Salmon-Built-Designs/QUTMS_BMS/hardware/BMS_2020/BMS-P00-V01.PcbDoc.htm

Reporting Options

# File in Previous Format

Date | : | 10/11/2021
Time | : | 4:04:51 PM
Filename | : | C:\JohnStaffRepos\QUTMS_BMS\hardware\BMS_2020\BMS-P00-V01.PcbDoc

Version | Warning

This file was generated by an earlier version of the software
