Salmon-Built-Designs/QUTMS_BMS/hardware/QUTMS-BMS-TEMPSTRIP-RIGHT-V00/BMS-TEMPSTRIP-RIGHT-P00.PcbDoc.htm

Reporting Options

# File in Newer Format

Date | : | 28/07/2020
Time | : | 12:10:48 PM
Filename | : | C:\Users\n8888833\Documents\GitHub\QUTMS_BMS_2020\hardware\QUTMS-BMS-TEMPSTRIP-RIGHT-V00\BMS-TEMPSTRIP-RIGHT-P00.PcbDoc

Version | Warning
Release 20.0 | CAUTION - Support of propagation delay for primitives

This file was generated by a later version of the software
