Salmon-Built-Designs/QUTMS_BMS/hardware/BMS_2020/LMR14010A_Calculations.xlsx

LMR14010A
Settings |  |  |  | Inductor Calculations |  | Output Capacitor Calulations
Switching Frequency | 0.7 | Mhz |  | L_o min | 70.71 | Cout min | 2.308802309e-05
 | 700 | KHz |  | I_ripple | 6e-08 | Cout min | 8.48
 | 700000 | Hz | f_sw | I_L_RMS | 0.2 | Cout min | 2.142857143e-13
Input Voltage Max | 33 | V | Vin_max | I_L_Peak | 0.3 | R_ESR | 833333.33
Current Out | 0.2 | A | I_o
Ripple Current | 30.00% | % | K_IND | Choosen Lo | 150
Output Voltage | 3.3 | V | V_out
Transient | 0.03 | %
Output Current High | 0.2 | A | I_oH
Output Current Low | 0.05 | A | I_oL
Initial Capacitor Voltage | 3.3 | V | Vi
Voltage Peak Output | 3.399 | V | Vf
delta I_out | 0.8 | I
delta V_out | 0.099 | V
Max voltage ripple | 0.05 | V | V_o_ripple
