Salmon-Built-Designs/QUTMS_BMS/hardware/BMS_2020/BMS-P00-V00.PcbDoc.htm

Reporting Options

# File in Newer Format

Date | : | 1/10/2020
Time | : | 4:02:43 PM
Filename | : | C:\Users\n8888833\Documents\GitHub\QUTMS_BMS\hardware\BMS_2020\BMS-P00-V00.PcbDoc

Version | Warning
Release 20.0 | CAUTION - Support of propagation delay for primitives

This file was generated by a later version of the software
