Salmon-Built-Designs/QUTMS_BMS/hardware/BMS_2020/wideVOptoResistorSelection.PNG

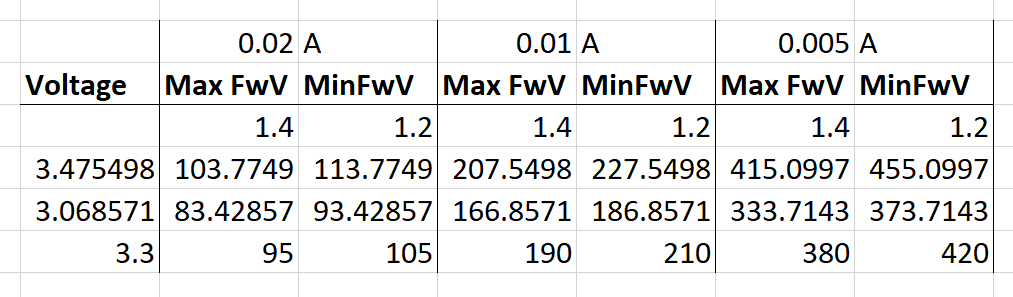
hardware/BMS_2020/wideVOptoResistorSelection.PNG
