Salmon-Built-Designs/QUTMS_BMS/QUTMS-BMS-V00.xlsx

Comment | Description | Designator | Footprint | LibRef | Quantity
100nF | Capacitor, Ceramic, SMD, 100nF, 50V, 5%, X7R, 0603 | C1, C3, C5, C7, C8, C9, C10, C11 | CAP_CERAMIC_0603 | 100nF 50V 5% X7R 0603 | 8
4u7 | Capacitor, Ceramic, SMD, 4u7, 50V, 5%, X7R, 0603 | C2, C4, C6 | CAP_CERAMIC_0603 | 4u7 50V 5% X7R 0603 | 3
100nF 100V | Capacitor, Ceramic, SMD, 100nF, 100V, 5%, X7R, 0603 | C12 | CAP_CERAMIC_0603 | 100nF 100V 5% X7R 0603 | 1
47uF 80V 10% AluPoly 10x10mm | Capacitor, AluPoly, SMD, 47uF, 80V, 10%, AluPoly, 10x10mm | C13 | CAP_ALU_10X10MM | 47uF 80V 10% AluPoly 10x10mm | 1
47uF 16V 1210 | Capacitor, Ceramic, SMD, 47uF, 16V, 5%, X7R, 1210 | C14, C15 | CAP_CERAMIC_0603 | 47uF 16V 10% X7R 1210 | 2
220nF | Capacitor, Ceramic, SMD, 220nF, 50V, 5%, X7R, 0603 | C16A, C16B, C16C, C16D, C16E, C16F, C16G, C16H, C16I, C16J, C17, C20, C25, C26 | CAP_CERAMIC_0603 | 220nF 50V 5% X7R 0603 | 14
1uF 25V | Capacitor, Ceramic, SMD, 1uF, 25V, 5%, X7R, 0603 | C18, C21, C24 | CAP_CERAMIC_0603 | 1uF 25V 5% X7R 0603 | 3
10uF 25V 0805 | Capacitor, Ceramic, SMD, 10uF, 25V, 5%, X7R, 0805 | C19 | CAP_CERAMIC_0805 | 10uF 25V 5% X7R 0805_1 | 1
470nF | Capacitor, Ceramic, SMD, 470nF, 50V, 5%, X7R, 0603 | C22 | CAP_CERAMIC_0603 | 470nF 50V 5% X7R 0603 | 1
10uF 25V 1206 | Capacitor, Ceramic, SMD, 10uF, 25V, 10%, X7R, 1206 | C23 | CAP_CERAMIC_1206 | 10uF 25V 10% X7R 1206 | 1
NUP2105L | NUP2105L | D1 | NUP2105L | NUP2105L | 1
B260A-13-F | Diode, Schottky Barrier Rectifier, 60 V, 2 A, B260A-13-F | D2 | SMA | B260A-13-F | 1
BZT52C5V6-7-F | Diode, SMD, Zender, 5.6V, 7%, 500mW, SOD-123 | D3A, D3B, D3C, D3D, D3E, D3F, D3G, D3H, D3I, D3J | SOD123 | BZT52C5V6-7-F | 10
1N4448WQ-7-F | Diode, SMD, 75V, 5%, 250mA, SOD123 | D4, D5, D6 | SMA | 1N4448WQ-7-F | 3
LED Orange | 603 | DS1, DS2 | LED ORANGE 0603 | LED ORANGE 0603 | 2
LED Blue 0603 | 603 | DS3, DS4 | LED BLUE 0603 | LED BLUE 0603 | 2
3412.0124.22 | FUSE BOARD MOUNT 5A 63VDC 0603 | F1, F2, F3, F4, F5, F6, F7, F8, F9, F10, F11, F12, F13 | 3412.0124.22 | 3412.0124.22 | 13
Fiducial 1MM | Fiducial 1MM | FID1, FID2, FID3, FID4 | FIDUCIAL 1MM | Fiducial 1MM | 4
IDC 10P 2x5 1.27mm | IDC 10P 2x5 1.27mm | J1 | IDC 1.27MM 10P | IDC 10P 2x5 1.27mm | 1
IDC 8P 2x4 | IDC 8P 2x5 | J2, J3 | IDC 2.54MM 8P | IDC 8P 2x4 | 2
Jumper 2Way Pins | Jumper 2Way Side Pins | J4, J5, J6 | Jumper_2Way_Pin | Jumper 2Way Side Pins | 3
0526100672 | 0526100672 | J7A, J7B, J7C, J7D | 526100672 | 6PinMOLEX | 4
Bleed Header | Header, 2-Pin | J8A, J8B, J8C, J8D, J8E, J8F, J8G, J8H, J8I, J8J | HDR1X2 | Header 2 | 10
436500519 |  | J9 | Microfit_1X5_V_TH | Microfit_1x5 | 1
436500819 |  | J10 | Microfit_1X8_V_TH | Microfit_1x8 | 1
74404064221 | FIXED IND 220UH 660MA 850 MOHM | L1 | Inductor_6x6mm | 74404064221 | 1
LBL High Voltage M | LBL High Voltage M | LOGO1, LOGO2 | LBL HV MEDIUM | LBL High Voltage M | 2
30mm Wide QUTMS Logo | 30mm Wide QUTMS Logo | LOGO3 | QUTMS LOGO 30MM | QUTMS Logo 30mm | 1
2 Layer Identification PCB Marker | 2 Layer Identification PCB Marker | LYID1 | LAYER IDENT 2 | Layer Identification 2 | 1
Hole M3 Tight Unplated | M3.2 Hole, No Plating | M3, M4 | M3.2 UNPLATED | Hole M3 Tight Unplated | 2
7695-2 | SNAP-INPC MOUNT | M5, M6, M7, M8 | Keystone 7790 | 7695-2 | 4
UART | Header, 3-Pin | P1 | HDR1X3 | Header 3 | 1
Header 4 | Header, 4-Pin | P2 | HDR1X4 | Header 4 | 1
PMV15UNEAR | MOSFET N-CH, 20V, SOT23 | Q1A, Q1B, Q1C, Q1D, Q1E, Q1F, Q1G, Q1H, Q1I, Q1J | SOT23 | PMV15UNEAR | 10
BST82,215 | MOSFET N-CH, 20V, SOT23 | Q2, Q3 | BST82,215 | BST82,215 | 2
2k2 | Resistor, SMD, 2k2, 0.1W, 5%, 0603 | R1, R2 | Res_ThinFilm_0603 | 2k2 5% 0603 | 2
4k7 | Resistor, SMD, 4k7, 0.1W, 5%, 0603 | R3 | Res_ThinFilm_0603 | 4k7 5% 0603 | 1
330R | Resistor, SMD, 330R, 0.1W, 5%, 0603 | R4, R5, R8, R9 | Res_ThinFilm_0603 | 330R 5% 0603 | 4
100R | Resistor, SMD, 100R, 0.1W, 5%, 0603 | R6, R25, R26 | Res_ThinFilm_0603 | 100R 5%, 0603 | 3
150R | Resistor, SMD, 150R, 0.1W, 5%, 0603 | R7 | Res_ThinFilm_0603 | 150R 5% 0603 | 1
120R 1% 1210 | Resistor, SMD, 120R, 0.25W, 1%, 1210 | R10 | Res_ThinFilm_1210 | 120R 1% 1210 | 1
0R | Resistor, SMD, 0R, 0.1W, 5%, 0603 | R11A, R11B, R11C, R11D, R23 | Res_ThinFilm_0603 | 0R 5% 0603 | 5
10k 1% | Resistor, SMD, 10k, 0.1W, 1%, 0603 | R12 | Res_ThinFilm_0603 | 10k 1% 0603 | 1
64k9 1% | Resistor, SMD, 64k9, 0.1W, 5%, 0603 | R13 | Res_ThinFilm_0603 | 64k9 1% 0603 | 1
620R 1% | Resistor, SMD, 680R, 0.1W, 5%, 0603 | R14 | Res_ThinFilm_0603 | 620R 1% 0603 | 1
19k6 1% | Resistor, SMD, 19k6, 0.1W, 5%, 0603 | R15 | Res_ThinFilm_0603 | 19k6 1% 0603 | 1
1k | Resistor, SMD, 1k, 0.1W, 5%, 0603 | R16A, R16B, R16C, R16D, R16E, R16F, R16G, R16H, R16I, R16J, R17A, R17B, R17C, R17D, R17E, R17F, R17G, R17H, R17I, R17J, R28, R29, R32 | Res_ThinFilm_0603 | 1k 5% 0603 | 23
10k | Resistor, SMD, 10k, 0.1W, 5%, 0603 | R18, R19, R21, R22, R24, R27, R30, R31, R33 | Res_ThinFilm_0603 | 10k 5% 0603 | 9
10M | Resistor, SMD, 10M, 0.1W, 5%, 0603 | R20 | Res_ThinFilm_0603 | 10M 5% 0603 | 1
DNF 0603 | Resistor, SMD, DNF, 0.1W, 0603 | R34 | Res_ThinFilm_0603 | DNF 0603 | 1
B3U-1000P | Omron B3U-1000P Ultra Miniture Switch | SW1, SW2 | BTN B3U-1000P | BTN B3U-1000P | 2
TestPoint_SMD |  | TP7, TP8, TP9 | TestPointSMD | TestPoint_SMD | 3
STM32F042C6 | ARM® Cortex®-M0 STM32F0 Microcontroller IC 32-Bit 48MHz 32KB (32K x 8) FLASH 48-LQFP (7x7) | U1 | STM32F042C6 | STM32042C6 | 1
DSC1001DI1-008.0000T | on 8MHz XO (Standard) CMOS Oscillator 1.8 ~ 3.3V Standby (Power Down) 4-SMD, No Lead | U2 | DSC1001DI1-008.0000TCT-ND | DSC1001DI1-008.0000T | 1
FOD817ASD | Optoisolator 5kV Transistor 4SMD | U3, U4 | FOD817ASD | FOD817ASD | 2
Si8621BC-B-IS | Si8621BC-B-IS | U5 | Si8621BC-B-IS | Si8621BC-B-IS | 1
SN65HVD233 | SN65HVD233 | U6 | SN65HVD233DR | SN65HVD233 | 1
LMR14010 |  | U7 | LMR14010 | LMR14010 | 1
BQ76930 | Battery Monitoring/Fuel Gauge Li-Ion/Li-Polymer/LiFePO4 0V to 16V 30-Pin TSSOP T/R | U8 | BQ76930 | BQ76930 | 1
BQ76200 | High-voltage battery pack front-end charge/discharge high-side NFET driver | U9 | BQ76200 | BQ76200PWR | 1
LogicAnalyzerBreakOut |  | Z1, Z2 | LogicAnalyzer | LogicAnalyer | 2
