Salmon-Built-Designs/QUTMS_BMS/hardware/BMS_2020/keystone-PN7790.STEP

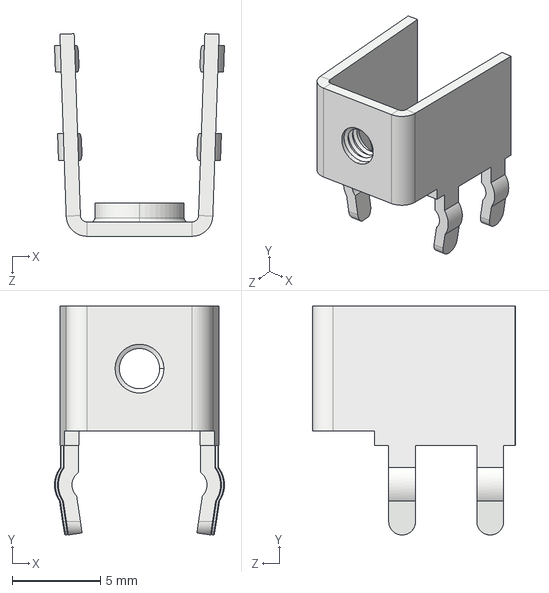
[picture p2: CAD file, 2020-07-09]
hardware/BMS_2020/keystone-PN7790.STEP
9.66 x 13.0 x 11.5 mm
