Salmon-Built-Designs/QUTMS_BMS/hardware/BMS_2020/SOT-23-6.stp

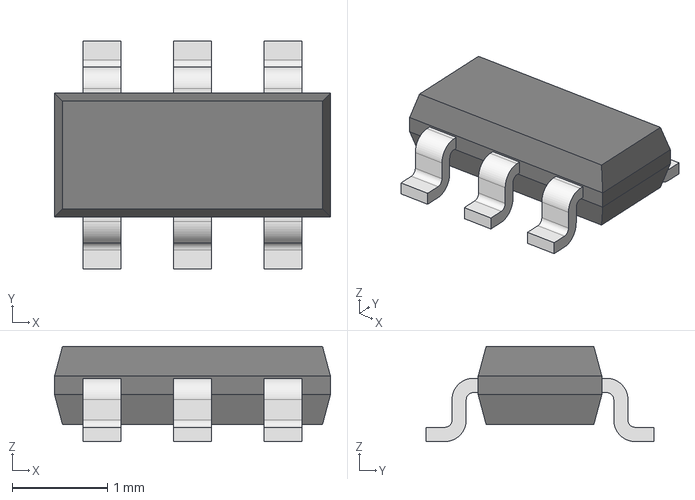
[picture p3: CAD file, 2020-05-05]
hardware/BMS_2020/SOT-23-6.stp
2.90 x 2.40 x 1 mm
