Salmon-Built-Designs/QUTMS_BMS/hardware/BMS_2020/D0008A.stp

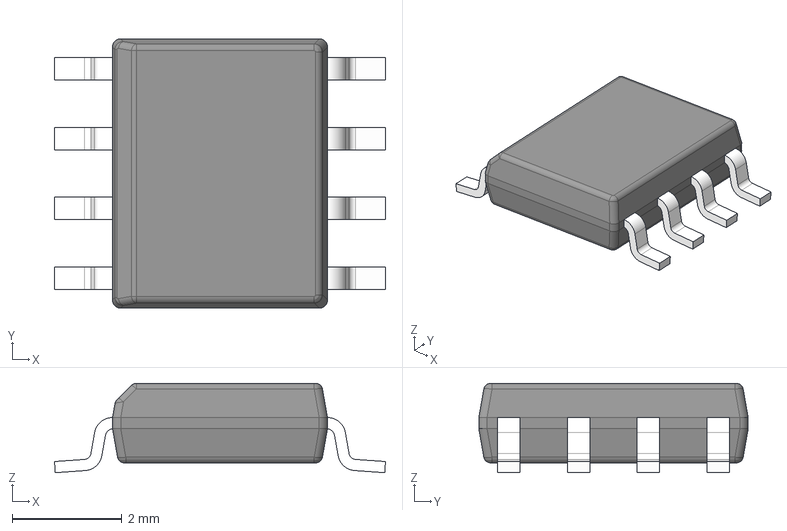
[picture p5: CAD file, 2020-05-05]
hardware/BMS_2020/D0008A.stp
6.02 x 4.90 x 1.63 mm
BODY-SO
LEAD-D0008A x 8
