Salmon-Built-Designs/QUTMS_BMS/hardware/BMS_2020/LQFP48.STEP

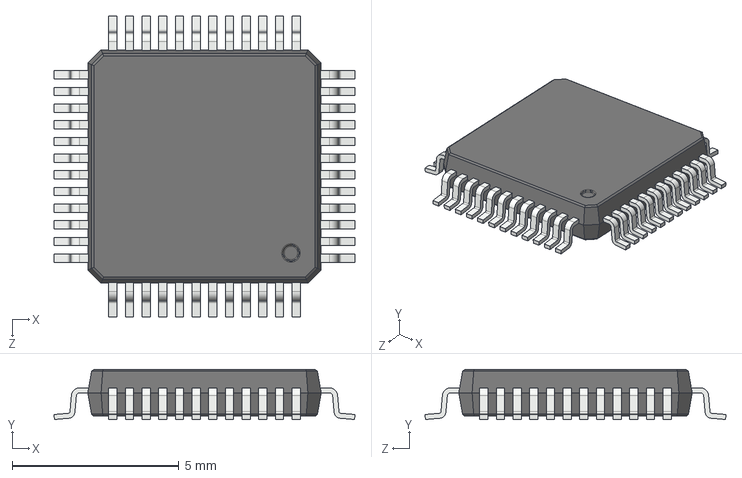
[picture p7: CAD file, 2020-05-05]
hardware/BMS_2020/LQFP48.STEP
9.03 x 1.50 x 9.03 mm
