Salmon-Built-Designs/QUTMS_BMS/hardware/BMS_2020/77311-y18-02_asm.stp

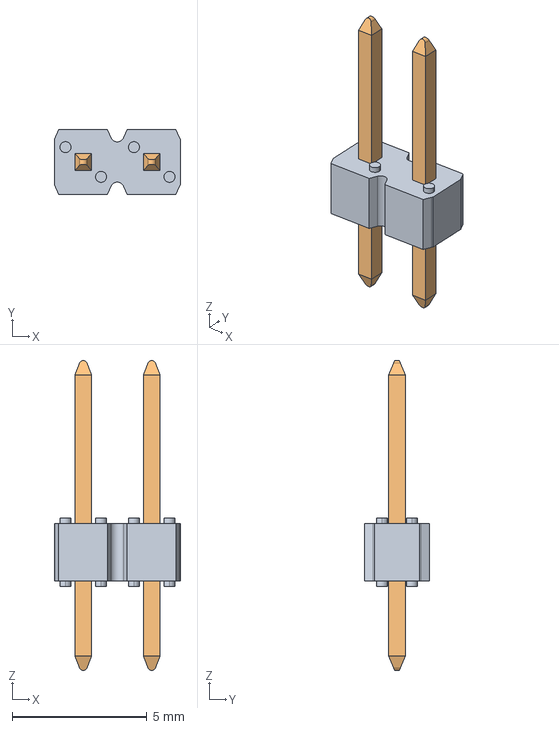
[picture p8: CAD file, 2020-05-05]
hardware/BMS_2020/77311-y18-02_asm.stp
4.68 x 2.41 x 11.5 mm
77310_Y16 x 2
