Salmon-Built-Designs/QUTMS_BMS/hardware/BMS_2020/77311-y18-03_asm.stp

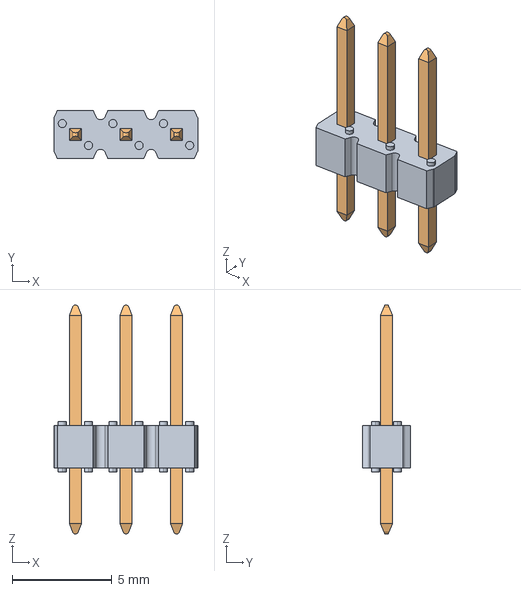
[picture p9: CAD file, 2020-05-05]
hardware/BMS_2020/77311-y18-03_asm.stp
7.22 x 2.41 x 11.5 mm
77310_Y16 x 3
