Salmon-Built-Designs/QUTMS_BMS/hardware/BMS_2020/436500519.stp

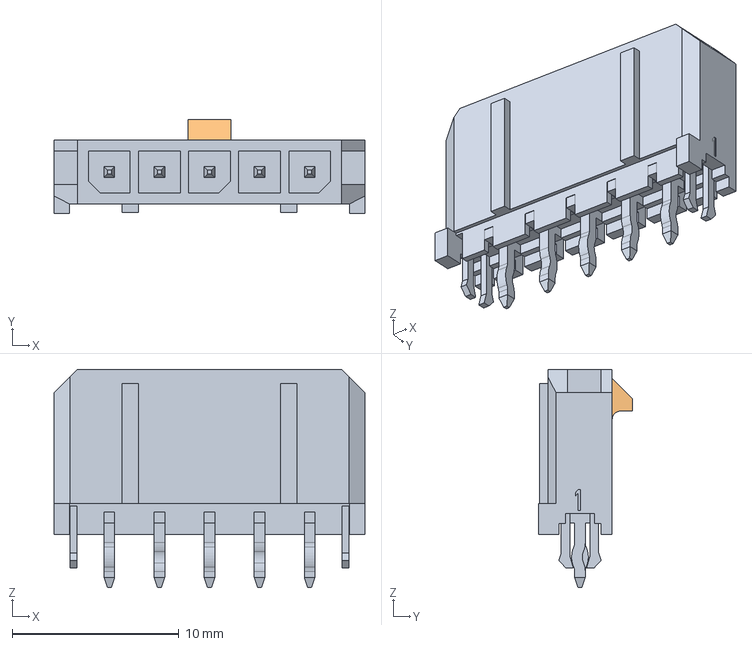
[picture p10: CAD file, 2020-06-28]
hardware/BMS_2020/436500519.stp
18.6 x 5.61 x 13.1 mm
