Salmon-Built-Designs/QUTMS_BMS/hardware/BMS_2020/436500525.stp

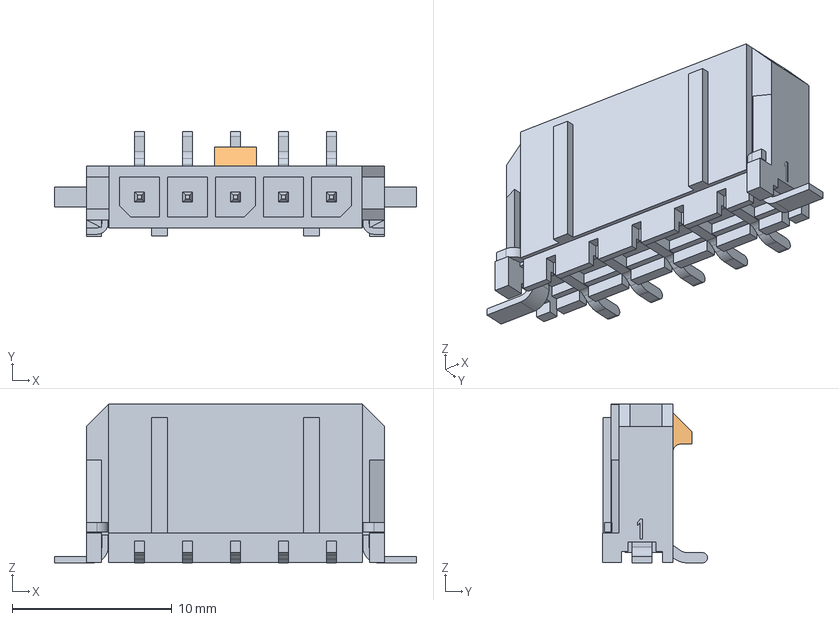
[picture p12: CAD file, 2020-06-28]
hardware/BMS_2020/436500525.stp
22.6 x 6.57 x 9.93 mm
