Salmon-Built-Designs/QUTMS_BMS/hardware/BMS_2020/436500825.stp

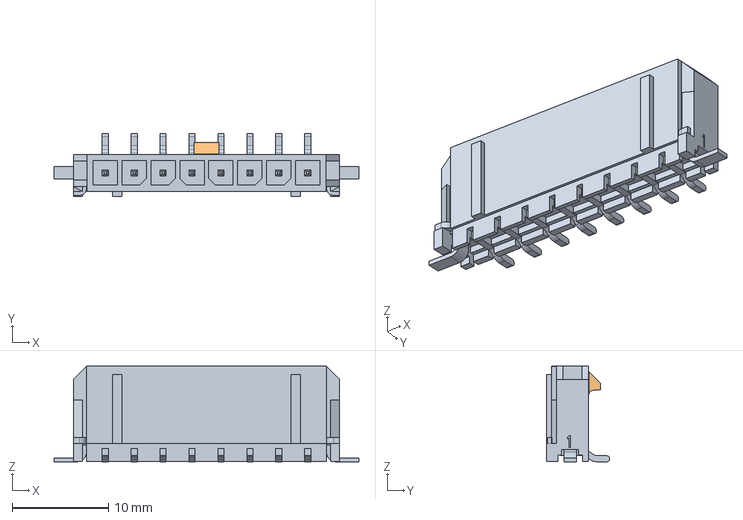
[picture p13: CAD file, 2020-06-28]
hardware/BMS_2020/436500825.stp
31.6 x 6.57 x 9.93 mm
