Salmon-Built-Designs/QUTMS_BMS/hardware/BMS_2020/522710479.stp

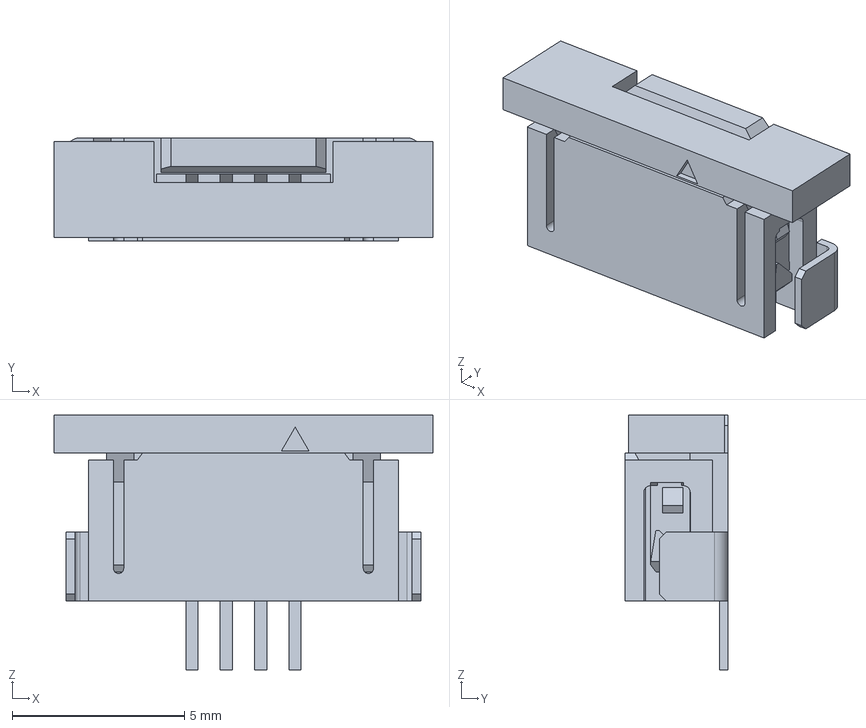
[picture p14: CAD file, 2020-05-12]
hardware/BMS_2020/522710479.stp
11.0 x 3.00 x 7.40 mm
