Salmon-Built-Designs/QUTMS_BMS/hardware/BMS_2020/74404064221_WE-LQS.stp

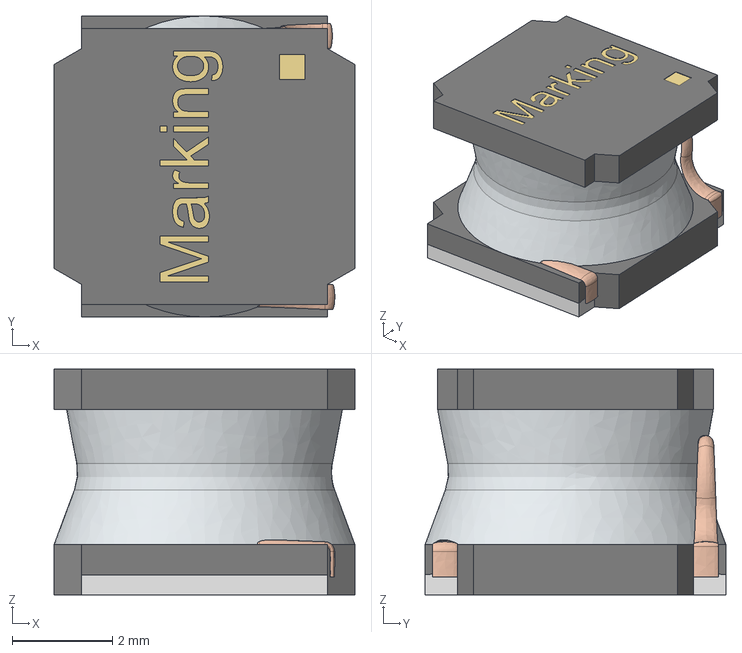
[picture p15: CAD file, 2020-05-05]
hardware/BMS_2020/74404064221_WE-LQS.stp
6.00 x 6.00 x 4.50 mm
