Salmon-Built-Designs/QUTMS_BMS/hardware/BMS_2020/526100672.stp

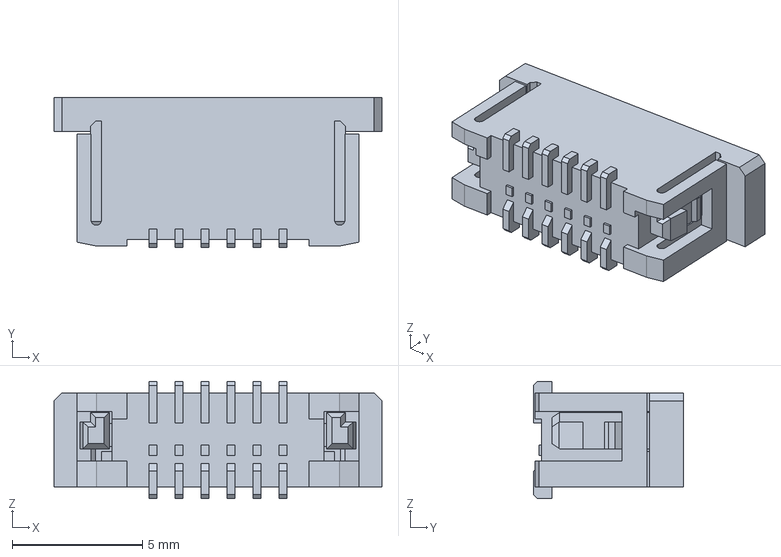
[picture p16: CAD file, 2020-04-25]
hardware/BMS_2020/526100672.stp
12.6 x 5.75 x 4.50 mm
