Salmon-Built-Designs/QUTMS_BMS/hardware/BMS_2020/522710679.stp

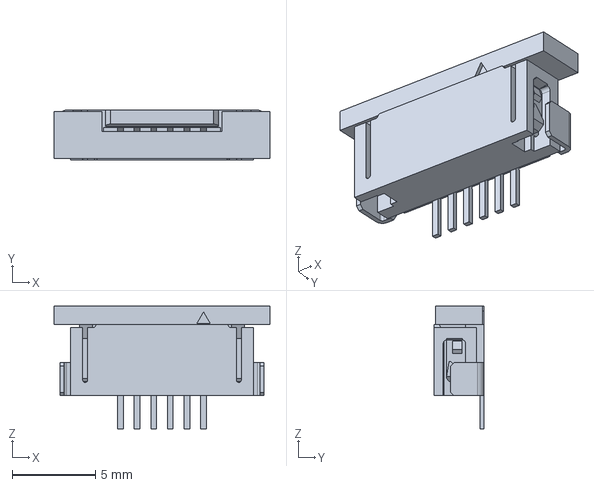
[picture p17: CAD file, 2020-04-25]
hardware/BMS_2020/522710679.stp
13.0 x 3.00 x 7.40 mm
