Salmon-Built-Designs/QUTMS_BMS/hardware/BMS_2020/526100872.stp

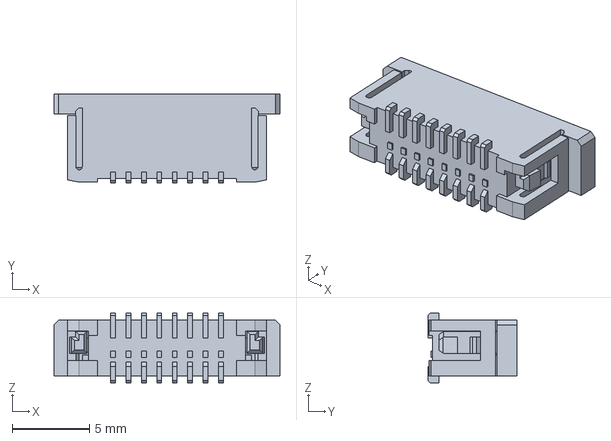
[picture p18: CAD file, 2020-04-25]
hardware/BMS_2020/526100872.stp
14.6 x 5.75 x 4.50 mm
