Salmon-Built-Designs/QUTMS_BMS/hardware/BMS_2020/526101272.stp

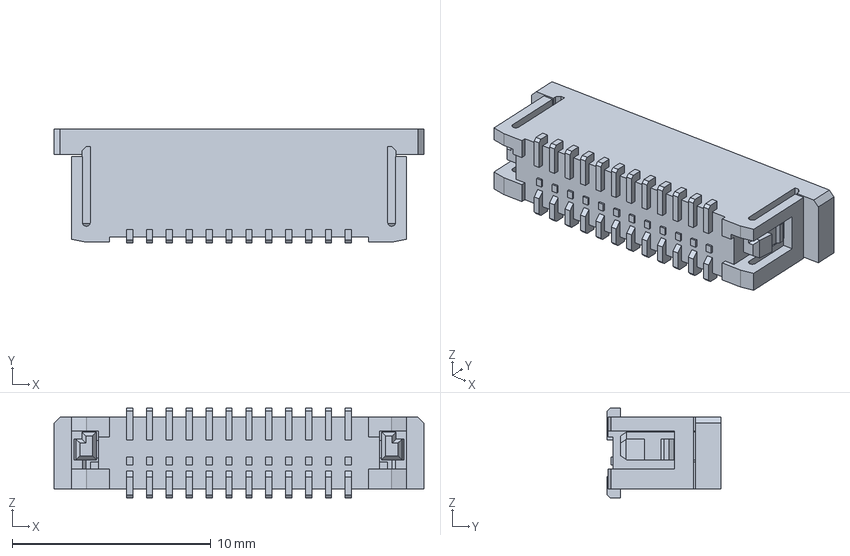
[picture p19: CAD file, 2020-04-25]
hardware/BMS_2020/526101272.stp
18.6 x 5.75 x 4.50 mm
