Salmon-Built-Designs/QUTMS_BMS/(list of files, cad)

Other CAD files:
hardware/BMS_2020/522710879.stp
