Salmon-Built-Designs/QUTMS_BMS/hardware/BMS_2020/QUTMS-BMS-V00.pdf

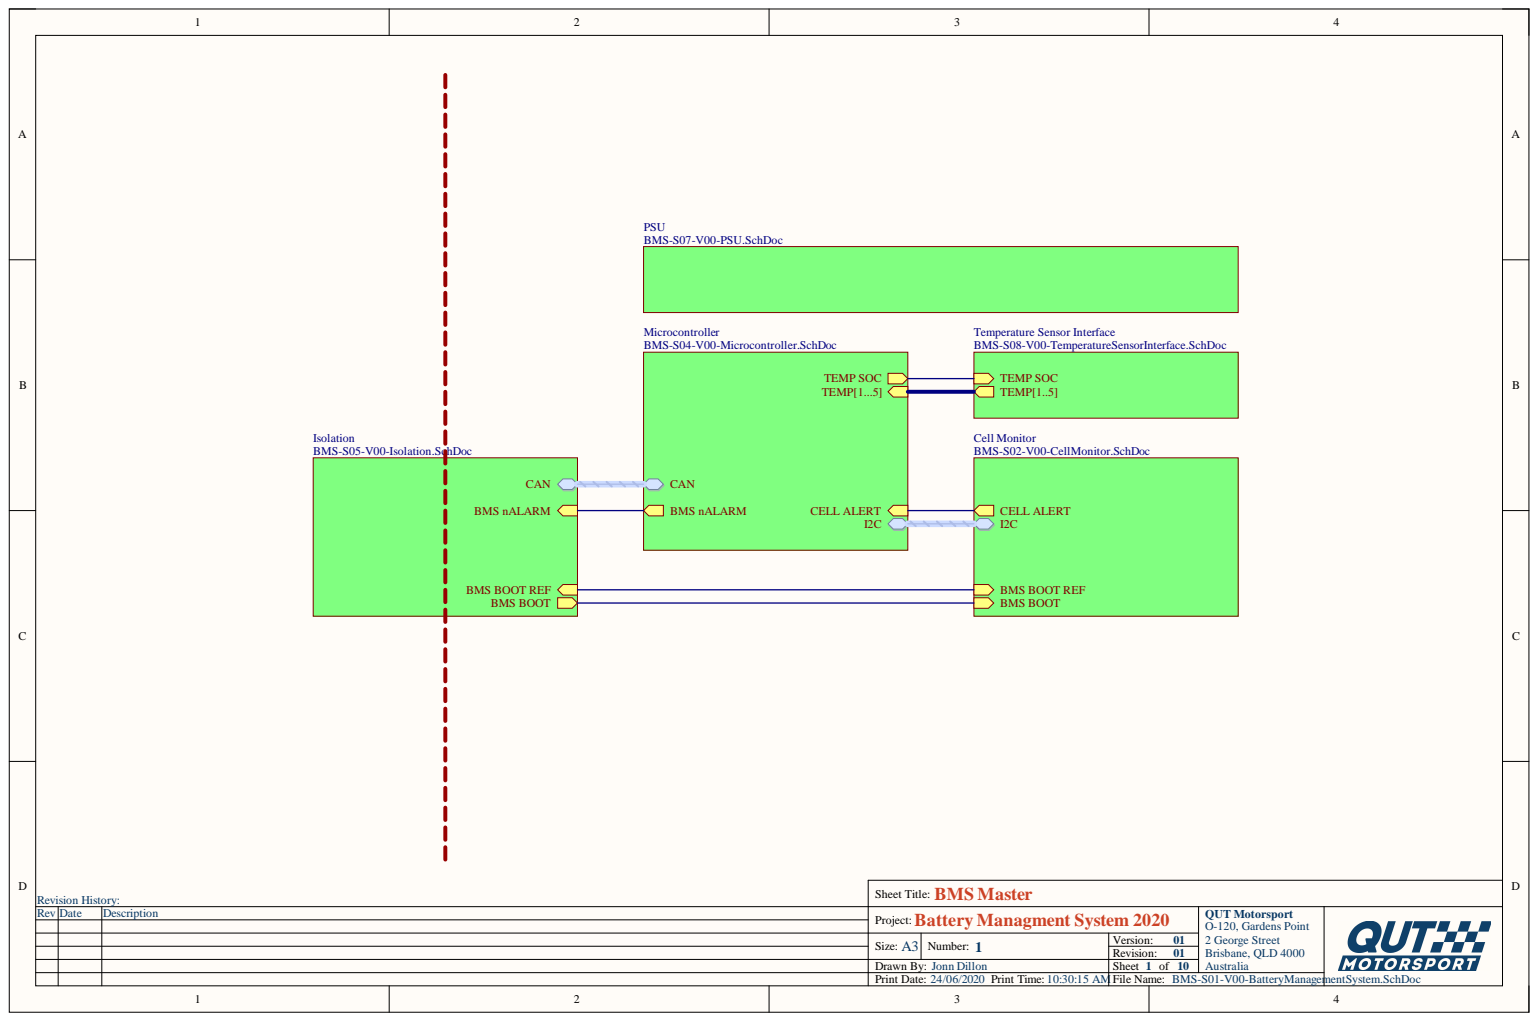
[picture p20: page 1]

Sheet Title: BMS Master Rev
Revision History:

Drawn By: Jonn Dillon

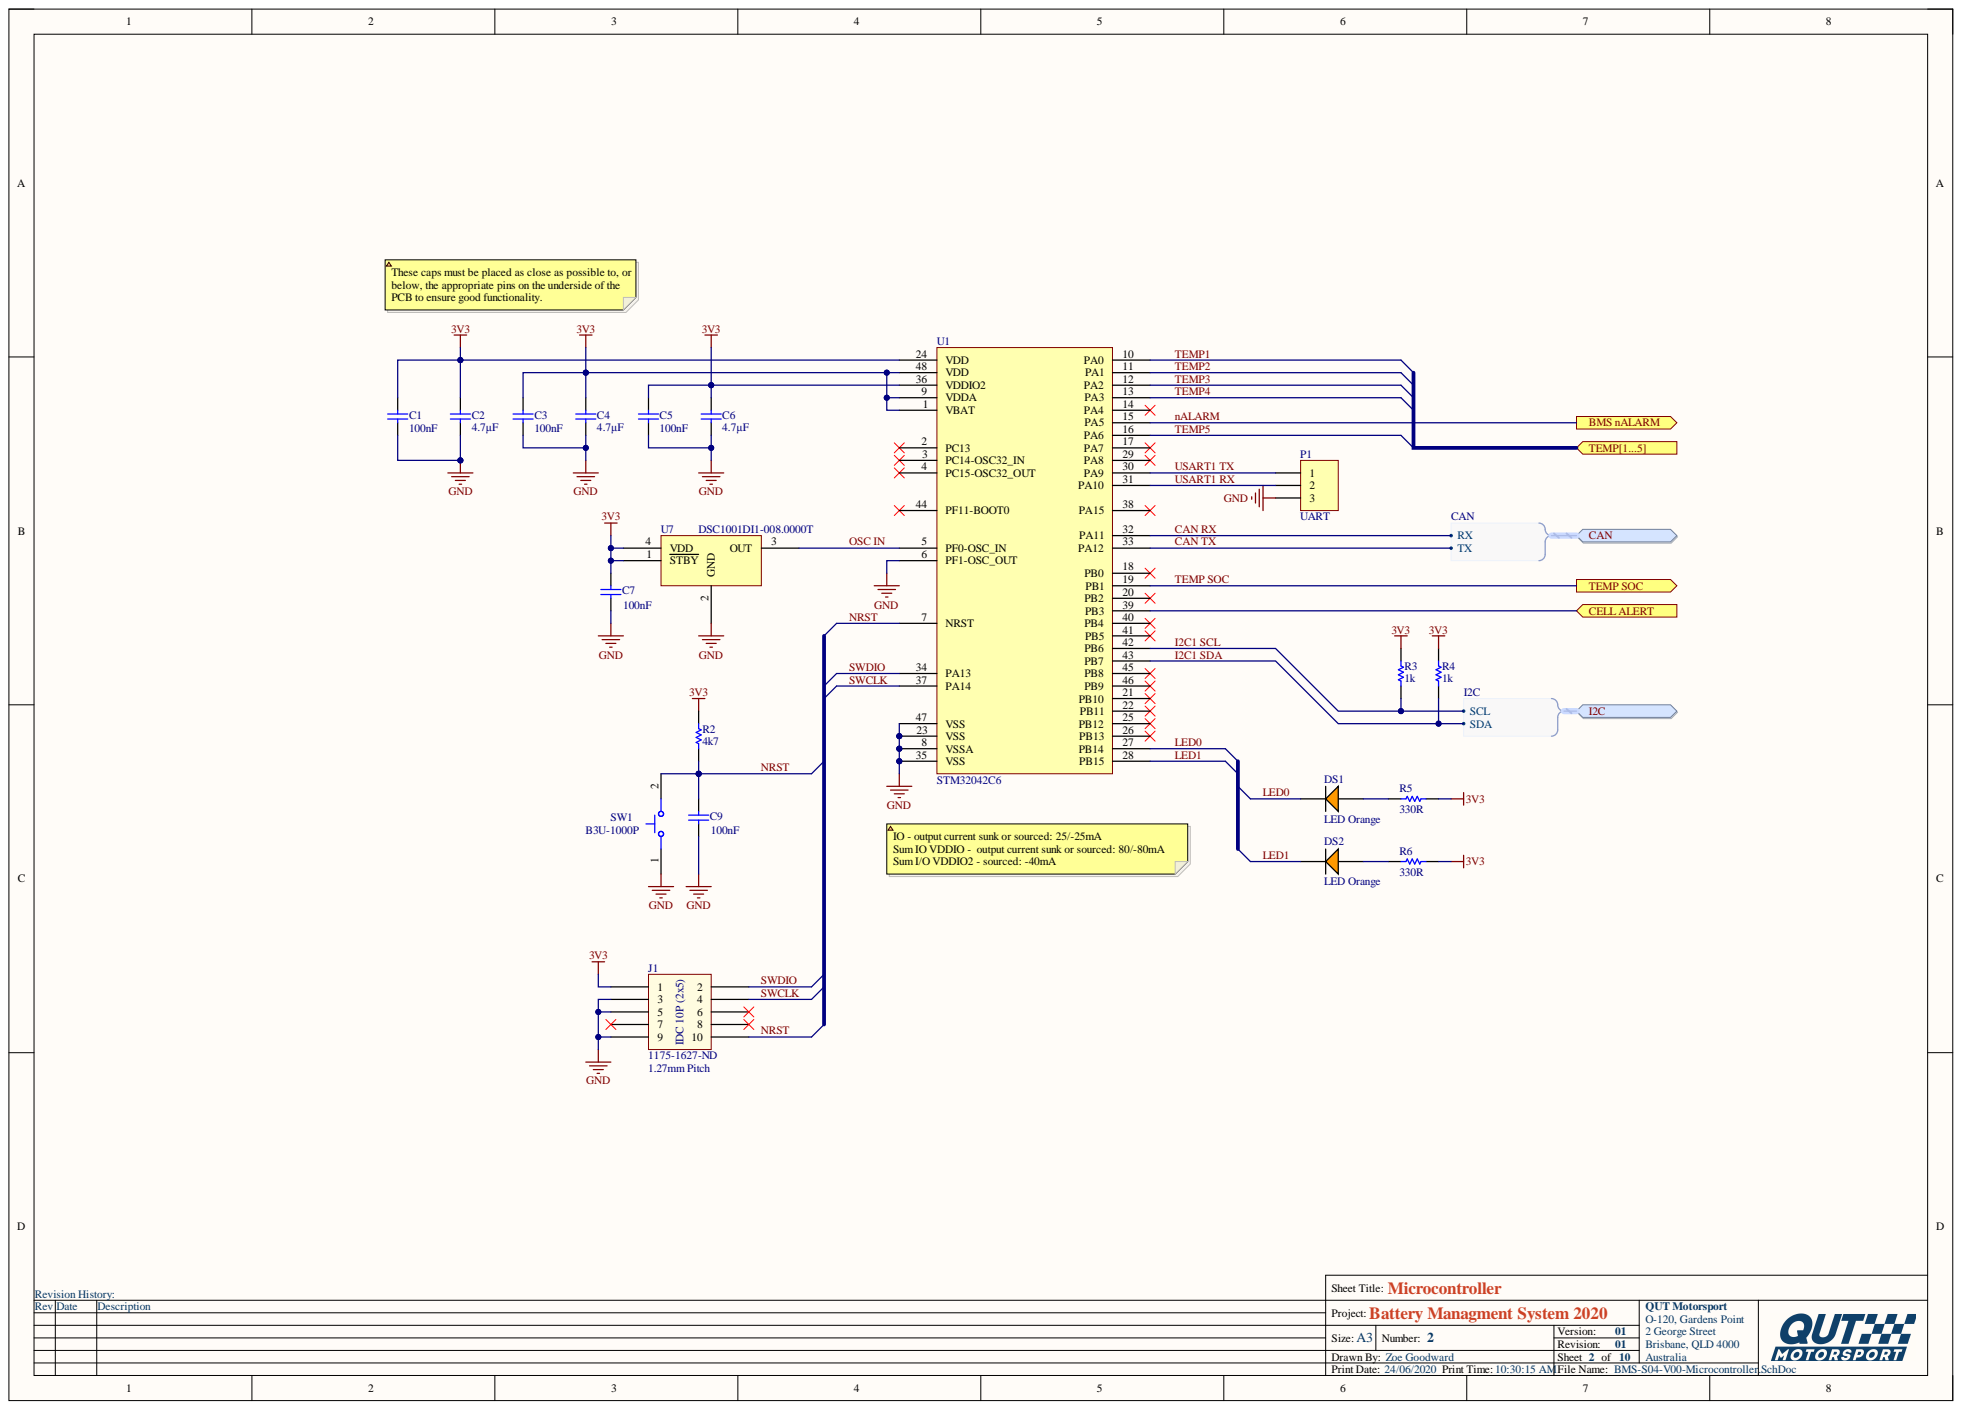
[picture p21: page 2]

t be placed as close as pos

9 | T E MP4
1 | nA LA R M

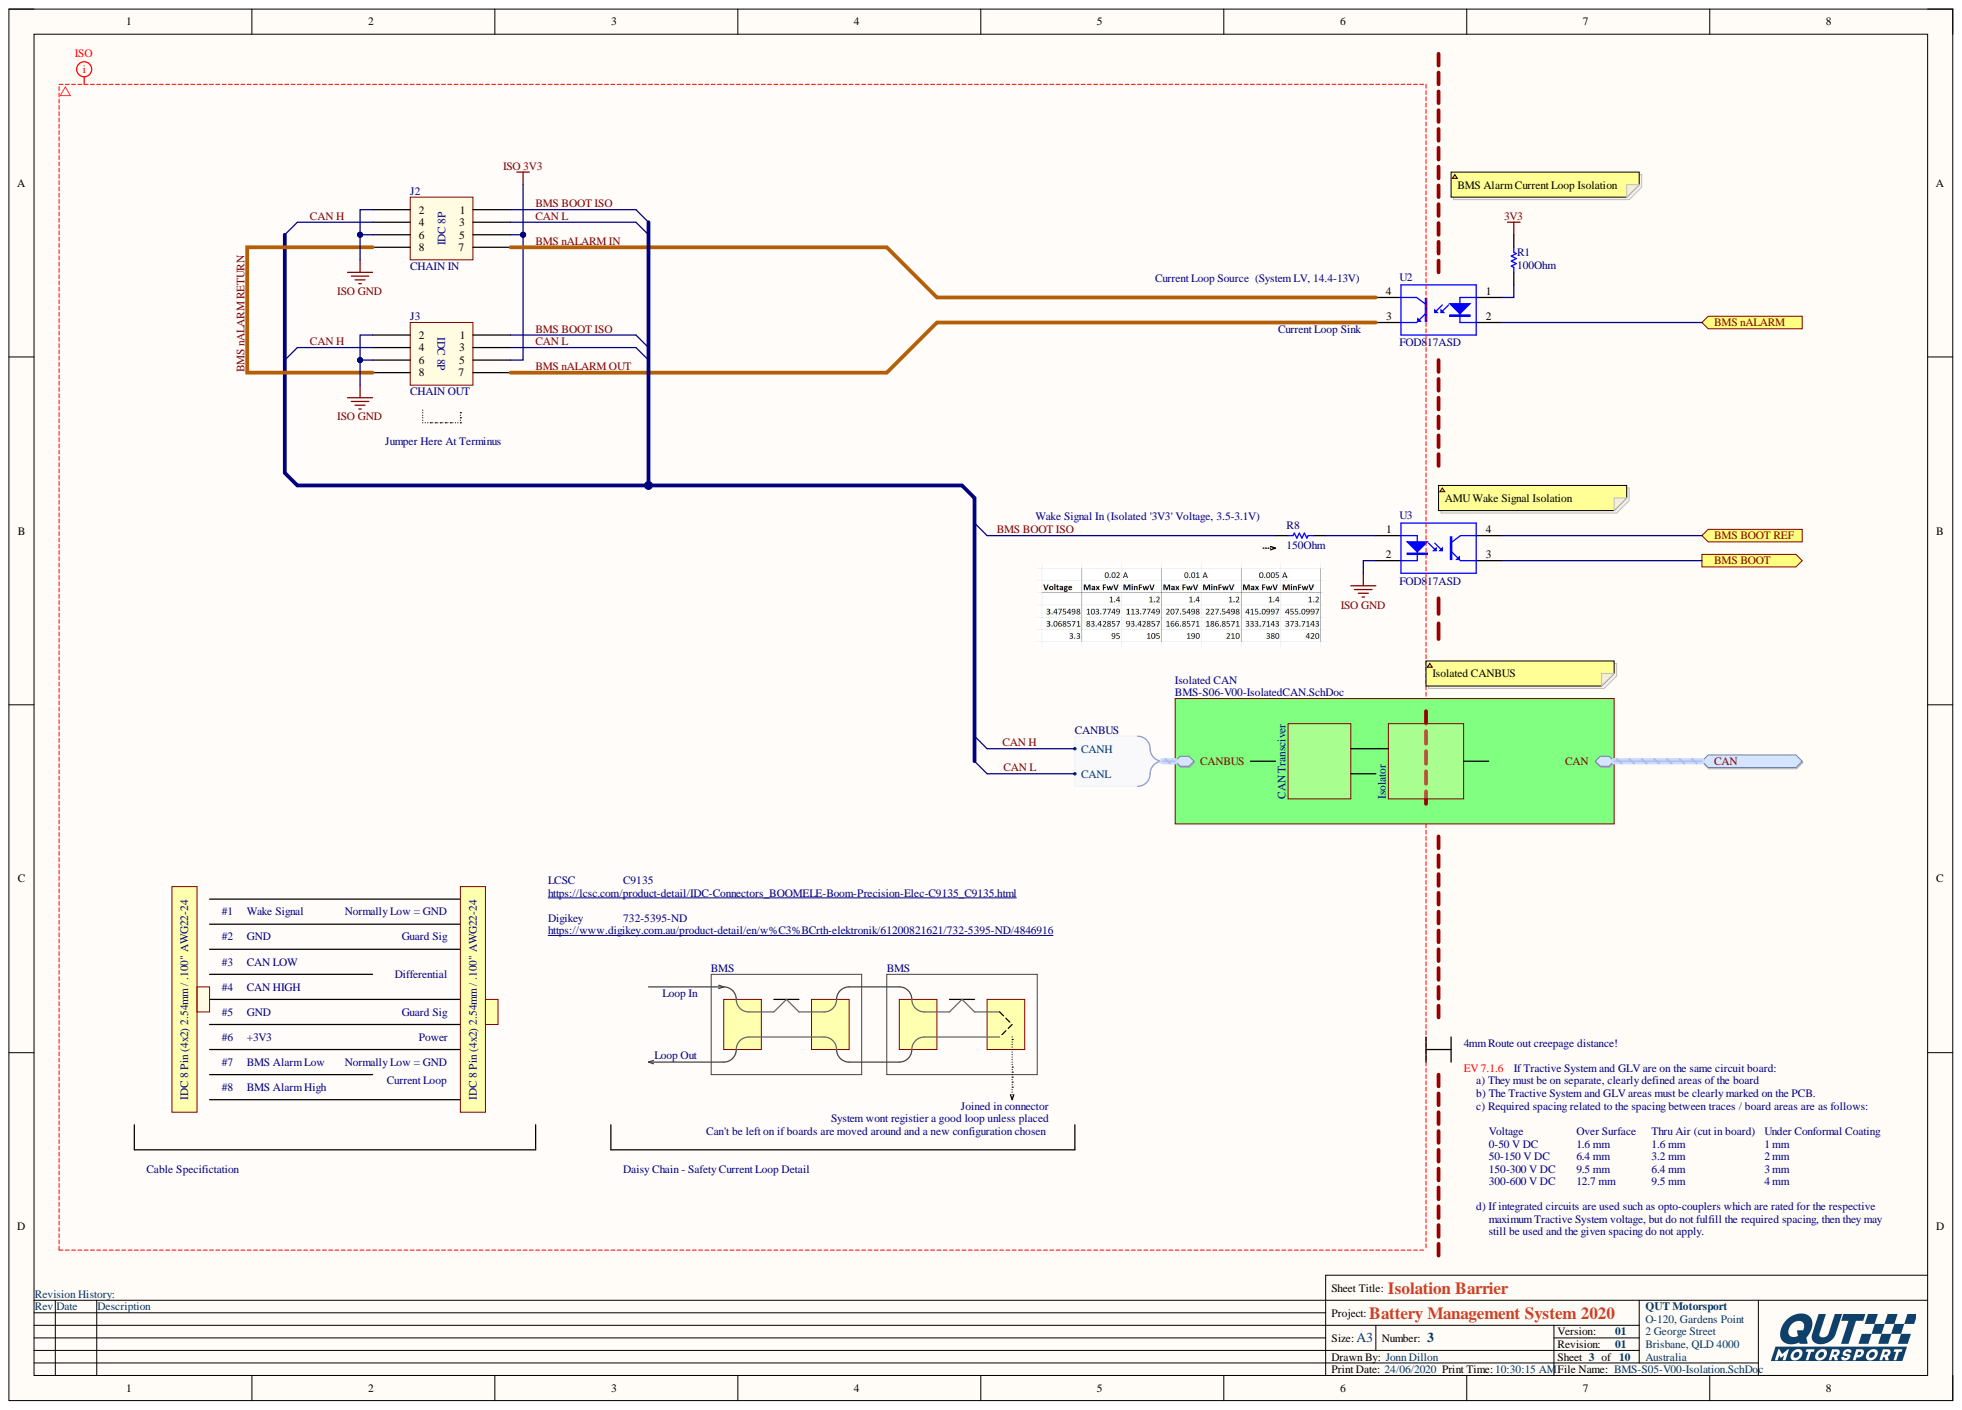
[picture p22: page 3]

BMS Alarm Current Loop Isolation

Current Loop Source (System LV, 14.4-13V)

Jumper Here At Terminus

AMU Wake Signal Isolation

Wake Signal In (Isolated '3V3' Voltage, 3.5-3.1V)

LCSC
https://lcsc.com/product-detail/IDC-Connectors_BOOMELE-Boom-Precision-Elec-C9135_C9135.html

Digikey
https://www.digikey.com.au/product-detail/en/w%C3%BCrth-elektronik/61200821621/732-5395-ND/4846916

4mm Route out creepage distance!

EV 7.1.6 If Tractive System and GLV are on the same circuit board:
a) They must be on separate, clearly defined areas of the board
b) The Tractive System and GLV areas must be clearly marked on the PCB.
c) Required spacing related to the spacing between traces / board areas are as follows:

Can't be left on if boards are moved around and a new configuration chosen

System wont registier a good loop unless placed

d) If integrated circuits are used such as opto-couplers which are rated for the respective
maximum Tractive System voltage, but do not fulfill the required spacing, then they may
still be used and the given spacing do not apply.

Sheet Title: Isolation Barrier
Battery Management System 2020

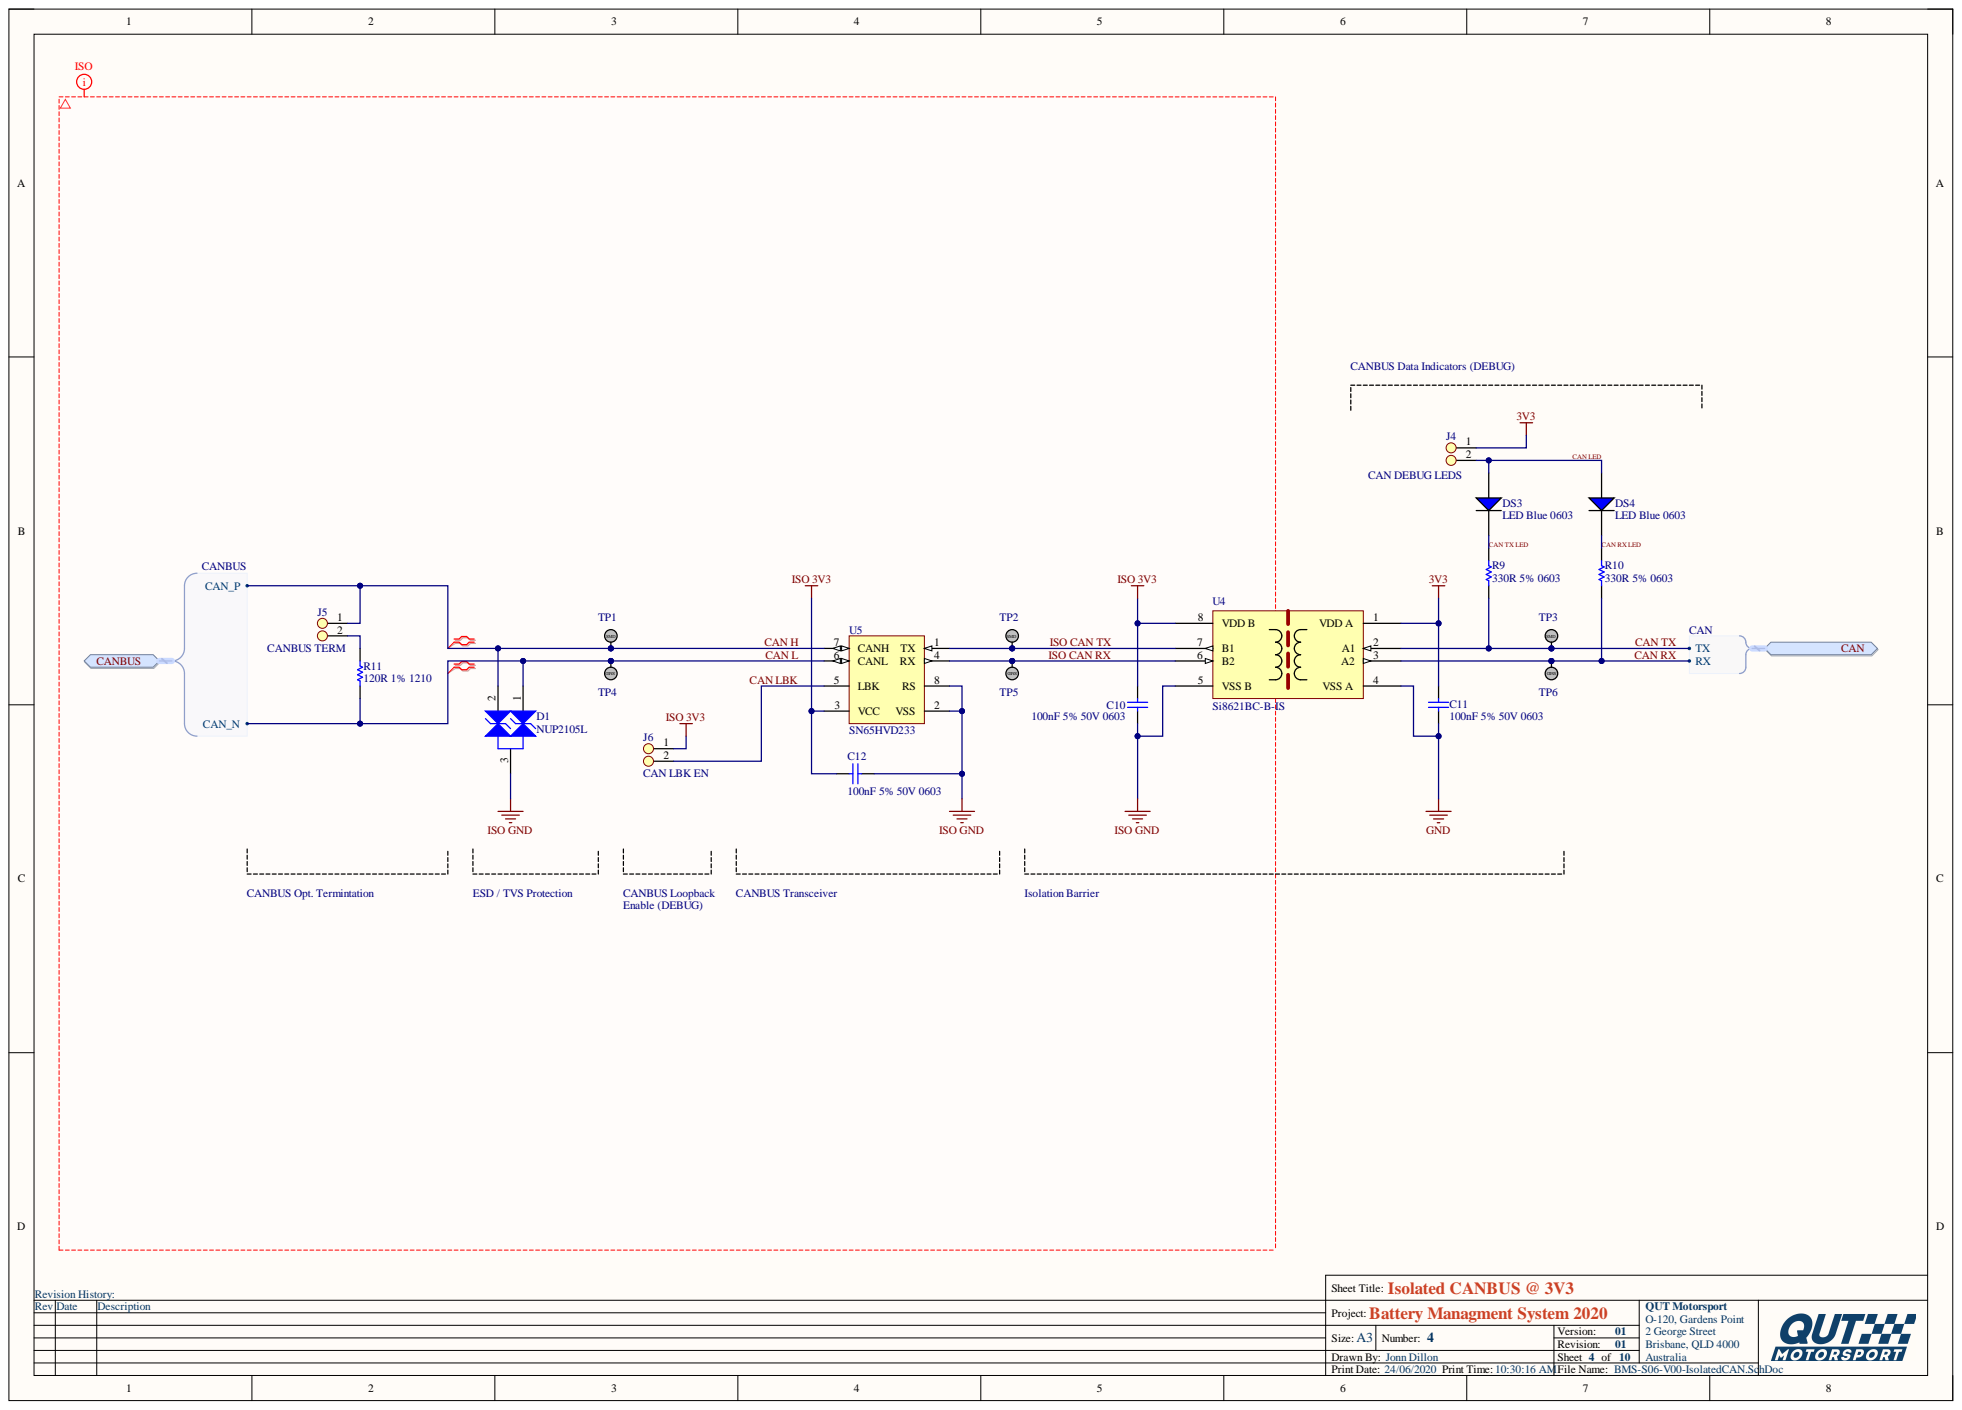
[picture p23: page 4]

C A N L | | 6 | 4 ISO C A N R X | 6

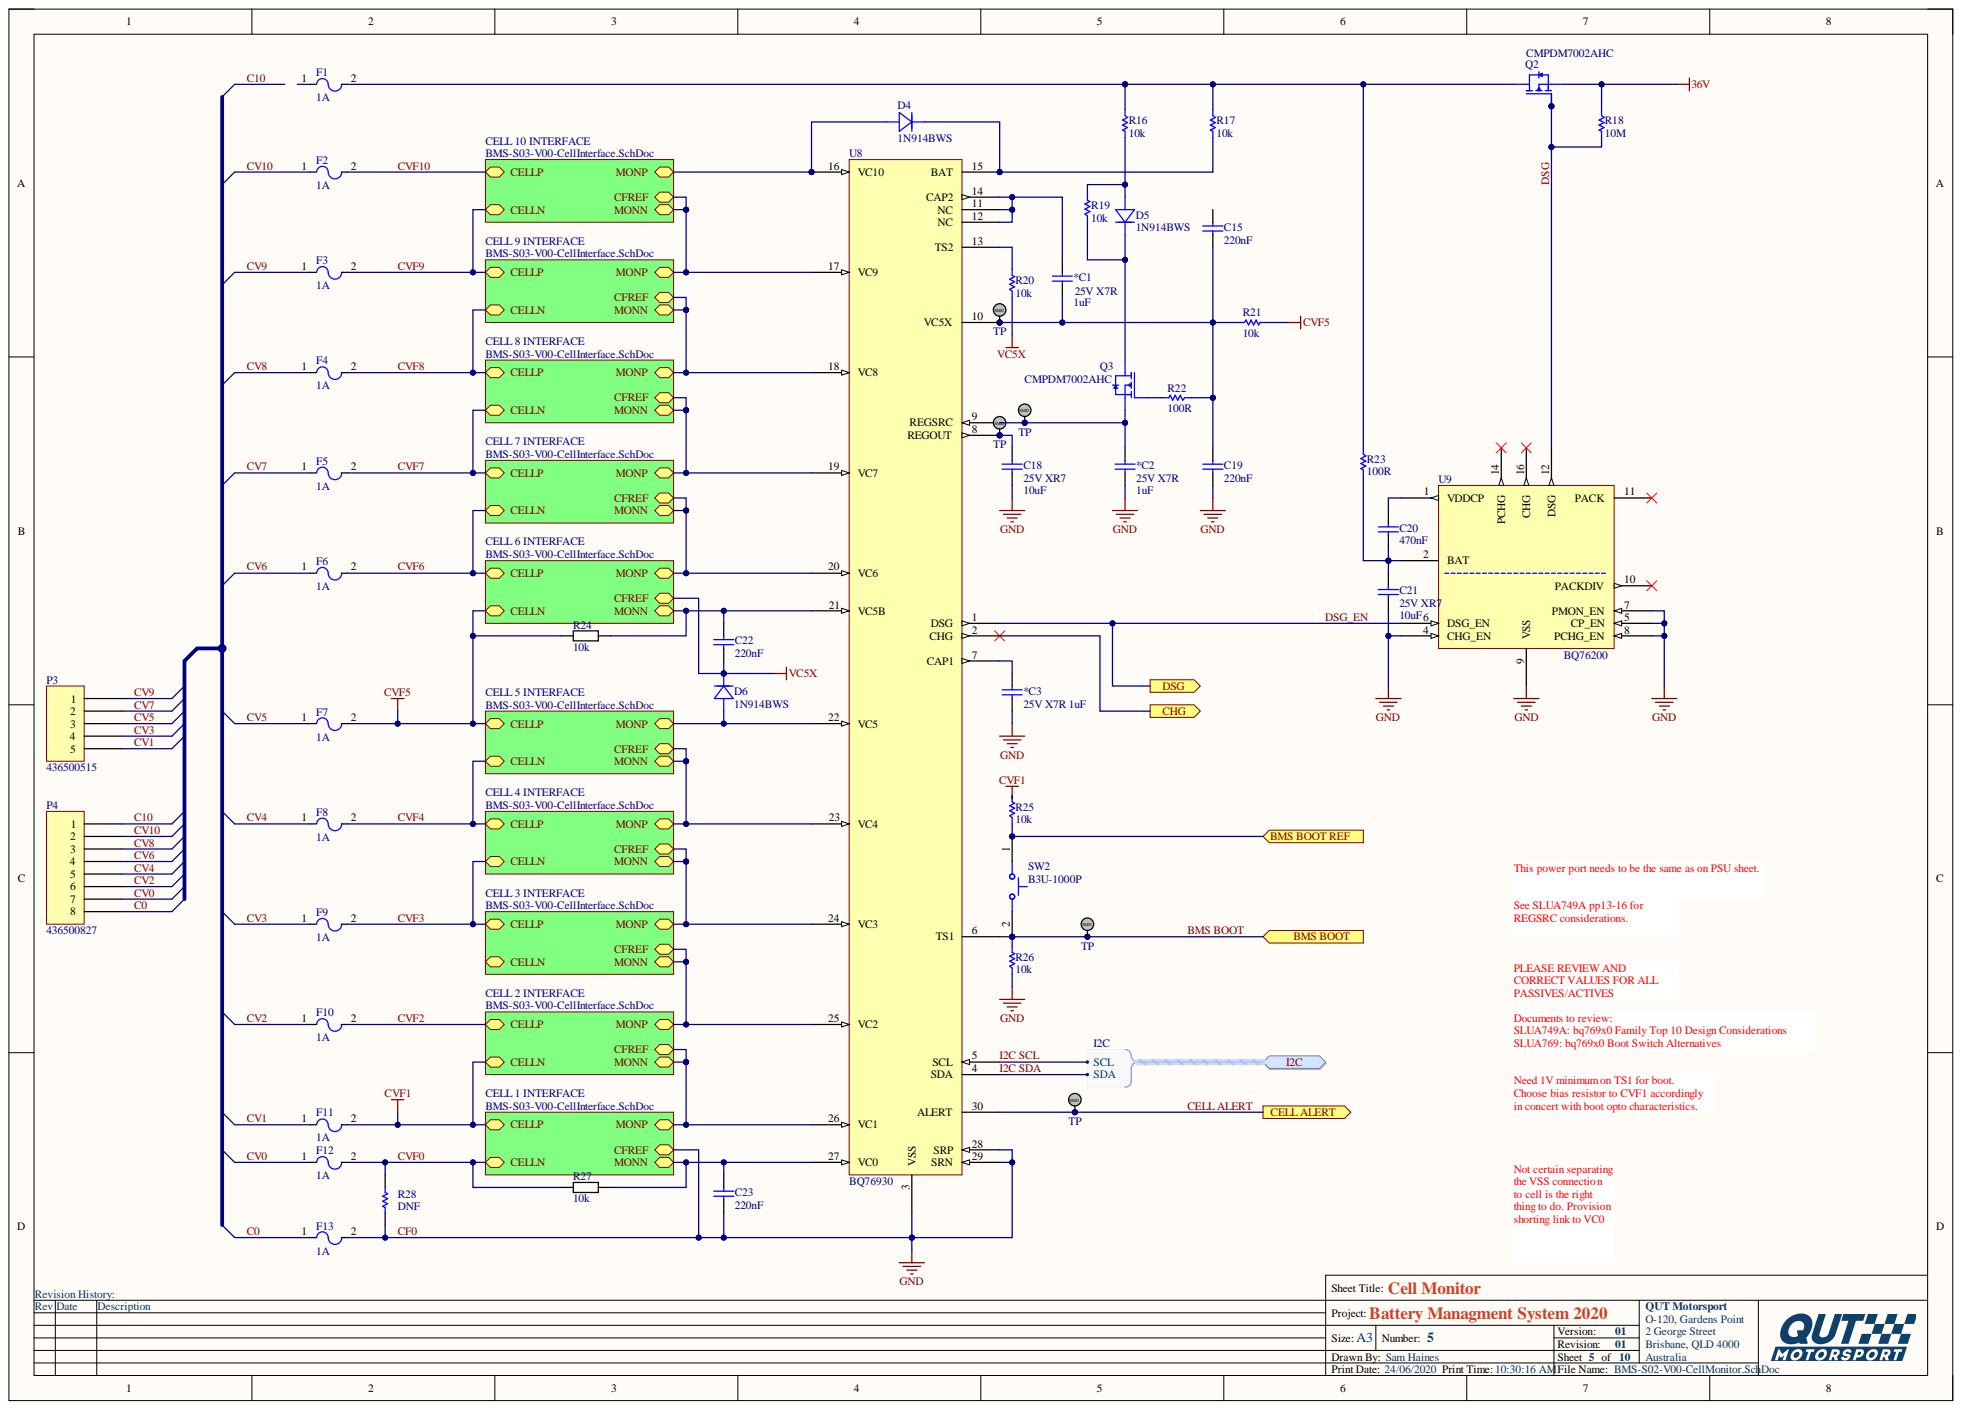
[picture p24: page 5]

he same as on PSU s

tor to C
th boot opto character

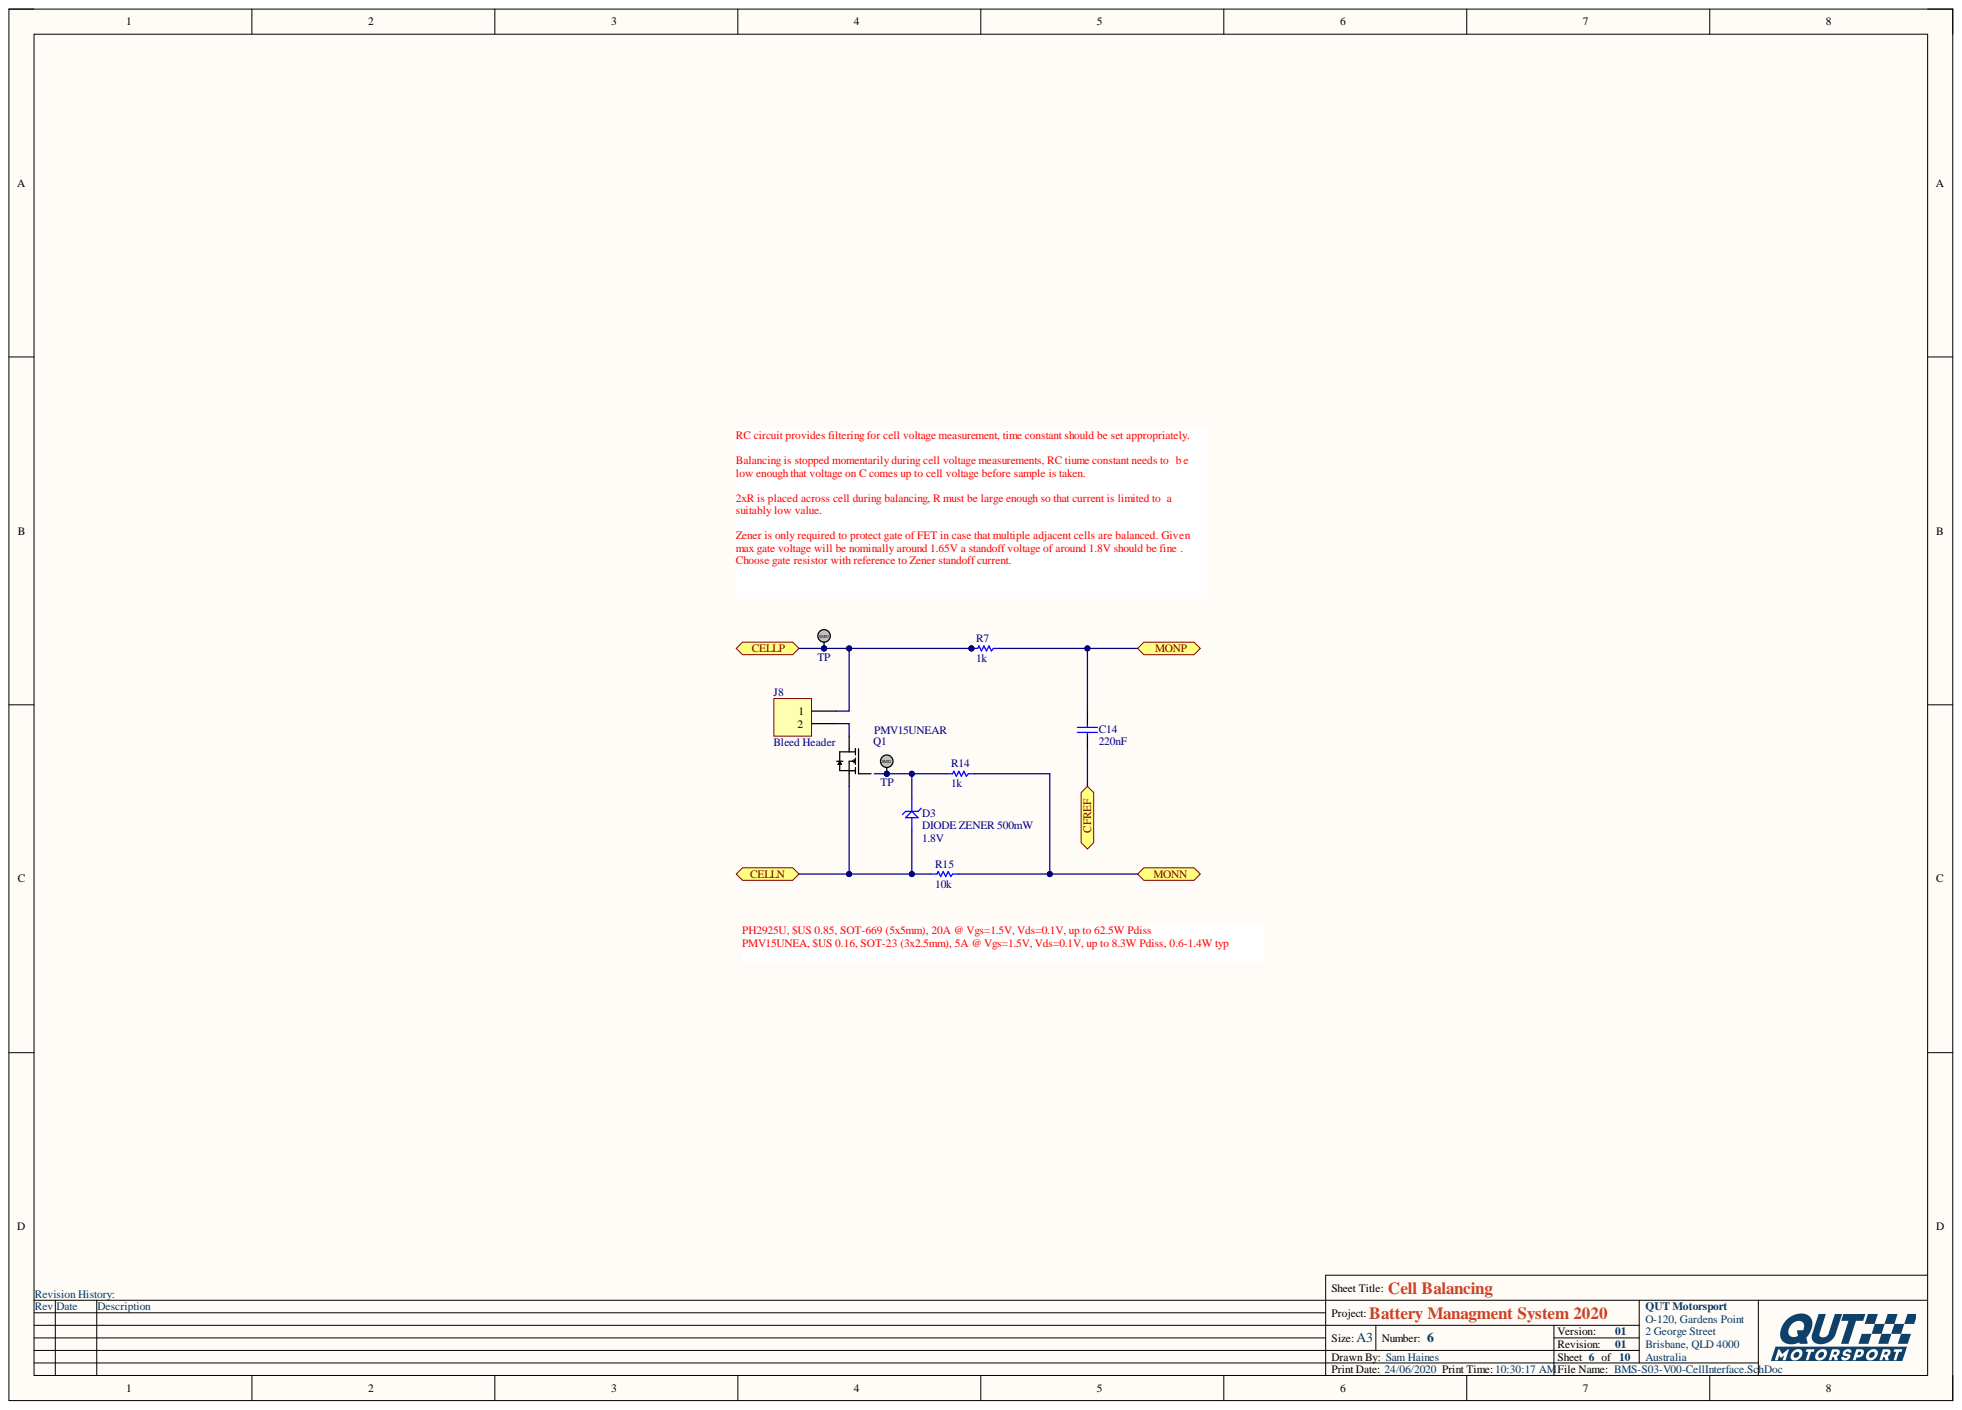
[picture p25: page 6]

RC circuit provides filtering for cell voltage measurement, time constant should be set appropriately.

Balancing is stopped momentarily during cell voltage measurements, RC tiume constant needs to be
low enough that voltage on C comes up to cell voltage before sample is taken.

2xR is placed across cell during balancing, R must be large enough so that current is limited to a
suitably low value.

Zener is only required to protect gate of FET in case that multiple adjacent cells are balanced. Given
max gate voltage will be nominally around 1.65V a standoff voltage of around 1.8V should be fine.
Choose gate resistor with reference to Zener standoff current.

PH2925U, $US 0.85, SOT-669 (5x5mm), 20A @ Vgs=1.5V, Vds=0.1V, up to 62.5W Pdiss
PMV15UNEA, $US 0.16, SOT-23 (3x2.5mm), 5A @ Vgs=1.5V, Vds=0.1V, up to 8.3W Pdiss, 0.6-1.4W typ

Sheet Title: Cell Balancing
Battery Managment System 2020

Drawn By: Sam Haines

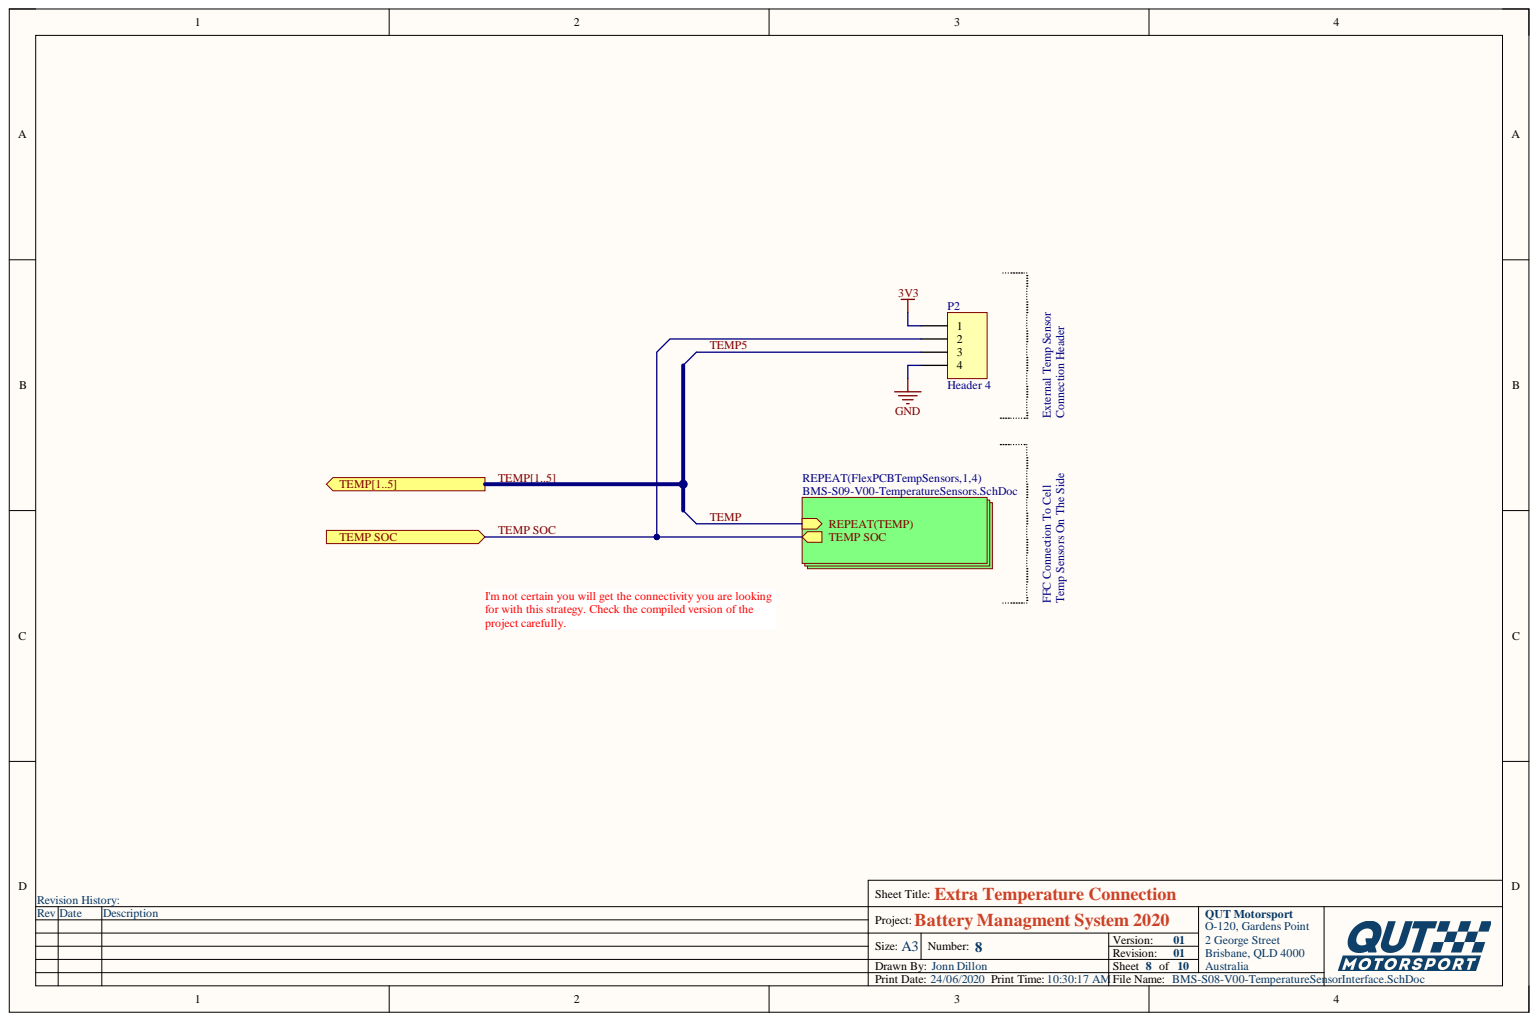
[picture p26: page 7]

External Temp Sensor FFC Connection To Cell

Connection Header Temp Sensors On The Side

I'm not certain you will get the connectivity you are looking
for with this strategy. Check the compiled version of the
project carefully.

Sheet Title: Extra Temperature Connection Rev
Revision History:

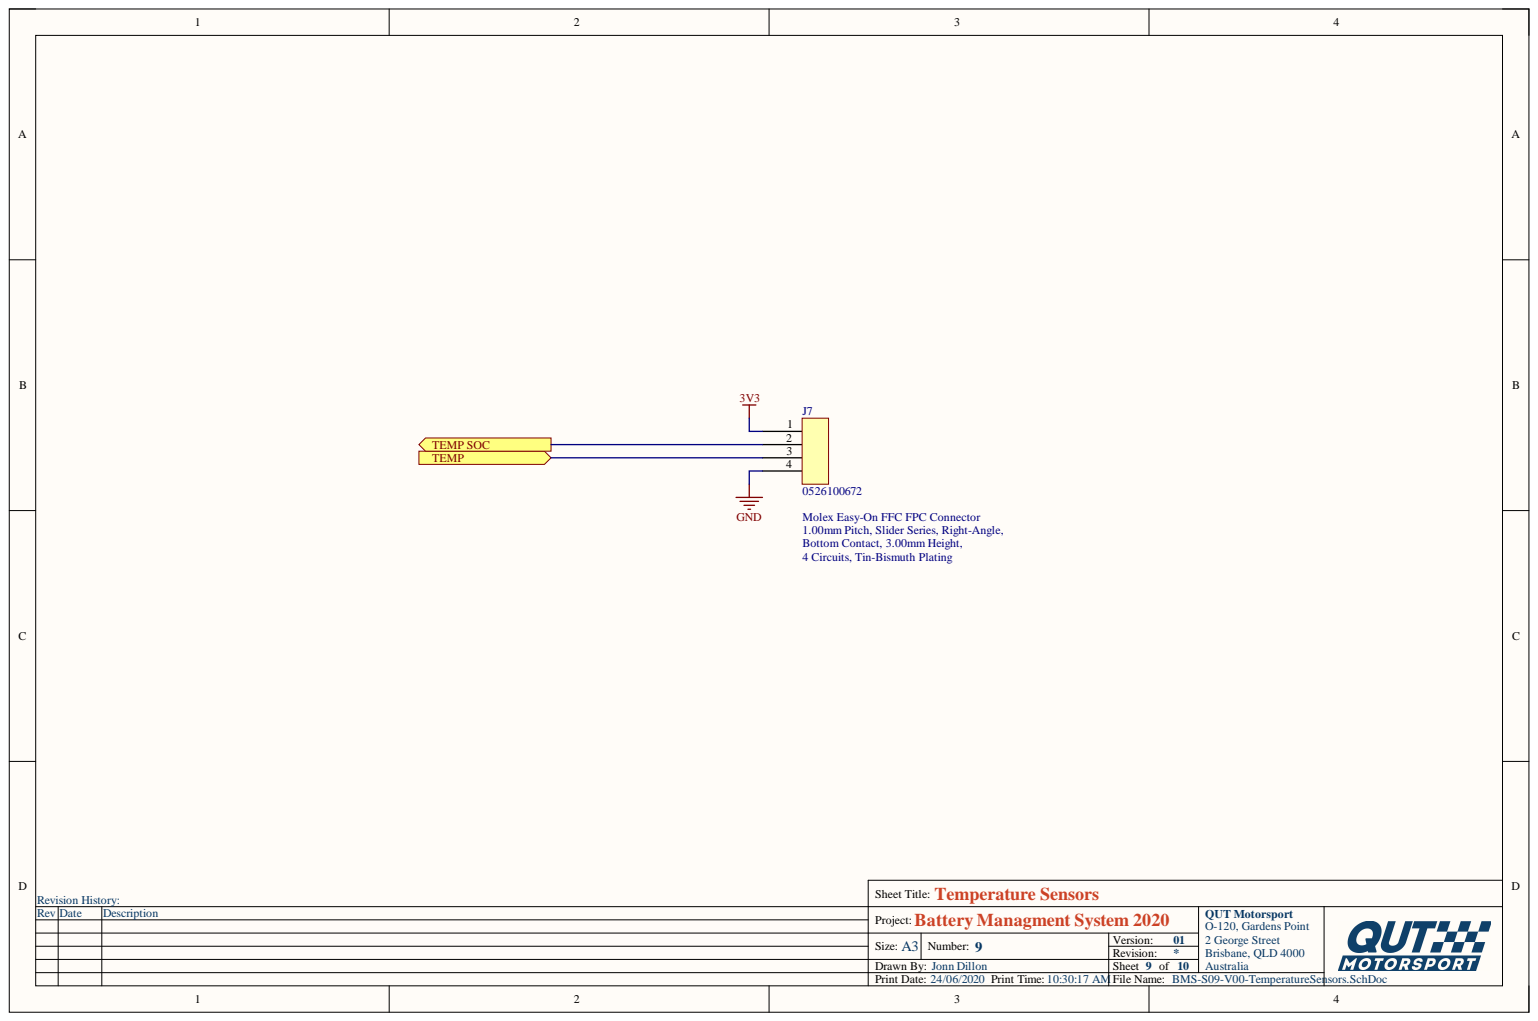
[picture p27: page 8]

Molex Easy-On FFC FPC Connector
1.00mm Pitch, Slider Series, Right-Angle,
Bottom Contact, 3.00mm Height,
4 Circuits, Tin-Bismuth Plating

Sheet Title: Temperature Sensors Rev
Revision History:

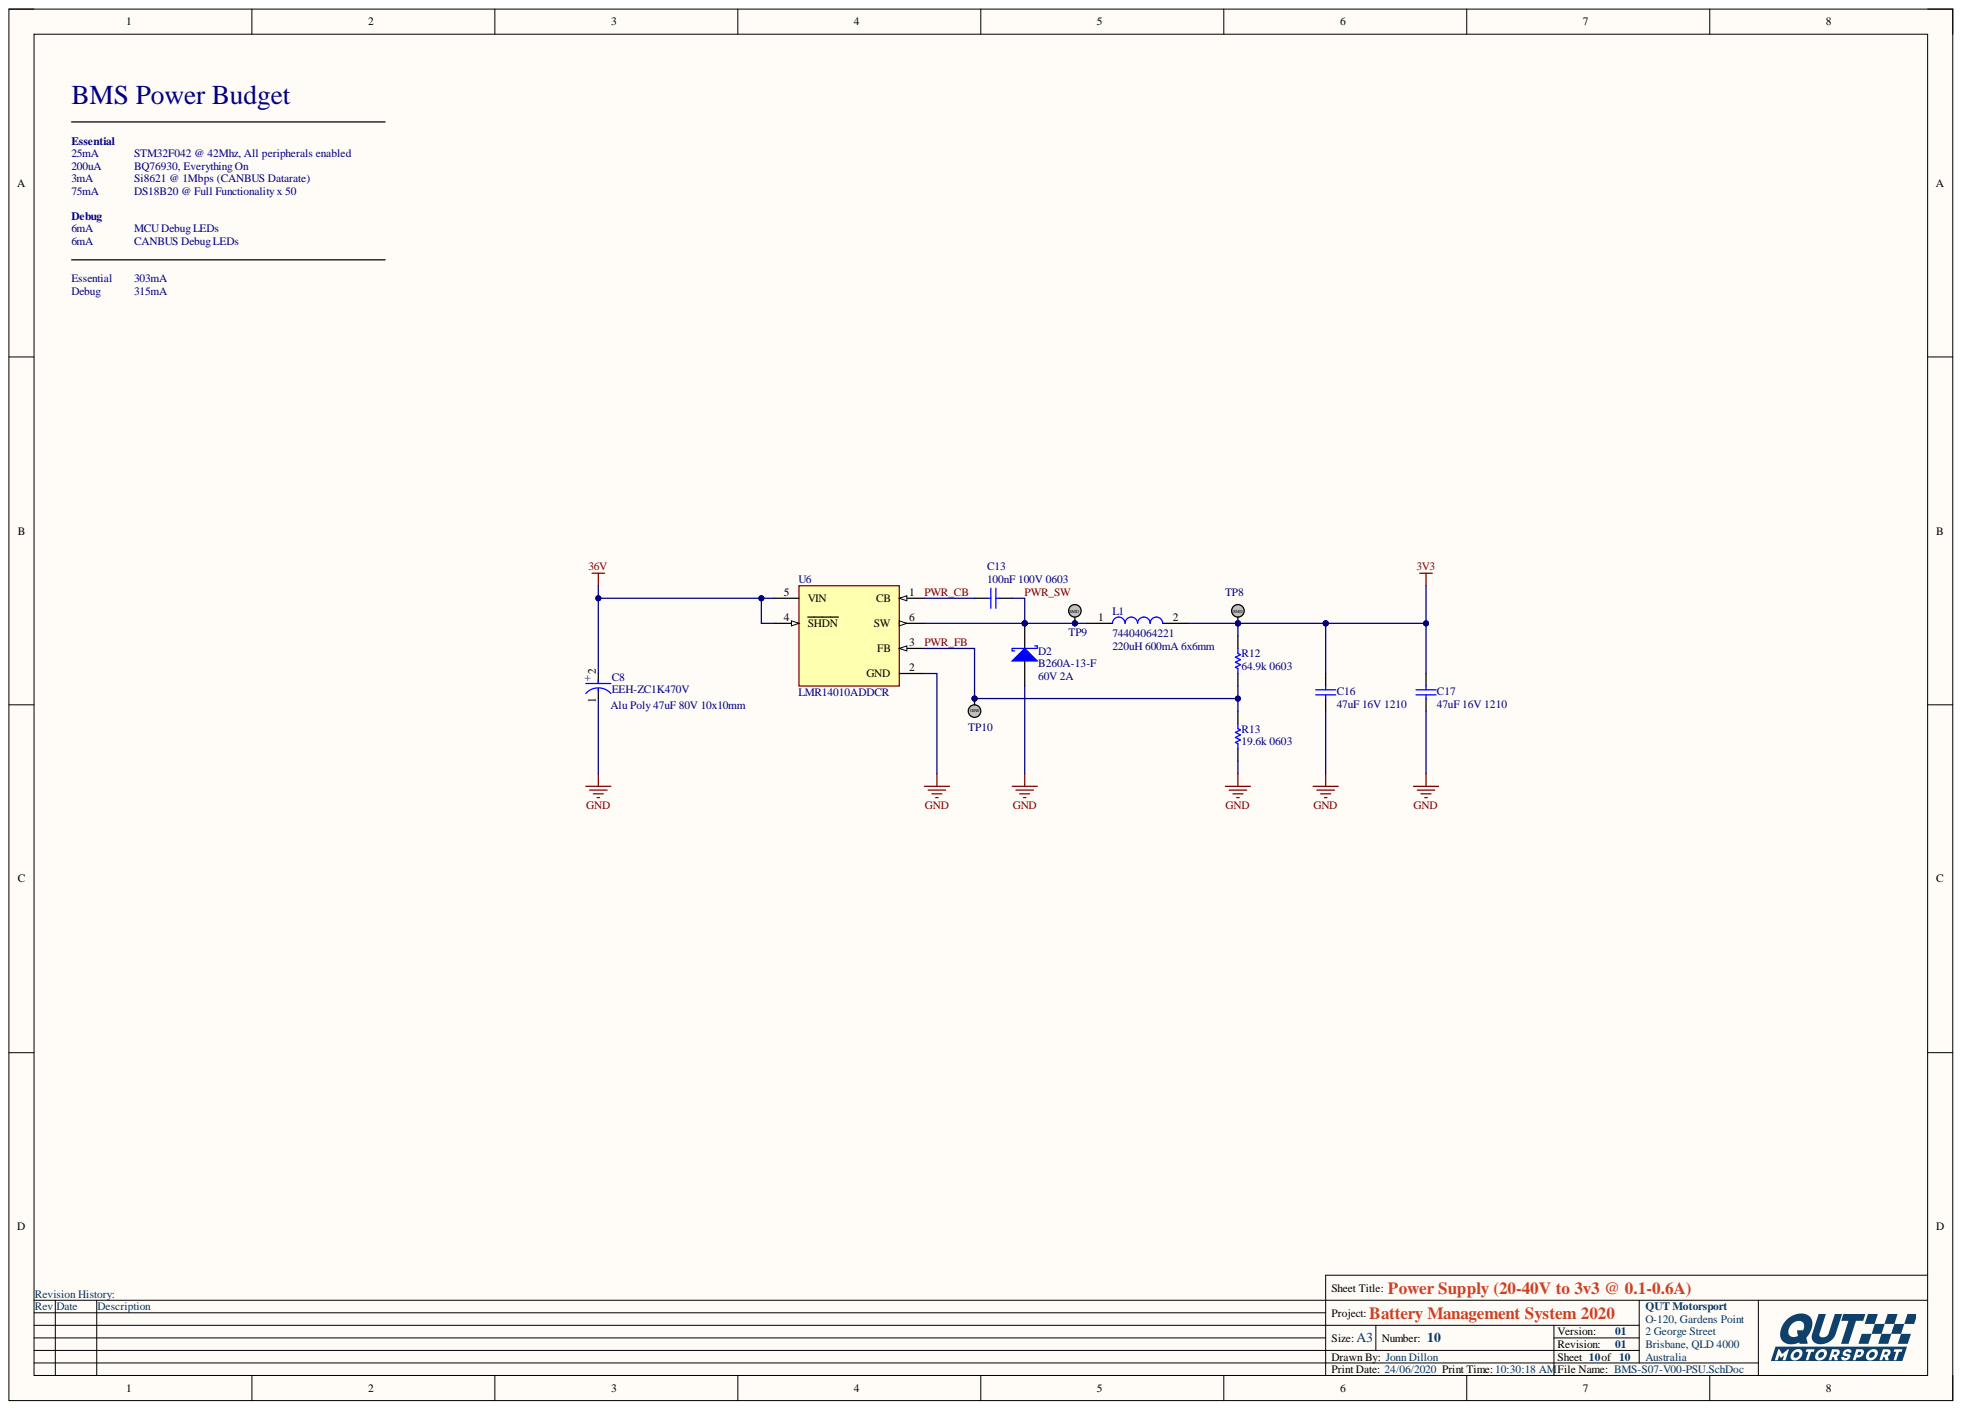
[picture p28: page 9]
