Salmon-Built-Designs/QUTMS_BMS/hardware/BMS_2020/BMS_2020_05-05-2020.pdf

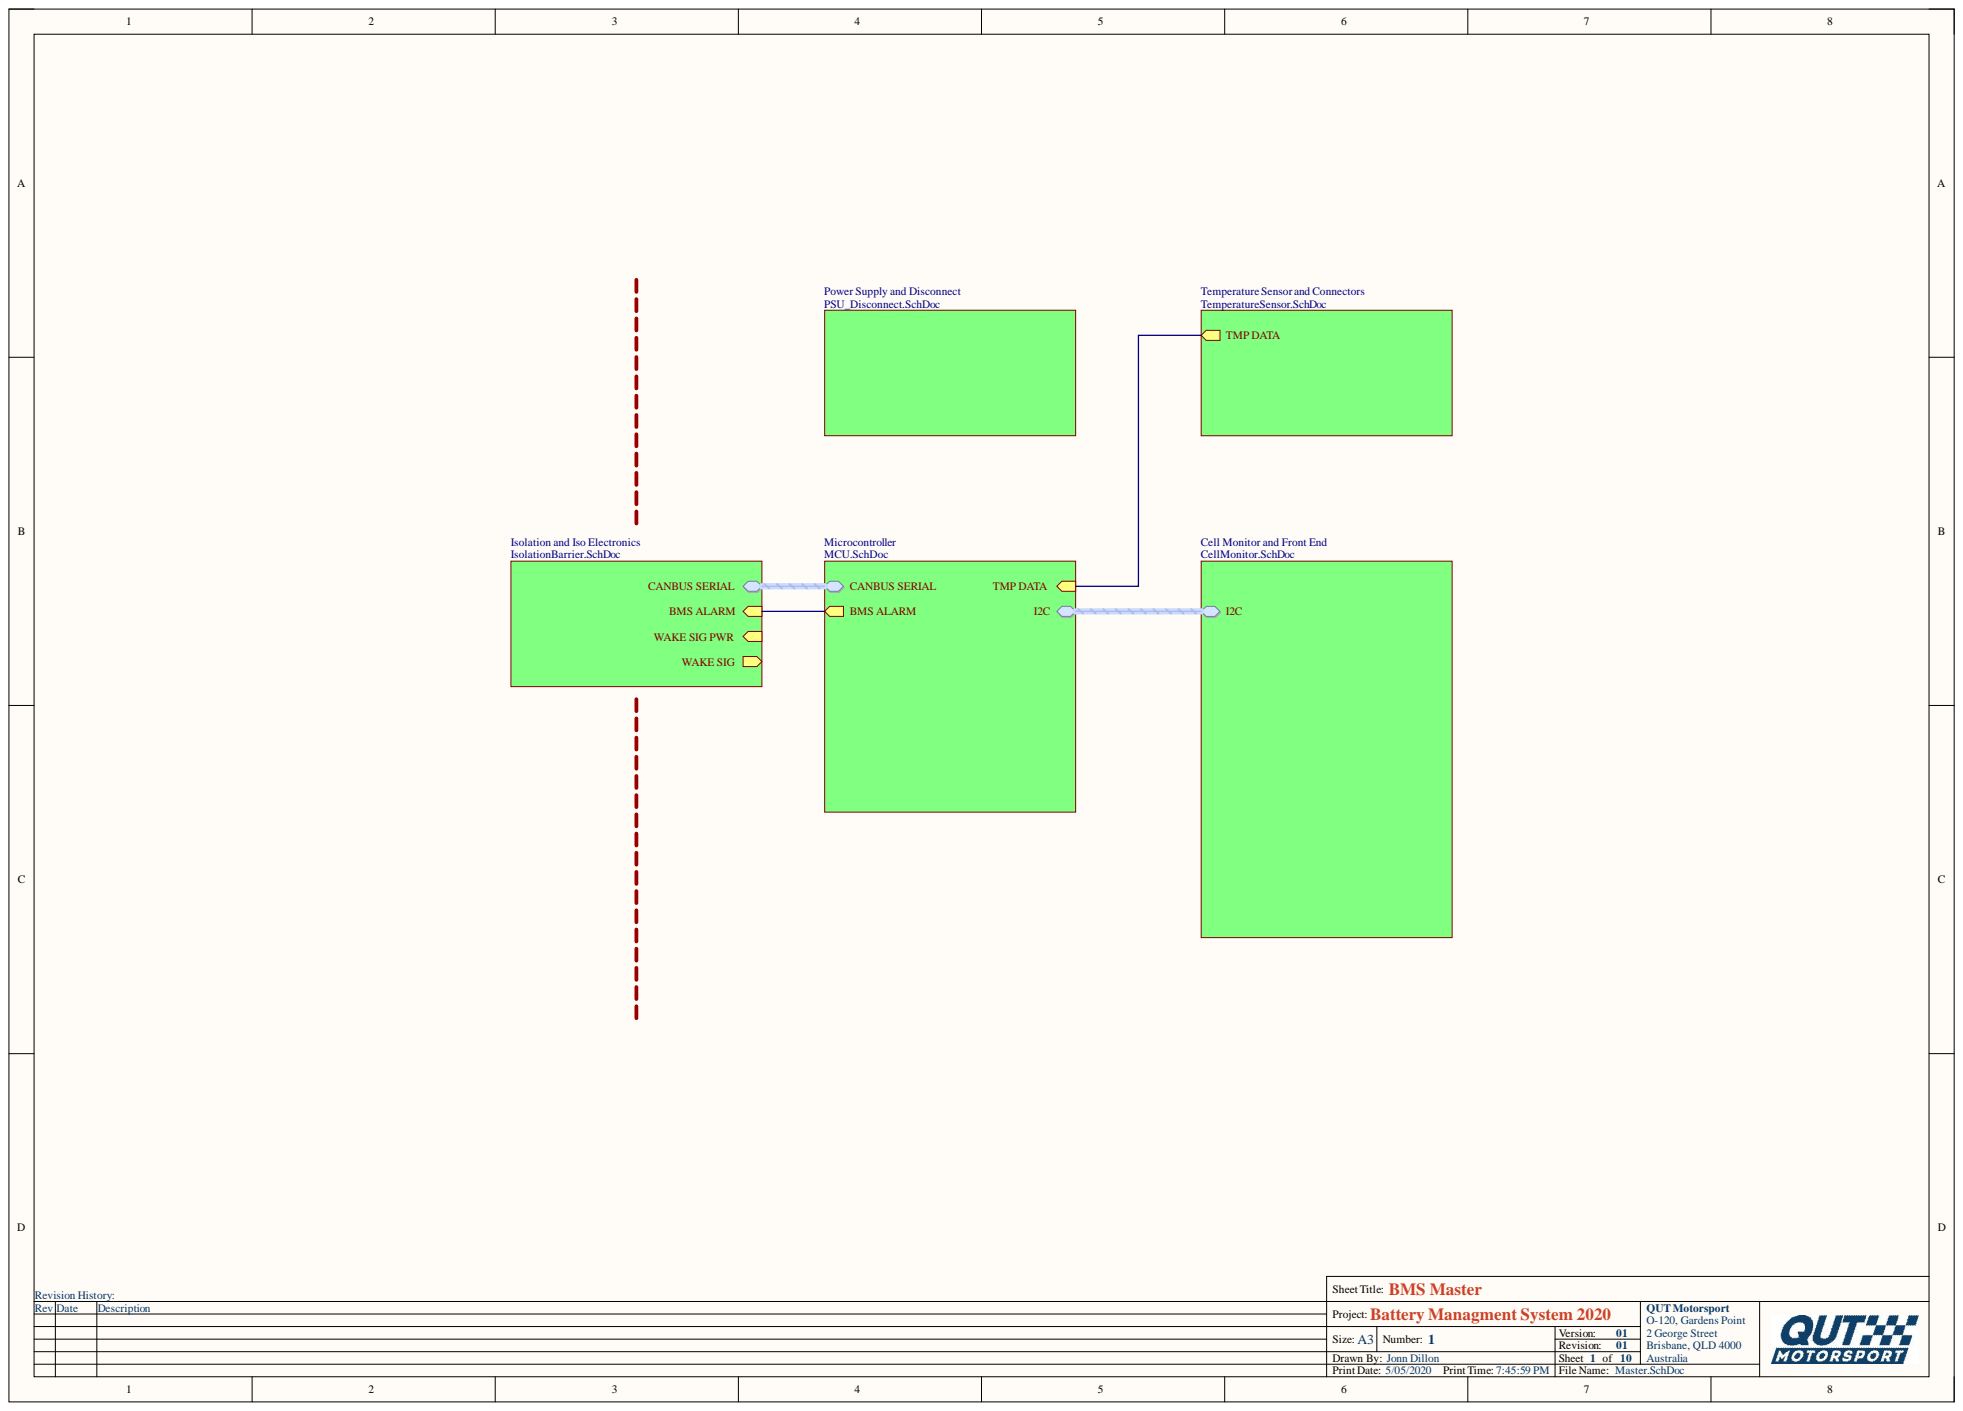
[picture p29: page 1]

Power Supply and Disconnect
PSU_Disconnect.SchDoc

Temperature Sensor and Connectors
TemperatureSensor.SchDoc

Isolation and Iso Electronics
IsolationBarrier.SchDoc

Cell Monitor and Front End
CellMonitor.SchDoc

Sheet Title: BMS Master
Battery Managment System 2020

Drawn By: Jonn Dillon

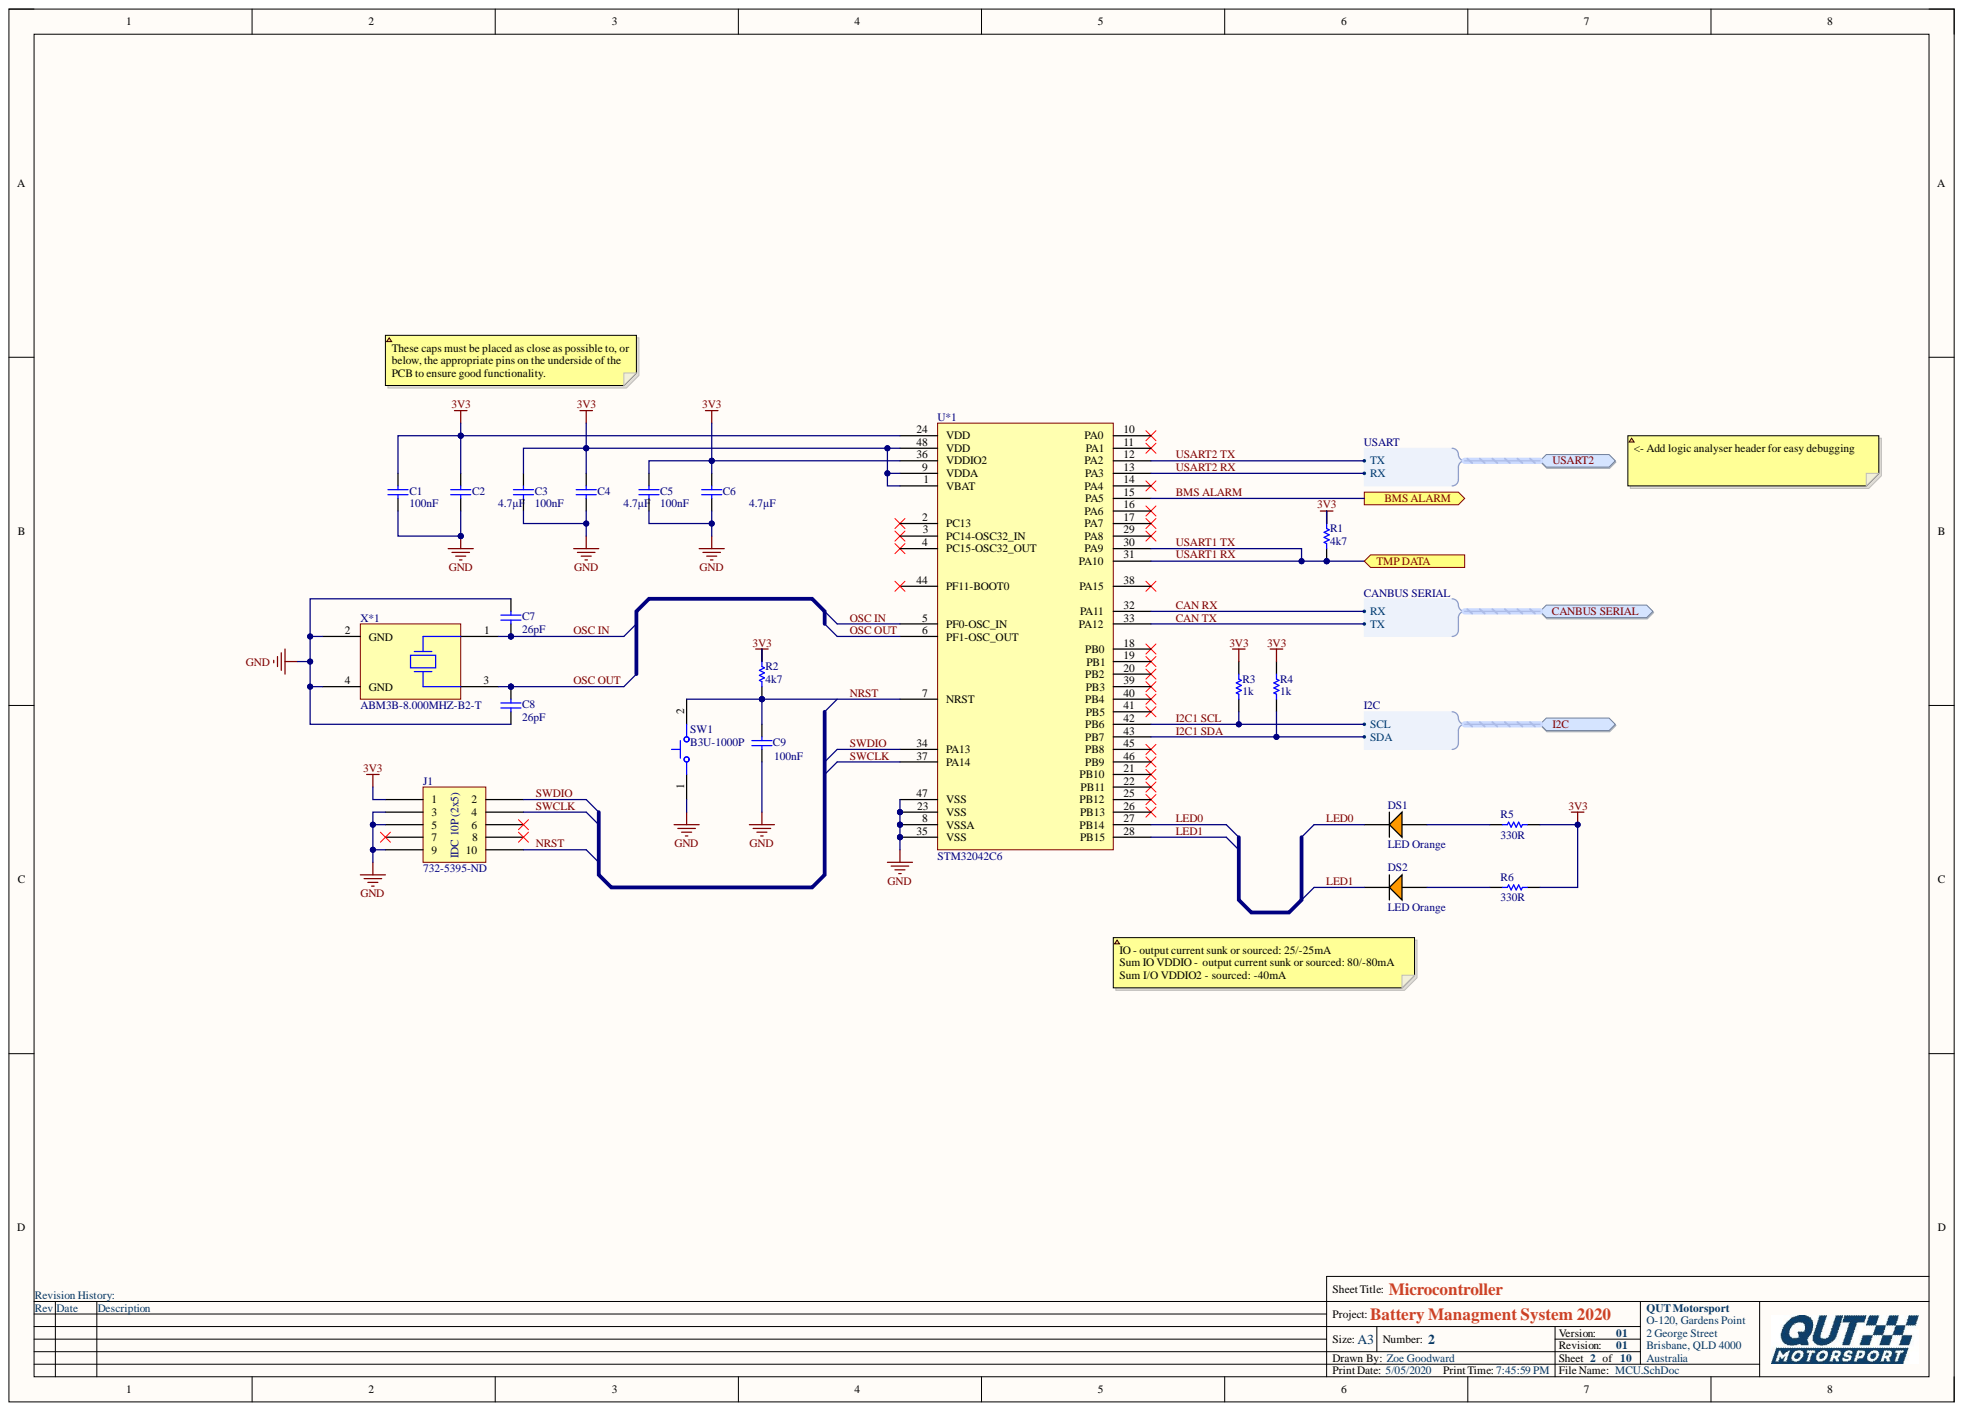
[picture p30: page 2]

t be placed as close as pos
iate pins on
funct

9 | USA RT2 R X

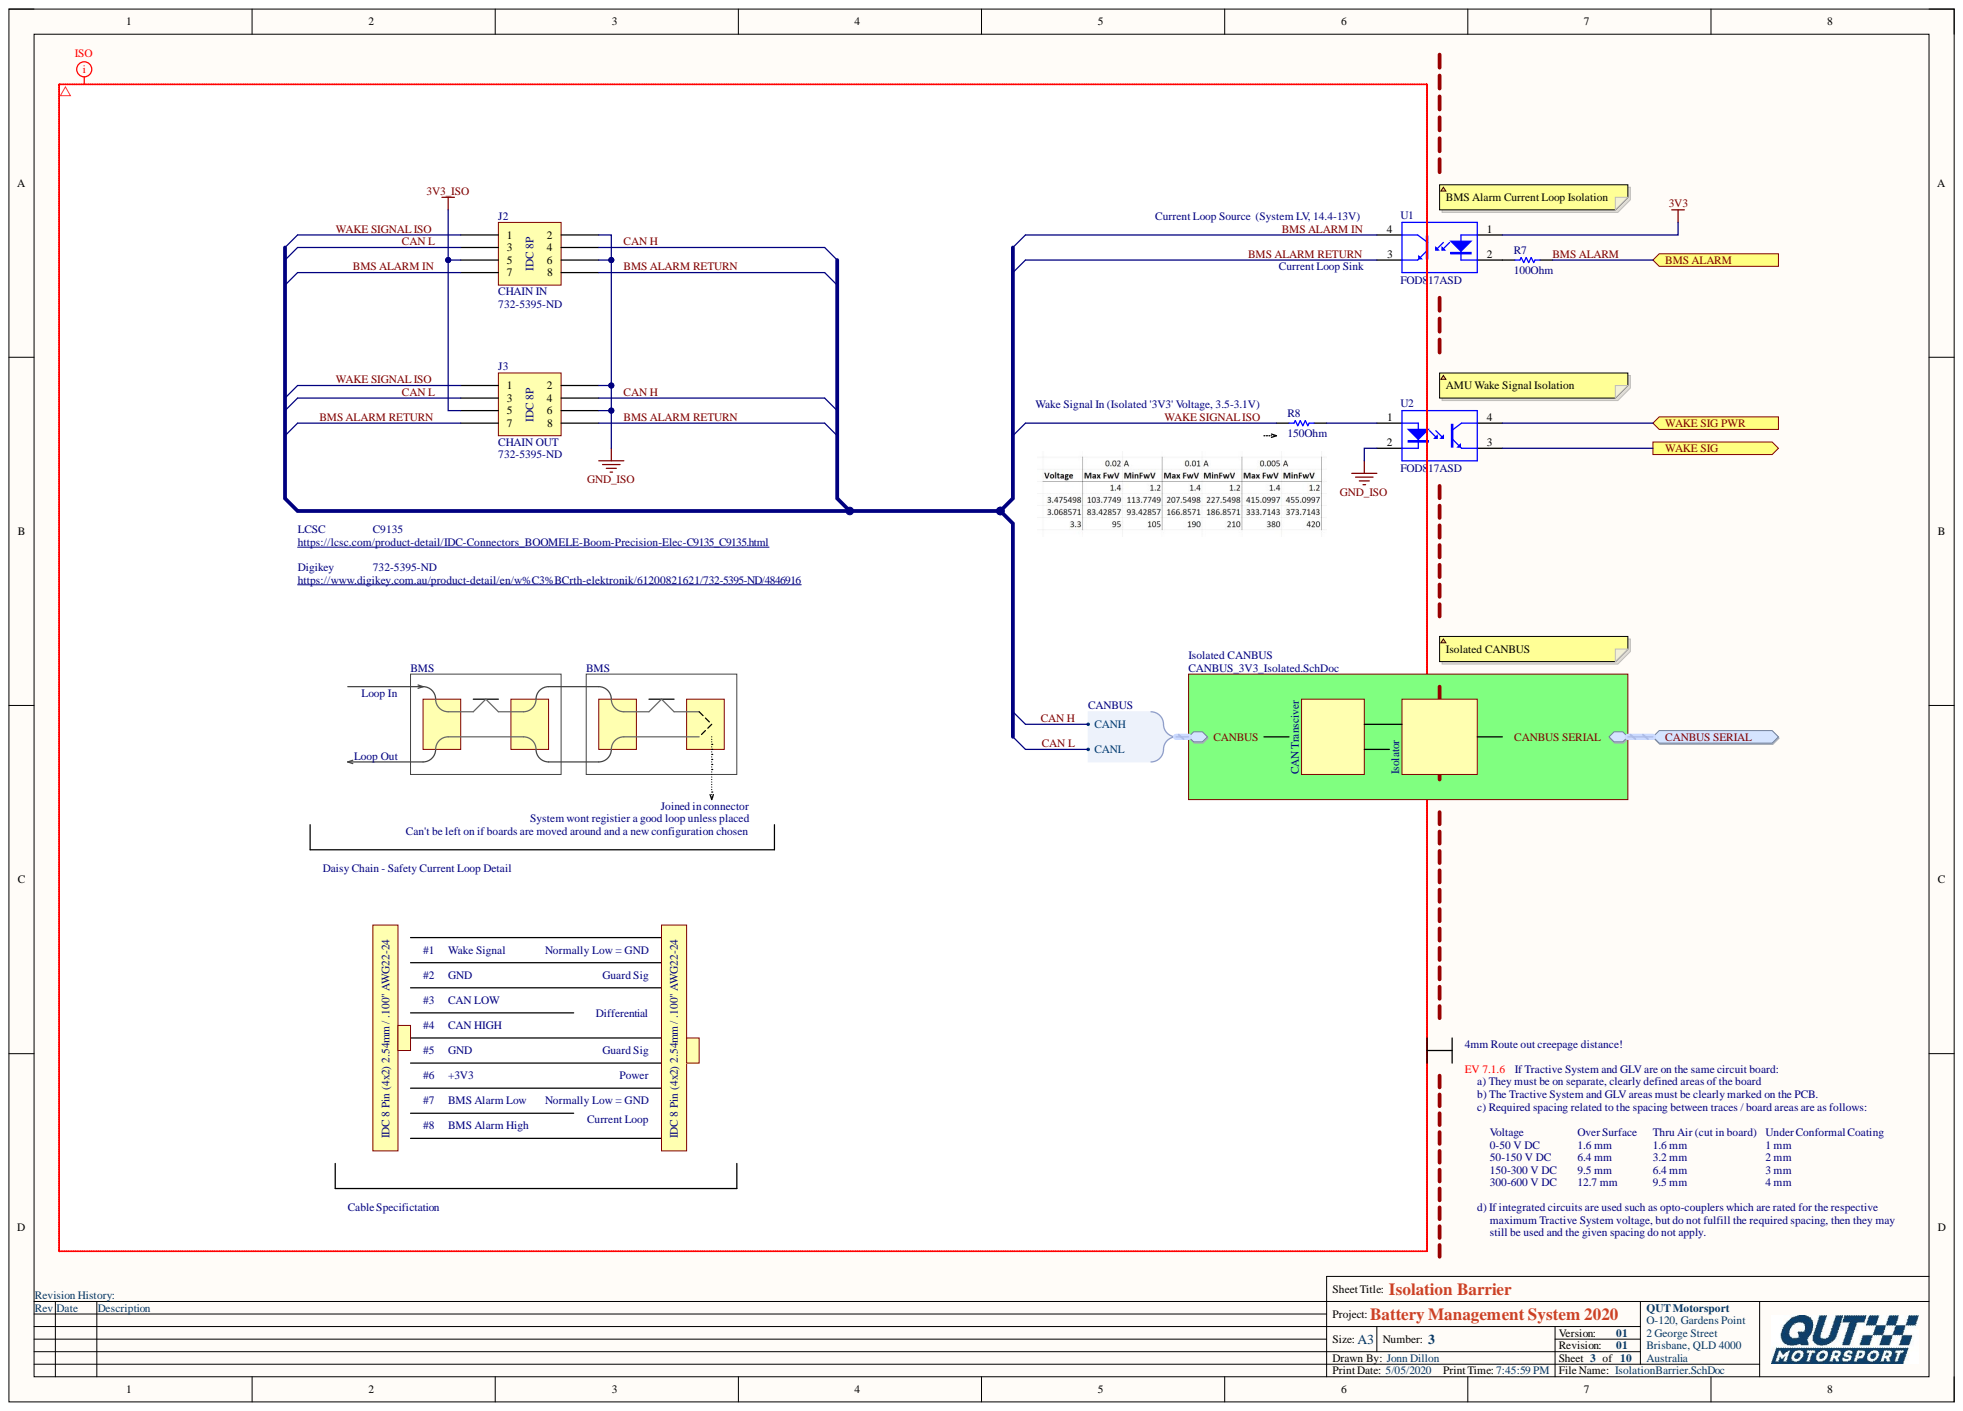
[picture p31: page 3]

BMS Alarm Current Loop Isolation

Current Loop Source (System LV, 14.4-13V)

AMU Wake Signal Isolation

Wake Signal In (Isolated '3V3' Voltage, 3.5-3.1V)

LCSC
https://lcsc.com/product-detail/IDC-Connectors_BOOMELE-Boom-Precision-Elec-C9135_C9135.html

Digikey
https://www.digikey.com.au/product-detail/en/w%C3%BCrth-elektronik/61200821621/732-5395-ND/4846916

System wont registier a good loop unless placed

Can't be left on if boards are moved around and a new configuration chosen

Daisy Chain - Safety Current Loop Detail

4mm Route out creepage distance!

EV 7.1.6 If Tractive System and GLV are on the same circuit board:
a) They must be on separate, clearly defined areas of the board
b) The Tractive System and GLV areas must be clearly marked on the PCB.
c) Required spacing related to the spacing between traces / board areas are as follows:

d) If integrated circuits are used such as opto-couplers which are rated for the respective
maximum Tractive System voltage, but do not fulfill the required spacing, then they may
still be used and the given spacing do not apply.

Sheet Title: Isolation Barrier
Battery Management System 2020

Drawn By: Jonn Dillon

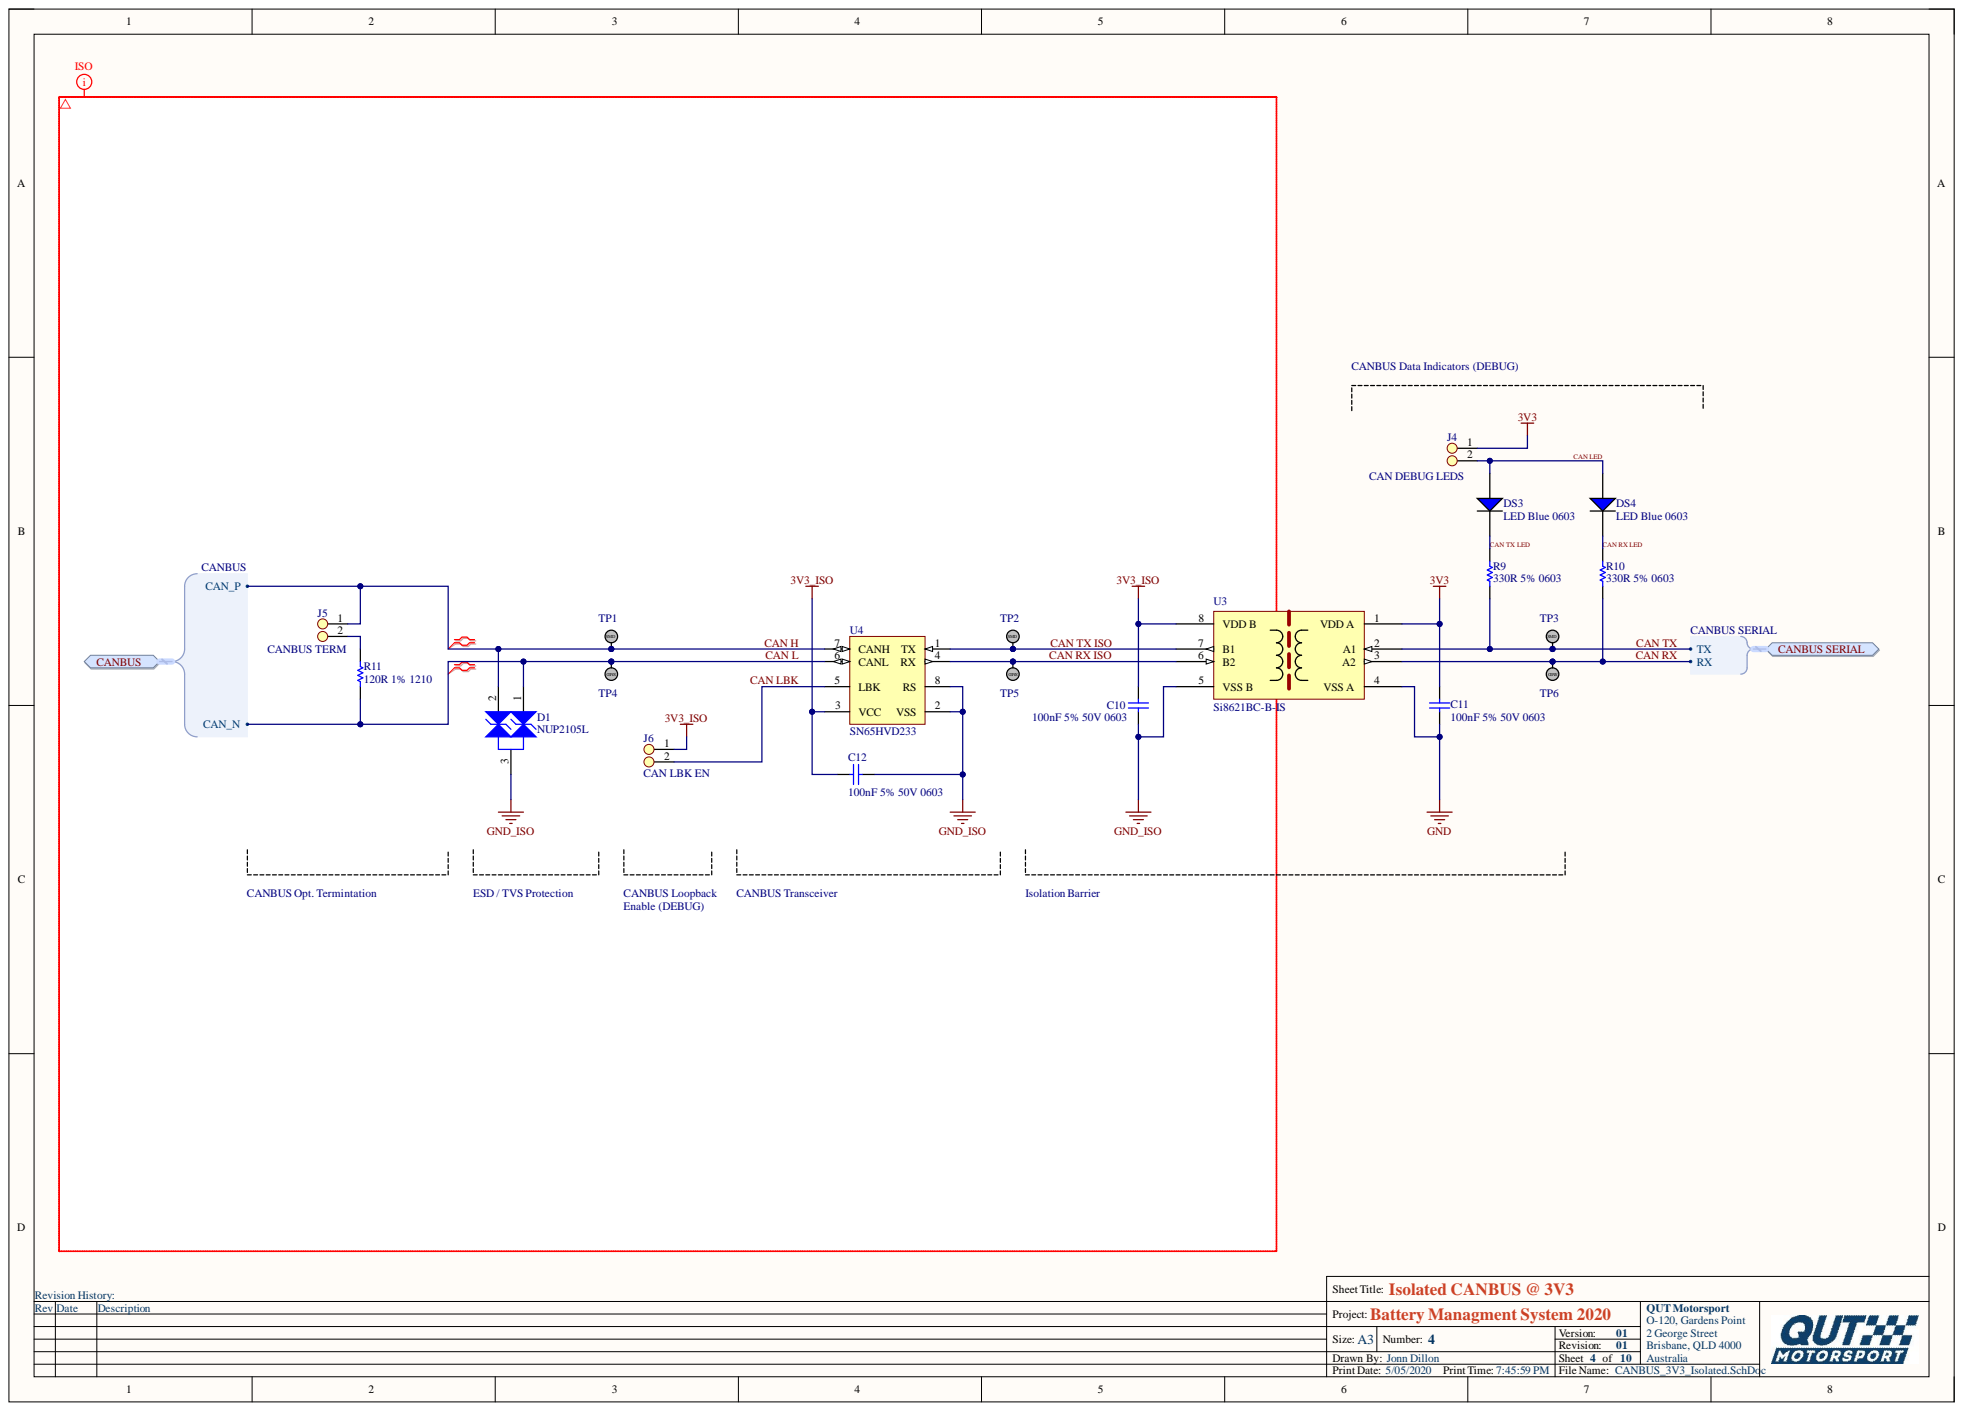
[picture p32: page 4]

C A N L | | | 6 | 4 C A N R X ISO | 6

3V3_ISO | | | 3 | 2

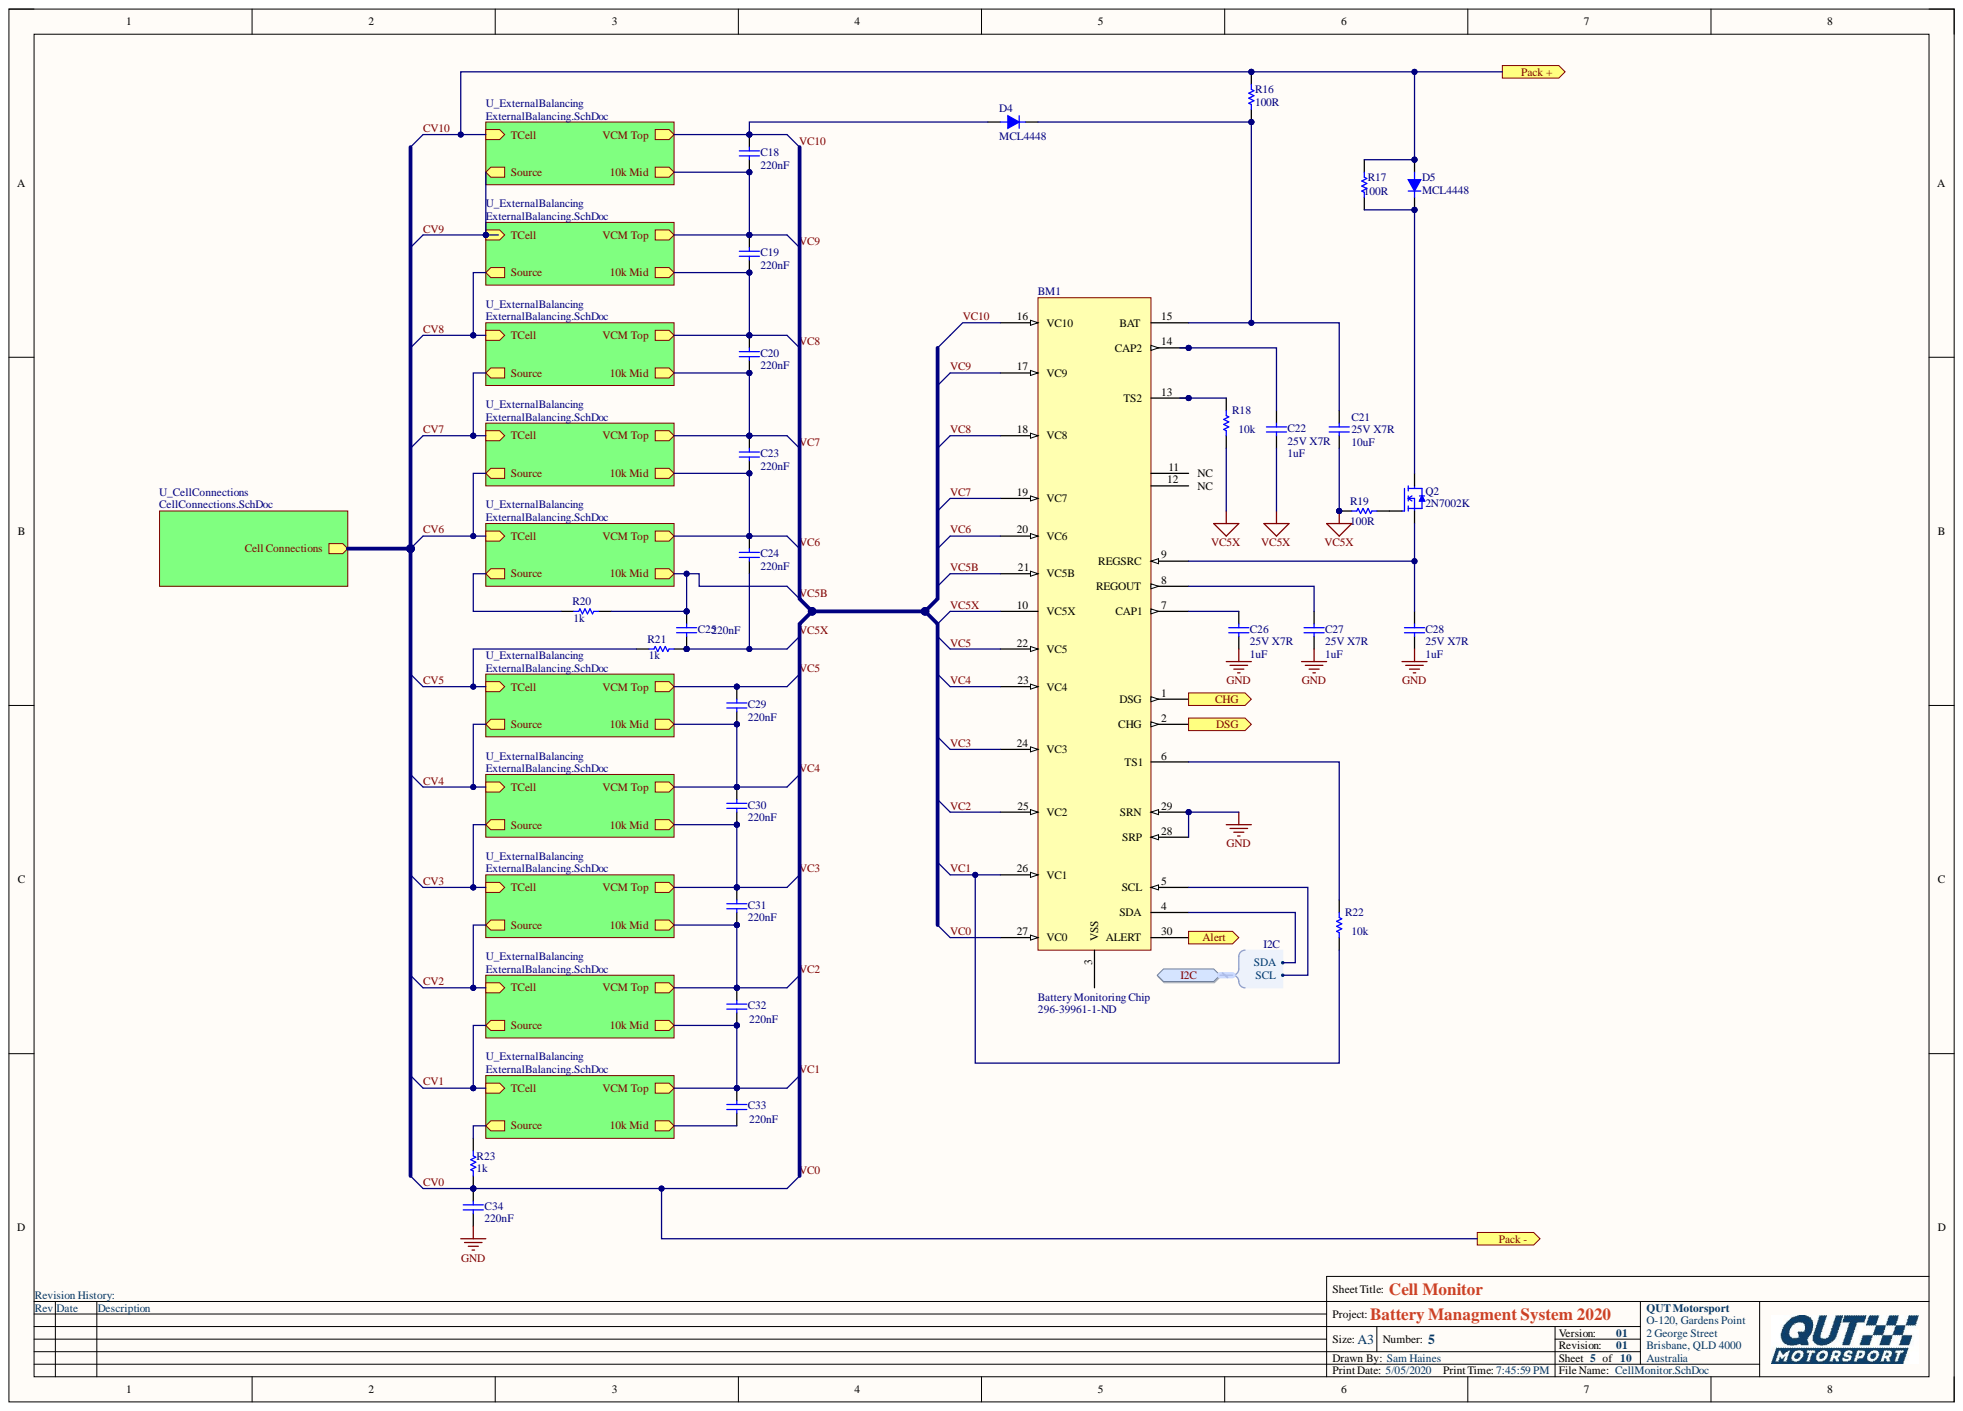
[picture p33: page 5]

Sheet Title: Cell Monitor
Battery Managment System 2020

Drawn By: Sam Haines

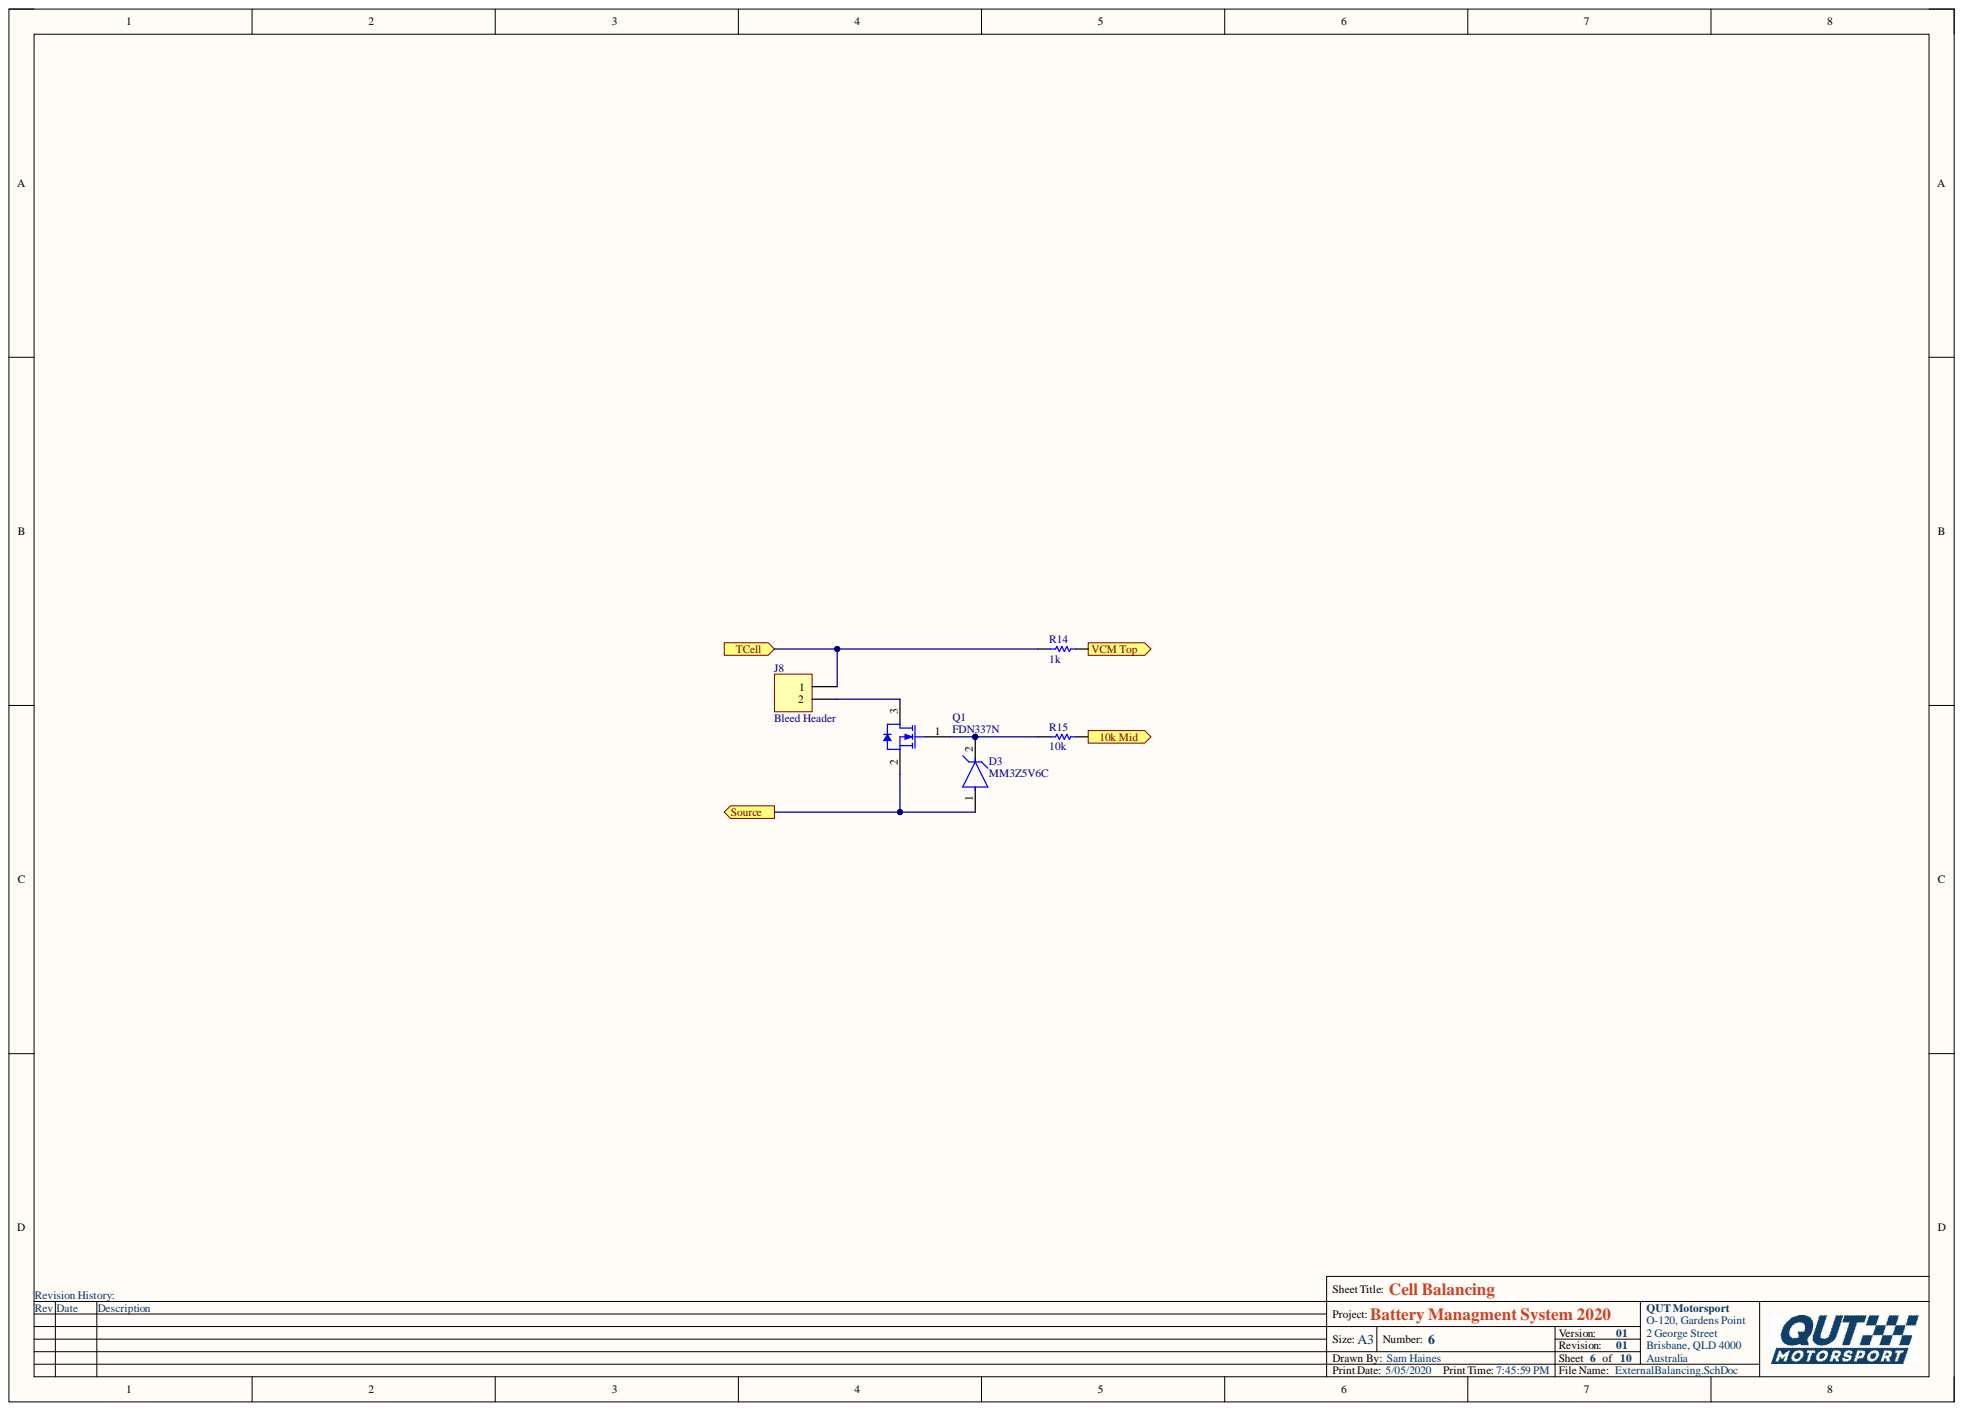
[picture p34: page 6]

Sheet Title: Cell Balancing
Battery Managment System 2020

Drawn By: Sam Haines

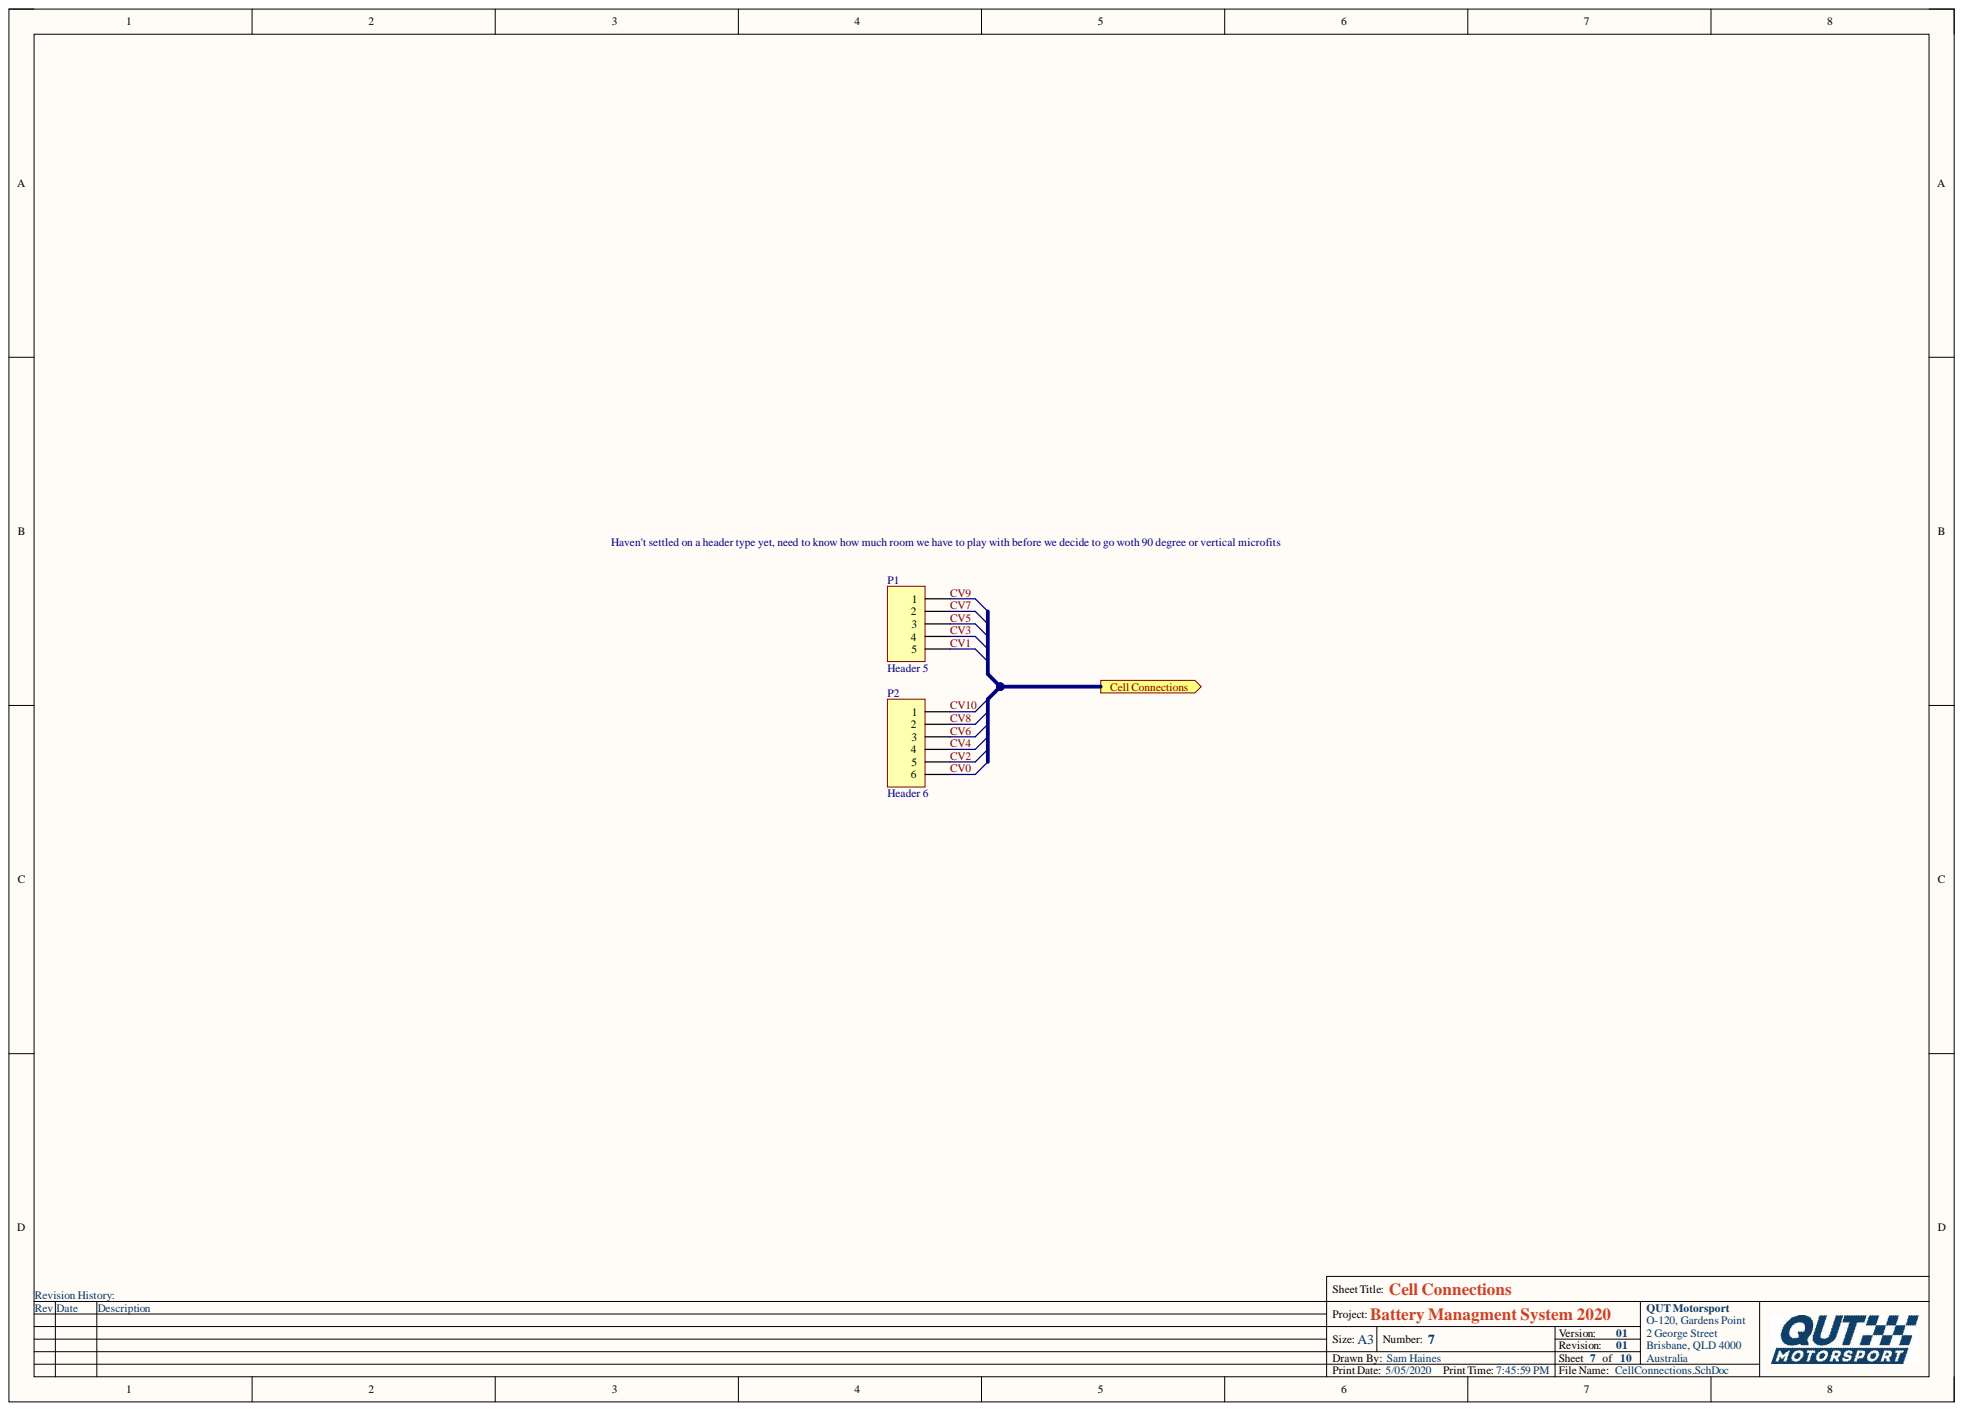
[picture p35: page 7]

woth 90 degree or ver

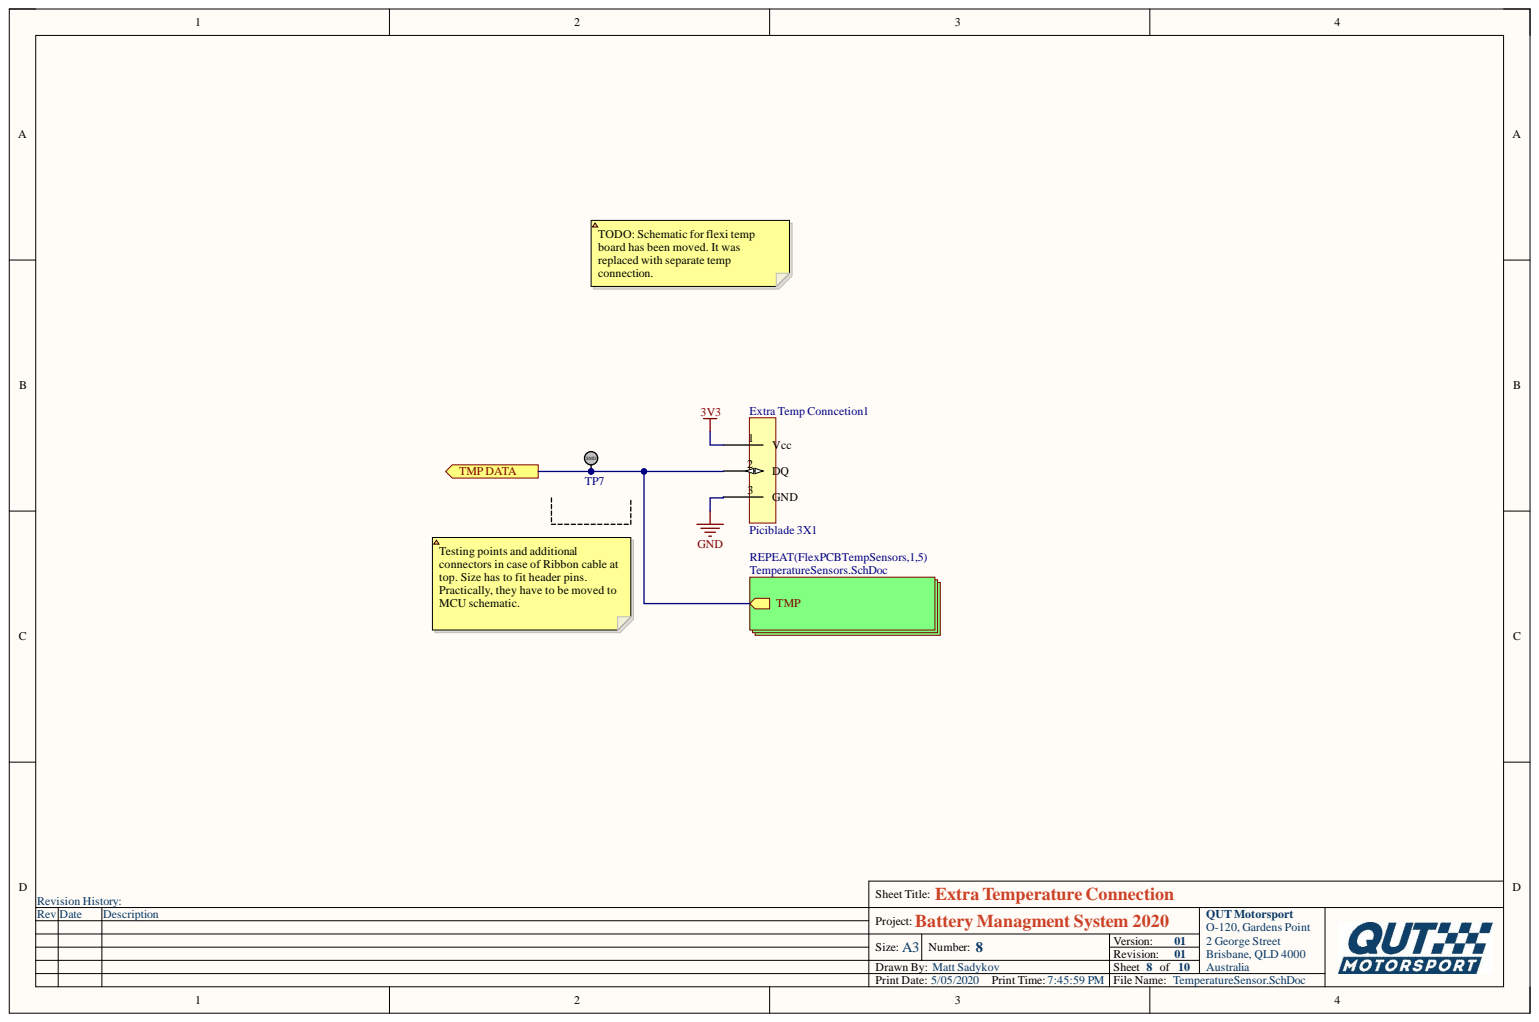
[picture p36: page 8]

TODO: Schematic for flexi temp
board has been moved. It was
replaced with separate temp
connection.

Testing points and additional
connectors in case of Ribbon cable at
top. Size has to fit header pins.
Practically, they have to be moved to
MCU schematic.

Sheet Title: Extra Temperature Connection
Battery Managment System 2020

Drawn By: Matt Sadykov

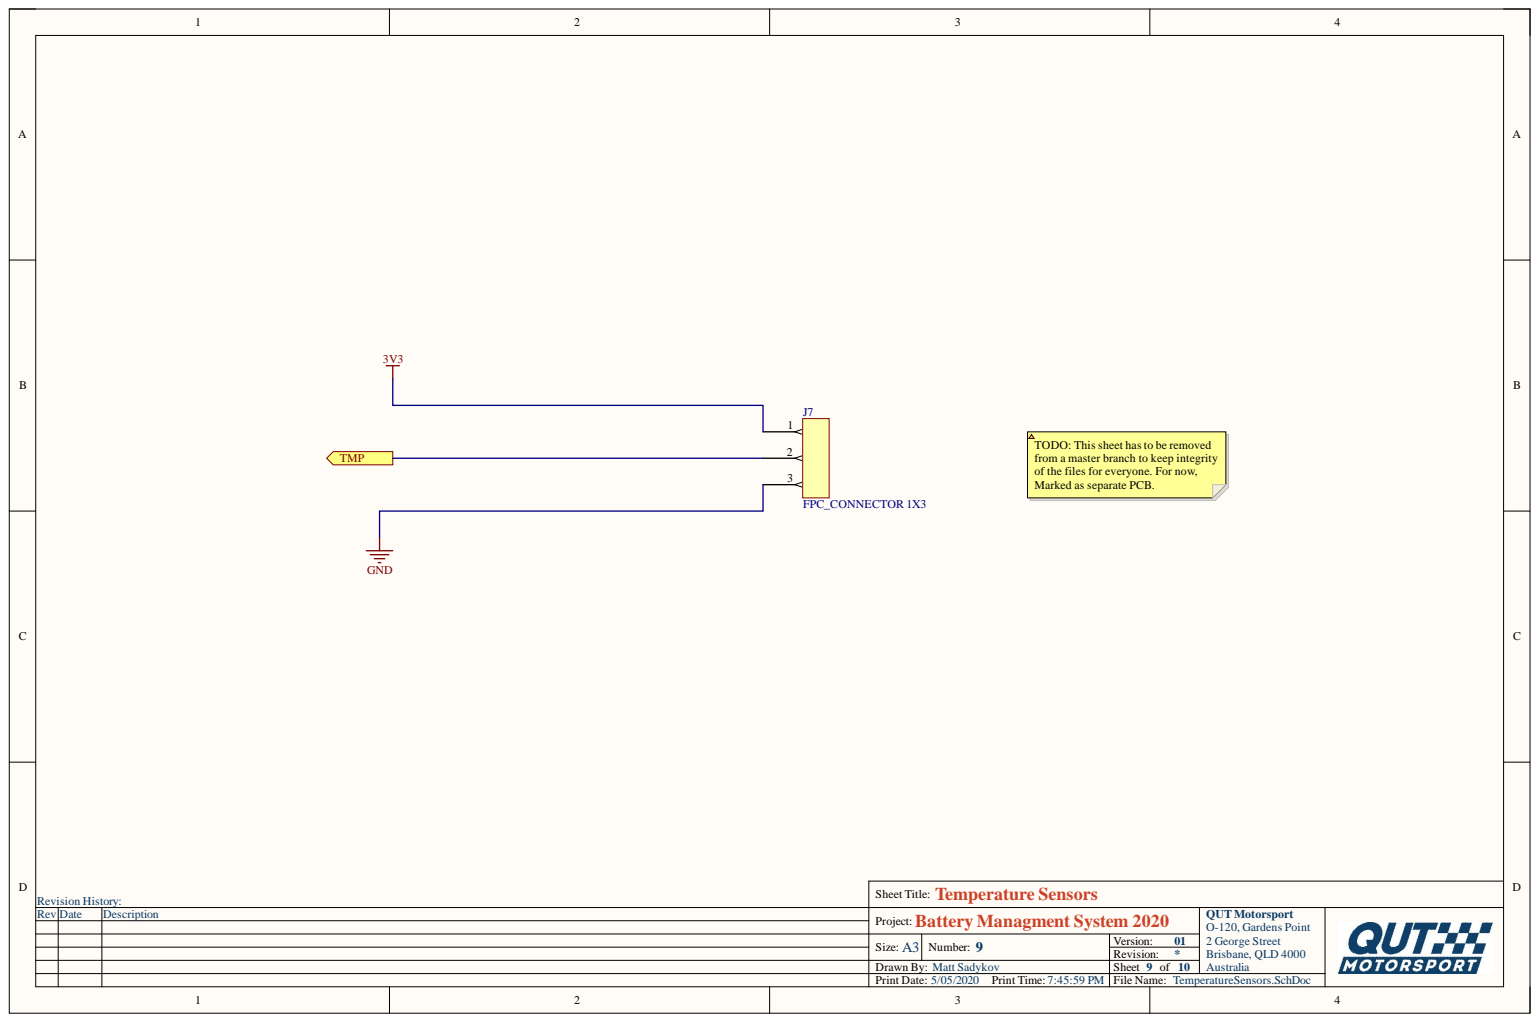
[picture p37: page 9]

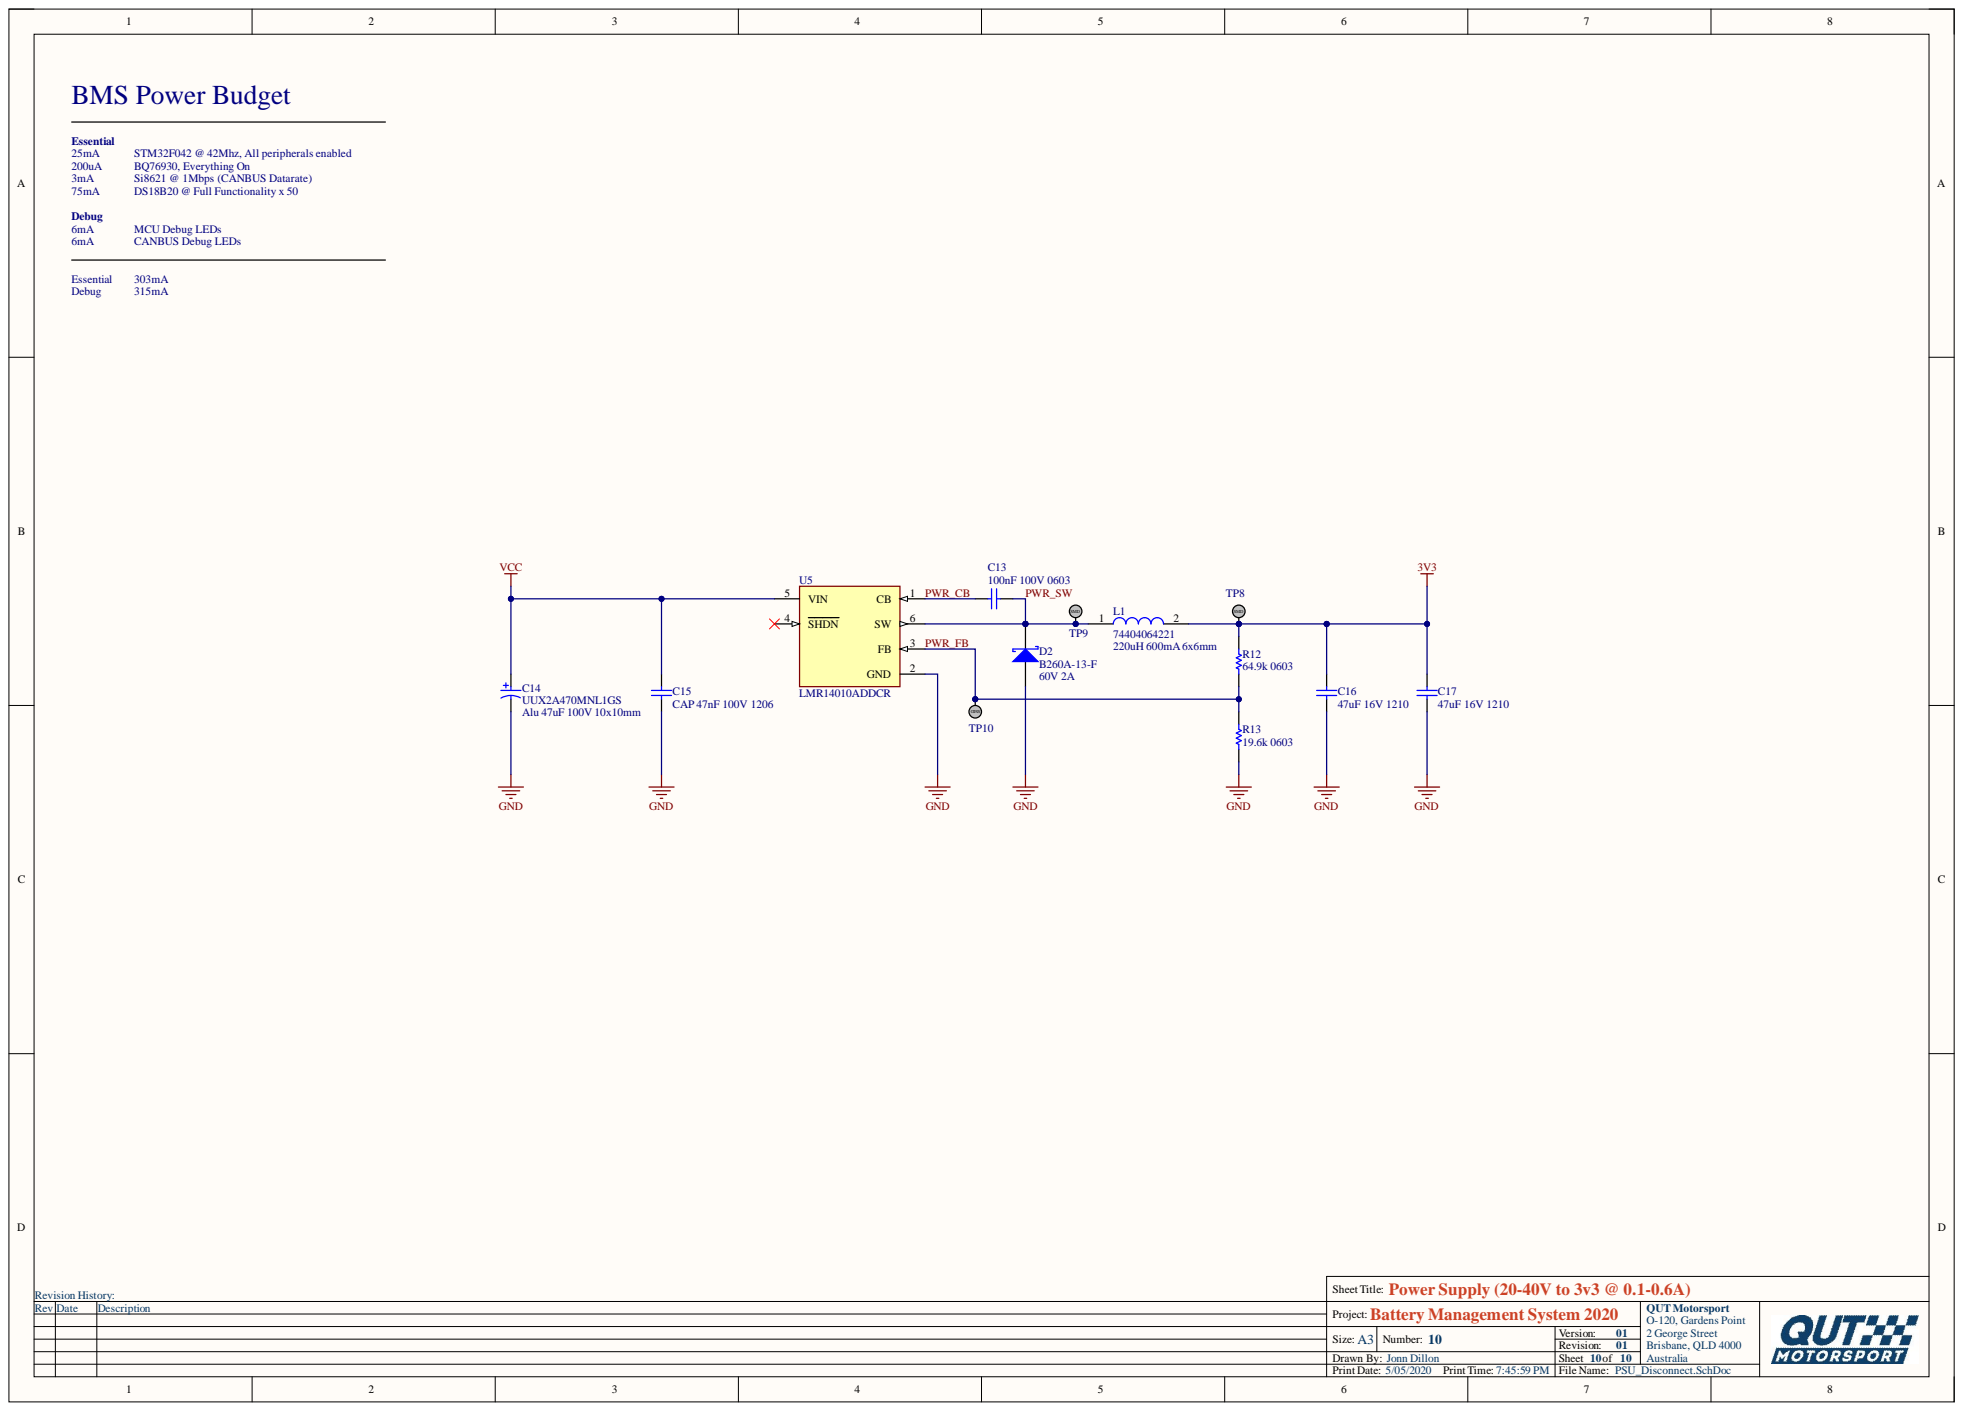
[picture p38: page 10]
