Salmon-Built-Designs/QUTMS_BMS/hardware/QUTMS-BMS-TEMPSTRIP-LEFT-V00/QUTMS-BMS-TEMPSTRIP-PLACEMENTS.pdf

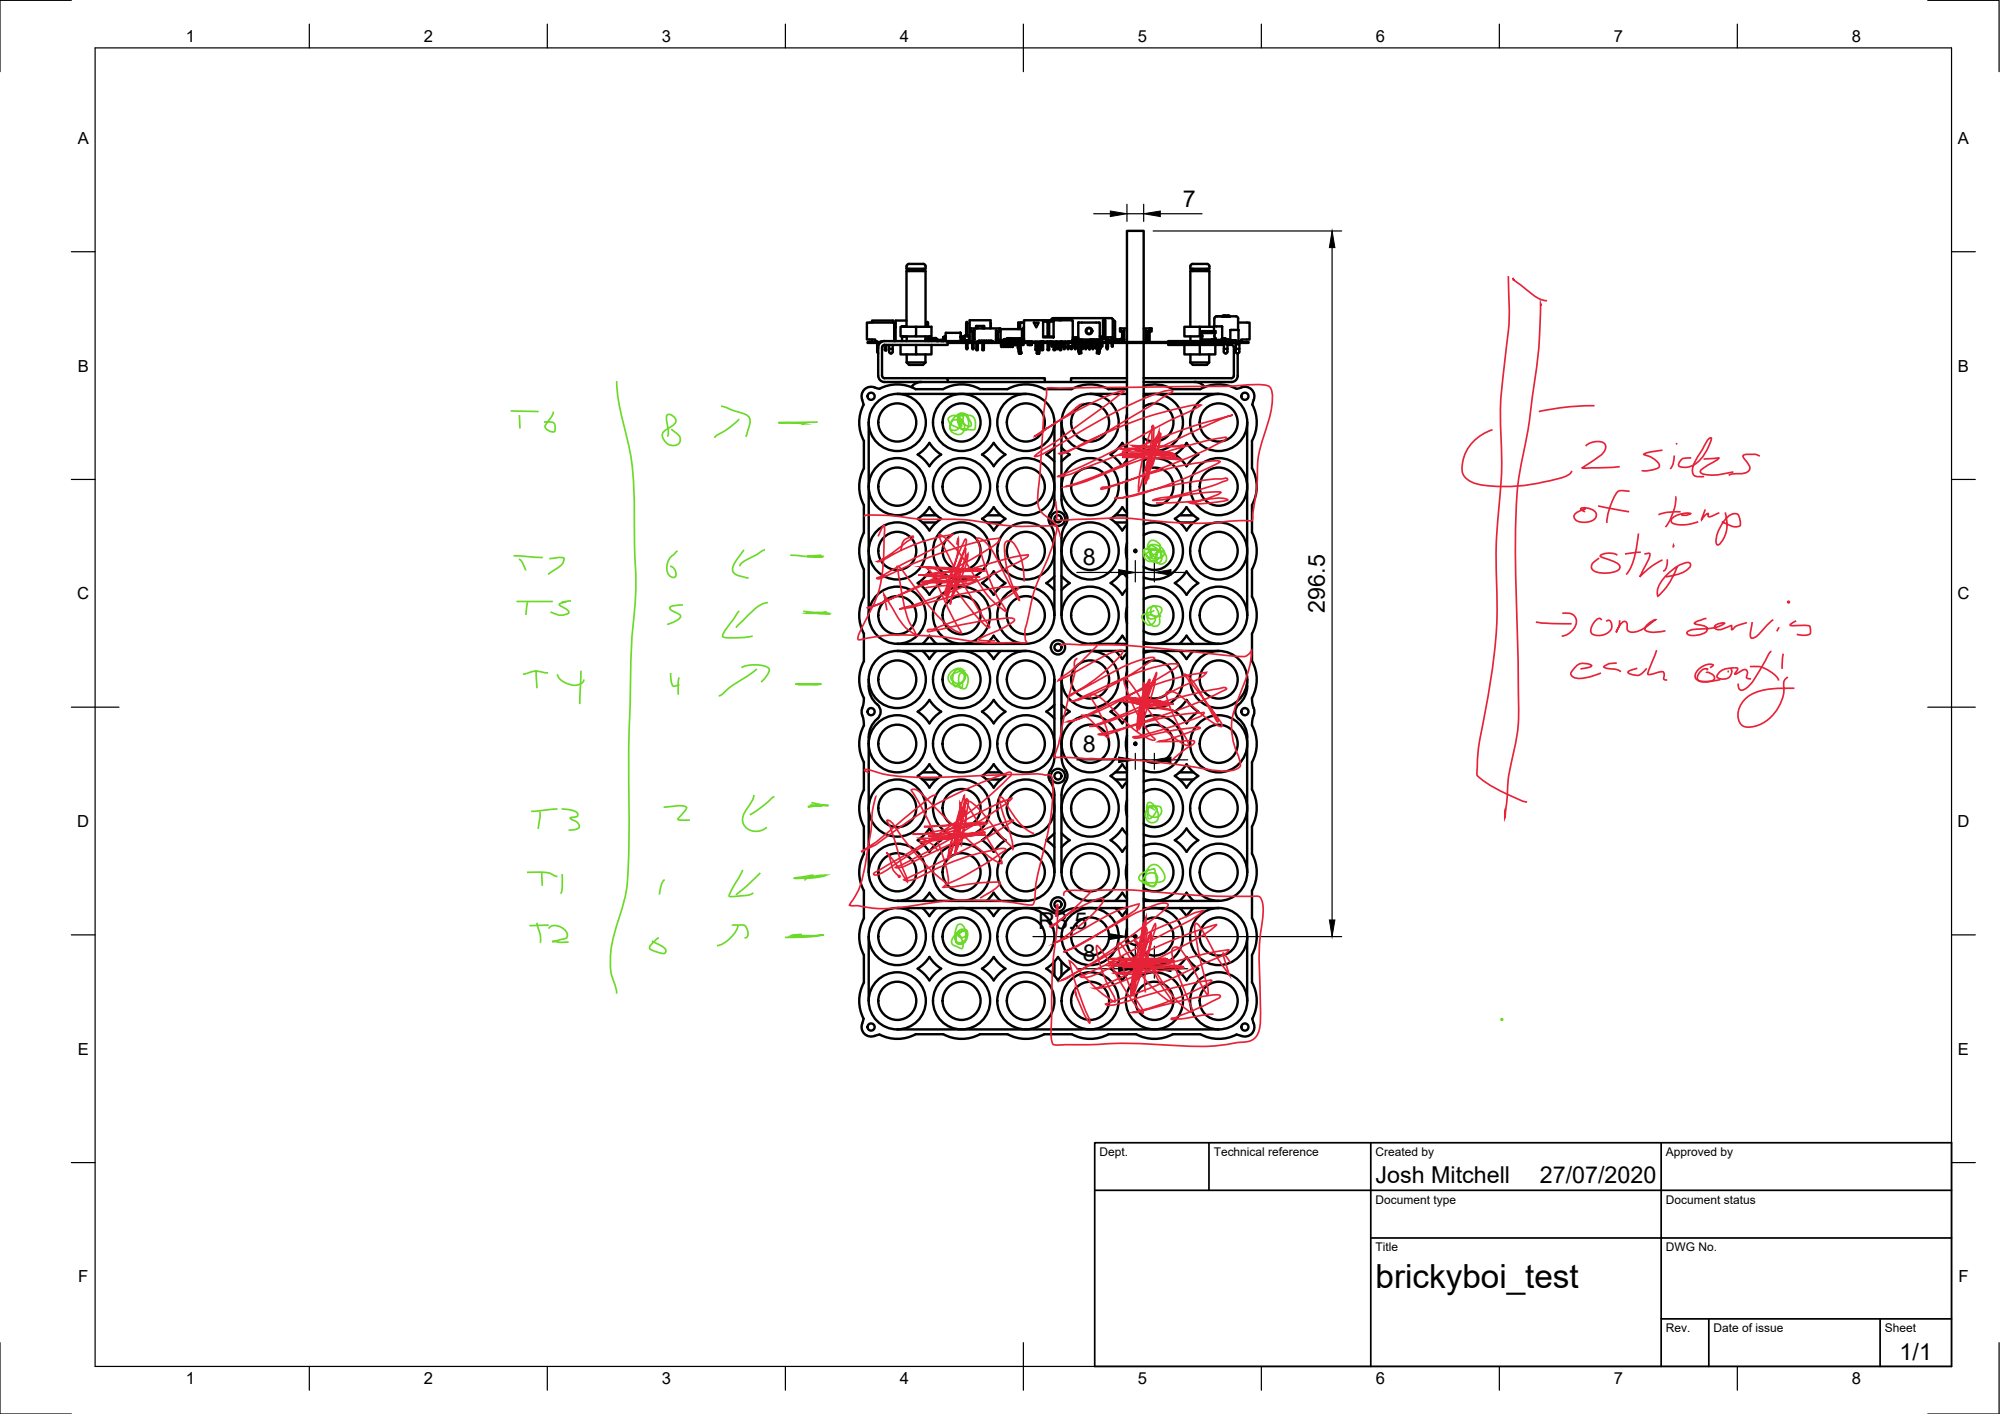
[picture p39: page 1]

Dept. | Technical reference | Created by Josh Mitchell 27/07/2020 | Approved by

Document type | Document status

Title brickyboi_test | DWG No.

Rev. | Date of issue | Sheet 1/1
