Salmon-Built-Designs/QUTMS_BMS/hardware/QUTMS-BMS-TEMPSTRIP-LEFT-V00/OrthagSideView.pdf

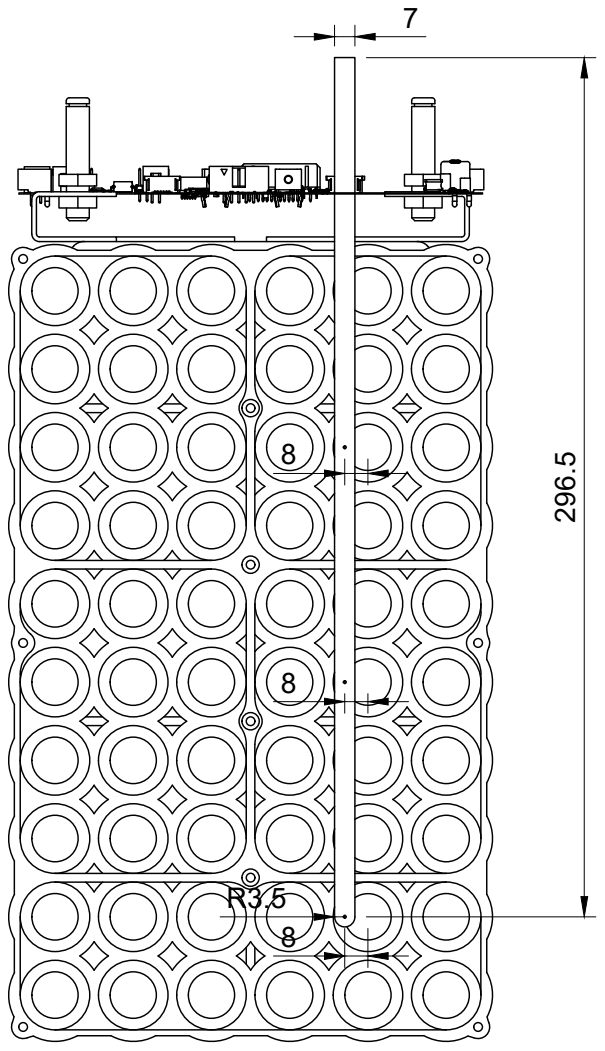
[picture p40: page 1]
