Salmon-Built-Designs/QUTMS_BMS/(list of files, drawings)

Other design files:
hardware/BMS_2020/BMS-P00-V00.PcbDoc
hardware/BMS_2020/BMS-S01-V00-BatteryManagementSystem.SchDoc
hardware/BMS_2020/BMS-S01-V01-BatteryManagementSystem.SchDoc
hardware/BMS_2020/BMS-S01-V02-BatteryManagementSystem.SchDoc
hardware/BMS_2020/BMS-S02-V00-CellMonitor.SchDoc
hardware/BMS_2020/BMS-S02-V01-CellMonitor.SchDoc
hardware/BMS_2020/BMS-S03-V00-CellInterface.SchDoc
hardware/BMS_2020/BMS-S03-V01-CellInterface.SchDoc
hardware/BMS_2020/BMS-S04-V00-Microcontroller.SchDoc
hardware/BMS_2020/BMS-S04-V01-Microcontroller.SchDoc
hardware/BMS_2020/BMS-S05-V00-Isolation.SchDoc
hardware/BMS_2020/BMS-S05-V01-Isolation.SchDoc
hardware/BMS_2020/BMS-S06-V00-IsolatedCAN.SchDoc
hardware/BMS_2020/BMS-S06-V01-IsolatedCAN.SchDoc
hardware/BMS_2020/BMS-S07-V00-PSU.SchDoc
hardware/BMS_2020/BMS-S07-V01-PSU.SchDoc
hardware/BMS_2020/BMS-S08-V00-TemperatureSensorInterface.SchDoc
hardware/BMS_2020/BMS-S08-V01-TemperatureSensorInterface.SchDoc
hardware/BMS_2020/BMS-S09-V00-TemperatureSensors.SchDoc
hardware/BMS_2020/BMS-S09-V01-TemperatureSensors.SchDoc
hardware/BMS_2020/CellMonitor.PcbLib
hardware/BMS_2020/CellMonitor.SchLib
hardware/BMS_2020/FFCConnectors.PcbLib
hardware/BMS_2020/FFCConnectors.SchLib
hardware/BMS_2020/IDCConnectors.PcbLib
hardware/BMS_2020/IDCConnectors.SchLib
hardware/BMS_2020/QUTMS-BMS-V00.SCHLIB
hardware/BMS_2020/QUTMS-BMS-V01.PrjPcb
hardware/BMS_2020/QUTMS_CANLibrary.PcbLib
hardware/BMS_2020/QUTMS_CANLibrary.SchLib
hardware/BMS_2020/QUTMS_CrystalLibrary.PcbLib
hardware/BMS_2020/QUTMS_CrystalLibrary.SchLib
hardware/BMS_2020/QUTMS_DiodeLibrary.PcbLib
hardware/BMS_2020/QUTMS_DiodeLibrary.SchLib
hardware/BMS_2020/QUTMS_InductorLibrary.PcbLib
hardware/BMS_2020/QUTMS_InductorLibrary.SchLib
hardware/BMS_2020/QUTMS_IsolatorLibrary.PcbLib
hardware/BMS_2020/QUTMS_IsolatorLibrary.SchLib
hardware/BMS_2020/QUTMS_JumperLibrary.PcbLib
hardware/BMS_2020/QUTMS_JumperLibrary.SchLib
hardware/BMS_2020/QUTMS_LEDLibrary.PcbLib
hardware/BMS_2020/QUTMS_LEDLibrary.SchLib
hardware/BMS_2020/QUTMS_MicrofitLibrary.PcbLib
hardware/BMS_2020/QUTMS_MicrofitLibrary.SchLib
hardware/BMS_2020/QUTMS_OctocouplerLibrary.PcbLib
hardware/BMS_2020/QUTMS_OctocouplerLibrary.SchLib
hardware/BMS_2020/QUTMS_PCBLibrary.PcbLib
hardware/BMS_2020/QUTMS_PCBLibrary.SchLib
hardware/BMS_2020/QUTMS_PowerSupplyLibrary.PcbLib
hardware/BMS_2020/QUTMS_PowerSupplyLibrary.SchLib
hardware/BMS_2020/QUTMS_STM32Library.PcbLib
hardware/BMS_2020/QUTMS_STM32Library.SchLib
hardware/BMS_2020/QUTMS_SwitchLibrary.PcbLib
hardware/BMS_2020/QUTMS_SwitchLibrary.SchLib
hardware/BMS_2020/StandardCapacitors.PcbLib
hardware/BMS_2020/StandardCapacitors.SchLib
hardware/BMS_2020/StandardResistors.PcbLib
hardware/BMS_2020/StandardResistors.SchLib
hardware/QUTMS-BMS-TEMPSTRIP-LEFT-V00/BMS-TEMPSTRIP-LEFT-P00.PcbDoc
hardware/QUTMS-BMS-TEMPSTRIP-LEFT-V00/BMS-TEMPSTRIP-LEFT-S00.SchDoc
hardware/QUTMS-BMS-TEMPSTRIP-LEFT-V00/BMS-TEMPSTRIP.pcblib
hardware/QUTMS-BMS-TEMPSTRIP-LEFT-V00/BMS-TEMPSTRIP.schlib
hardware/QUTMS-BMS-TEMPSTRIP-LEFT-V00/QUTMS-BMS-TEMPSTRIP-LEFT-V00.PrjPcb
hardware/QUTMS-BMS-TEMPSTRIP-LEFT-V00/QUTMS_PCBLibrary.PcbLib
hardware/QUTMS-BMS-TEMPSTRIP-LEFT-V00/QUTMS_PCBLibrary.SchLib
hardware/QUTMS-BMS-TEMPSTRIP-LEFT-V00/StandardCapacitors.PcbLib
hardware/QUTMS-BMS-TEMPSTRIP-LEFT-V00/StandardCapacitors.SchLib
hardware/QUTMS-BMS-TEMPSTRIP-LEFT-V00/StandardTest.PcbLib
hardware/QUTMS-BMS-TEMPSTRIP-LEFT-V00/StandardTest.SchLib
hardware/QUTMS-BMS-TEMPSTRIP-RIGHT-V00/BMS-TEMPSTRIP-RIGHT-P00.PcbDoc
hardware/QUTMS-BMS-TEMPSTRIP-RIGHT-V00/BMS-TEMPSTRIP-RIGHT-S00.SchDoc
hardware/QUTMS-BMS-TEMPSTRIP-RIGHT-V00/BMS-TEMPSTRIP.pcblib
hardware/QUTMS-BMS-TEMPSTRIP-RIGHT-V00/BMS-TEMPSTRIP.schlib
hardware/QUTMS-BMS-TEMPSTRIP-RIGHT-V00/QUTMS-BMS-TEMPSTRIP-RIGHT-V00.PrjPcb
hardware/QUTMS-BMS-TEMPSTRIP-RIGHT-V00/QUTMS_PCBLibrary.PcbLib
hardware/QUTMS-BMS-TEMPSTRIP-RIGHT-V00/QUTMS_PCBLibrary.SchLib
hardware/QUTMS-BMS-TEMPSTRIP-RIGHT-V00/StandardCapacitors.PcbLib
hardware/QUTMS-BMS-TEMPSTRIP-RIGHT-V00/StandardCapacitors.SchLib
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
