Salmon-Built-Designs/QUTMS_BMS/software/Core/Src/can.c

/**
  ******************************************************************************
  * @file    can.c
  * @brief   This file provides code for the configuration
  *          of the CAN instances.
  ******************************************************************************
  * @attention
  *
  * <h2><center>&copy; Copyright (c) 2021 STMicroelectronics.
  * All rights reserved.</center></h2>
  *
  * This software component is licensed by ST under BSD 3-Clause license,
  * the "License"; You may not use this file except in compliance with the
  * License. You may obtain a copy of the License at:
  *                        opensource.org/licenses/BSD-3-Clause
  *
  ******************************************************************************
  */

/* Includes ------------------------------------------------------------------*/
#include "can.h"

/* USER CODE BEGIN 0 */
#include "QUTMS_can.h"
#include <string.h>
#include <stdio.h>
#include "usart.h"
/* USER CODE END 0 */

CAN_HandleTypeDef hcan;

/* CAN init function */
void MX_CAN_Init(void)
{

  hcan.Instance = CAN;
  hcan.Init.Prescaler = 6;
  hcan.Init.Mode = CAN_MODE_NORMAL;
  hcan.Init.SyncJumpWidth = CAN_SJW_1TQ;
  hcan.Init.TimeSeg1 = CAN_BS1_13TQ;
  hcan.Init.TimeSeg2 = CAN_BS2_2TQ;
  hcan.Init.TimeTriggeredMode = DISABLE;
  hcan.Init.AutoBusOff = DISABLE;
  hcan.Init.AutoWakeUp = DISABLE;
  hcan.Init.AutoRetransmission = DISABLE;
  hcan.Init.ReceiveFifoLocked = ENABLE;
  hcan.Init.TransmitFifoPriority = DISABLE;
  if (HAL_CAN_Init(&hcan) != HAL_OK)
  {
    Error_Handler();
  }

}

void HAL_CAN_MspInit(CAN_HandleTypeDef* canHandle)
{

  GPIO_InitTypeDef GPIO_InitStruct = {0};
  if(canHandle->Instance==CAN)
  {
    /* CAN clock enable */
    __HAL_RCC_CAN1_CLK_ENABLE();

    __HAL_RCC_GPIOA_CLK_ENABLE();
    /**CAN GPIO Configuration
    PA11     ------> CAN_RX
    PA12     ------> CAN_TX
    */
    GPIO_InitStruct.Pin = GPIO_PIN_11|GPIO_PIN_12;
    GPIO_InitStruct.Mode = GPIO_MODE_AF_PP;
    GPIO_InitStruct.Pull = GPIO_PULLUP;
    GPIO_InitStruct.Speed = GPIO_SPEED_FREQ_HIGH;
    GPIO_InitStruct.Alternate = GPIO_AF4_CAN;
    HAL_GPIO_Init(GPIOA, &GPIO_InitStruct);

  }
}

void HAL_CAN_MspDeInit(CAN_HandleTypeDef* canHandle)
{

  if(canHandle->Instance==CAN)
  {
    /* Peripheral clock disable */
    __HAL_RCC_CAN1_CLK_DISABLE();

    /**CAN GPIO Configuration
    PA11     ------> CAN_RX
    PA12     ------> CAN_TX
    */
    HAL_GPIO_DeInit(GPIOA, GPIO_PIN_11|GPIO_PIN_12);

  }
}

/* USER CODE BEGIN 1 */
void Configure_CAN(CAN_HandleTypeDef *canHandle) {
	CAN_FilterTypeDef sFilterConfig;

	// only want to accept messages from the AMS

	/* Configure the CAN Filter */
	sFilterConfig.FilterBank = 0;
	sFilterConfig.FilterMode = CAN_FILTERMODE_IDMASK;
	sFilterConfig.FilterScale = CAN_FILTERSCALE_32BIT;

	// what bits of the CAN ID do we care about
	sFilterConfig.FilterMaskIdHigh = (CAN_MASK_SRC_ID & 0xFFFF) >> (16);
	sFilterConfig.FilterMaskIdLow = (CAN_MASK_SRC_ID & 0xFFFF);

	// what values do we want
	sFilterConfig.FilterIdHigh = (CAN_SRC_ID_AMS & 0xFFFF) >> (16);
	sFilterConfig.FilterIdLow = (CAN_SRC_ID_AMS & 0xFFFF);

	sFilterConfig.FilterFIFOAssignment = CAN_RX_FIFO0;
	sFilterConfig.FilterActivation = ENABLE;
	sFilterConfig.SlaveStartFilterBank = 14;

	// add filter for incoming messages
	if (HAL_CAN_ConfigFilter(&hcan, &sFilterConfig) != HAL_OK) {
		Error_Handler();
	}

	// start peripheral
	if (HAL_CAN_Start(&hcan) != HAL_OK) {
		Error_Handler();
	}

	// activate rx notification
	if (HAL_CAN_ActivateNotification(&hcan, CAN_IT_RX_FIFO0_MSG_PENDING) != HAL_OK) {
		Error_Handler();
	}
}
/* USER CODE END 1 */

/************************ (C) COPYRIGHT STMicroelectronics *****END OF FILE****/
