Salmon-Built-Designs/QUTMS_BMS/(commit log)

2020-04-16 Initial BMS Project
    [BMS_2020.PrjPcb, CellMonitor.SchDoc, IsolationConnector.SchDoc, MCU.SchDoc, Power.SchDoc]
2020-04-16 Edit sheet names to correlate to block diagram
    [CellMonitor.SchDoc, IsolationConnector.SchDoc, Isolation_Connector.SchDoc, PSU_Disconnect.SchDoc, Power.SchDoc]
2020-04-16 Fix project file
    [BMS_2020.PrjPcb]
2020-04-16 Added in a larger master document, to help connect all of the sheets together. Also fixed up the sheet annotations to hopefully clearence all the sheets
    [CellMonitor.SchDoc, ExternalConnectors.SchDoc, IDCConnectors.PcbLib, IDCConnectors.SchLib, IsolationBarrier.SchDoc, Isolation_Connector.SchDoc, MCU.SchDoc, Master.SchDoc]
2020-04-25 Added isolation barrier, canbus, connectors and updated the mater sheet to be appropiately connected
    [522710679.stp, 522710879.stp, 526100672.stp, 526100872.stp, 526101272.stp, BMS_2020.PrjPcb, CANBUS_3V3_Isolated.SchDoc, ExternalConnectors.SchDoc]
2020-04-25 First work on PSU. Used the TI Webench software to generate a schematic, working on own calculations.
    [BMS_2020.PrjPcb, LMR14010A_Calculations.xlsx, PSU_Disconnect.SchDoc]
2020-04-27 Temperature side with flexible temperature board.
    Added design of flexible temperature board with 7 digital sensors (for now). All connected to single part on Master design through same connections as old temp boards used. NExt, connect to MCU.
    [BMS_2020.PrjPcb, MCU.SchDoc, Master.SchDoc, TemperatureSensor.SchDoc, TemperatureSensors.SchDoc]
2020-04-27 First Temp version.
    Zoe will handle the MCU. I still vote for seprate I2C channel for sefety. Even separet one for each side of the brick.
    [MCU.SchDoc, Master.SchDoc]
2020-04-28 Cell monitor with BQ769x0
    Have added most of the external cell balancing circuitry. Still need to add a bunch of stuff to the right hand side of the chip.
    [CellMonitor.SchDoc, Master.SchDoc]
2020-04-28 Added MCU schematic and formatted Temp sensors and cell monitor.
    [BMS_2020.PrjPcb, CANBUS_3V3_Isolated.SchDoc, CellMonitor.SchDoc, ExternalConnectors.SchDoc, IsolationBarrier.SchDoc, MCU.SchDoc, Master.SchDoc, PSU_Disconnect.SchDoc]
2020-05-04 Refined CANBUS and isolation section, updated power supply
    [74404064221_WE-LQS.stp, 77311-y18-02_asm.stp, 77311-y18-03_asm.stp, CANBUS_3V3_Isolated.SchDoc, D0008A.stp, ExternalConnectors.SchDoc, IsolationBarrier.SchDoc, PSU_Disconnect.SchDoc]
2020-05-05 Completed first draft of BQ chip with subsheets.
    jStill unsure what to do with TS1 and the Charge and Discharge Ports
    [BMS_2020.PrjPcb, CellConnections.SchDoc, CellMonitor.SchDoc, CellMonitorV2.SchDoc, ExternalBalancing.SchDoc, Master.SchDoc]
2020-05-05 MCU updates
    [Crystal.SchLib, LQFP48.STEP, MCU.SchDoc, Master.SchDoc, STM32.PcbLib, STM32.SchLib]
2020-05-05 Combine MCU and Jonns work
    [MCU.SchDoc]
2020-05-05 Clean up for reviewal on 5/05/2020
    [BMS_2020.PrjPcb, CANBUS_3V3_Isolated.SchDoc, CellConnections.SchDoc, CellMonitor.SchDoc, Crystal.SchLib, ExternalBalancing.SchDoc, IsolationBarrier.SchDoc, MCU.SchDoc]
2020-05-10 Added all minor changes from latest meeting
    [CANBUS_3V3_Isolated.SchDoc, IsolationBarrier.SchDoc, PSU_Disconnect.SchDoc]
2020-05-12 Changed temperature sensors
    [522710479.stp, FFCConnectors.PcbLib, FFCConnectors.SchLib, Master.SchDoc, TemperatureSensor.SchDoc, TemperatureSensors.SchDoc]
2020-05-12 Fixed incorrectly named nets
    [Master.SchDoc, TemperatureSensor.SchDoc]
2020-05-12 Added in MEMS oscillator and routed the temp sensors to the MCU
    [MCU.SchDoc, QUTMS_CrystalLibrary.PcbLib, QUTMS_CrystalLibrary.SchLib]
2020-05-12 Changes to Cell Monitoring Schematic 12/05/2020
    Fuses added. Broke out connection subsheet. Created fuse symbols. Changed name of BM chip. Added suggested N-type MOSFET.
    [BMS_2020.PrjPcb, CellMonitor.PcbLib, CellMonitor.SchDoc, CellMonitor.SchLib, ExternalBalancing.SchDoc]
2020-05-12 Change USART to UART
    [MCU.SchDoc]
2020-05-13 Removed orphaned cell connections sheet from project
    [BMS_2020.PrjPcb]
2020-05-14 Major rework to cell balancing subsystem.
    Added cell monitor library to project.
    Modified cell monitor symbol.
    Added charge pump symbol to library.
    Redrew cell interface circuit and relabeled ports.
    Added input fuses as first component after cell connection connectors.
    Added boot switch and ports for connection to boot opto.
    Added disconnect FET and associated charge pump.
    TODO: Check all component values and active components selection.
    TODO: Replace placeholder symbols with correct library parts.
    TODO: Review electrical design per datasheets and app notes.
    TODO: Confirm random connection of cells will not result in damage to part.
    [BMS_2020.PrjPcb, CellMonitor.SchDoc, CellMonitor.SchLib, ExternalBalancing.SchDoc]
2020-05-14 Minor edits to MCU sheet, mostly graphical
    Modified oscillator symbol (not standby, pin locations, designator prefix).
    Graphical edits to routing.
    Simplified temperature sensor net labels.
    Updated port labels.
    Renamed port on cell monitor sheet for consistent use of BMS prefix.
    [CellMonitor.SchDoc, MCU.SchDoc, QUTMS_CrystalLibrary.SchLib]
2020-05-14 Changed input port to 36V
    TODO: Consider resistor divider for UVLO.
    [PSU_Disconnect.SchDoc]
2020-05-14 Alarm loop redraw and port renaming
    Redrew alarm signal loop to better show connectivity.
    Modifed port names consistent with edits to other sheets.
    Modified ISO GND and ISO 3V3 power port names to eliminate underscore and use ISO as prefix.
    [CANBUS_3V3_Isolated.SchDoc, IsolationBarrier.SchDoc]
2020-05-14 Renamed nets/ports and minor graphical edits
    [TemperatureSensor.SchDoc, TemperatureSensors.SchDoc]
2020-05-14 Sync'd sheet entries/ports. Minor graphical edits
    [Master.SchDoc]
2020-05-15 Project restructure
    Renames sheets with consistent naming convention.
    Deleted old harness definitions and regenerated.
    Updated sheet symbols to reflect new sheet names.
    TODO: Consolidate document propoerties (sheet number, title etc.); make consistent with new sheet numbering/naming etc.
    TODO: Some unterminated ports (micro and cell monitor)
    [BMS-S01-V00-BatteryManagementSystem.SchDoc, BMS-S02-V00-CellMonitor.SchDoc, BMS-S03-V00-CellInterface.SchDoc, BMS-S04-V00-Microcontroller.SchDoc, BMS-S05-V00-Isolation.SchDoc, BMS-S06-V00-IsolatedCAN.SchDoc, BMS-S07-V00-PSU.SchDoc, BMS-S08-V00-TemperatureSensorInterface.SchDoc]
2020-05-19 Most footprints added, still need to do zener, push button, fuses and mosfet for CHG port.
    [BMS-S02-V00-CellMonitor.SchDoc, BMS-S03-V00-CellInterface.SchDoc, CellMonitor.PcbLib, CellMonitor.SchLib]
2020-06-23 Changed symbol colours to blue Changed descriptions to QUTMS standards Added Fuse symbols and footprints Added test points
    [BMS-S02-V00-CellMonitor.SchDoc, BMS-S03-V00-CellInterface.SchDoc, CellMonitor.PcbLib, CellMonitor.SchLib, QUTMS-BMS-V00.PrjPcb]
2020-06-23 Added Transistor sym and footprint Added pushbtn Minor changes
    [BMS-S02-V00-CellMonitor.SchDoc, BMS-S03-V00-CellInterface.SchDoc, CellMonitor.PcbLib, CellMonitor.SchLib]
2020-06-24 Finalised library, document exports etc
    [BMS-S01-V00-BatteryManagementSystem.SchDoc, BMS-S02-V00-CellMonitor.SchDoc, BMS-S03-V00-CellInterface.SchDoc, BMS-S04-V00-Microcontroller.SchDoc, BMS-S05-V00-Isolation.SchDoc, BMS-S06-V00-IsolatedCAN.SchDoc, BMS-S07-V00-PSU.SchDoc, BMS-S08-V00-TemperatureSensorInterface.SchDoc]
2020-06-26 Replaced Fuses with 5A variant Checked Connections Replace 10k with proper symbols Added 10k to Cell Alert line Added 10k to DSG line Added 10k to CHG line Added suggested transistor and diode for VC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
    [BMS-S02-V00-CellMonitor.SchDoc, BMS-S03-V00-CellInterface.SchDoc, BMS-S04-V00-Microcontroller.SchDoc, BMS-S08-V00-TemperatureSensorInterface.SchDoc, BMS-S09-V00-TemperatureSensors.SchDoc, CellMonitor.PcbLib, CellMonitor.SchLib, CellMonitor.csv]
2020-06-27 Changed temperatures sensors pin assignment to add guarding to lines, and added 0 Ohm jumper, to replaced in case of transmission line effects
    [BMS-S08-V00-TemperatureSensorInterface.SchDoc, BMS-S09-V00-TemperatureSensors.SchDoc]
2020-06-27 Added UVLO at 22V, slightly less than abs min voltage (2.2V per cell)
    [BMS-S07-V00-PSU.SchDoc]
2020-06-27 Somehow broke the BQ7_4 import, readded all files
    [BMS-S02-V00-CellMonitor.SchDoc, BMS-S03-V00-CellInterface.SchDoc, BMS-S04-V00-Microcontroller.SchDoc]
2020-06-27 Replaced all capactiors and resistors with a standard library
    [BMS-S01-V00-BatteryManagementSystem.SchDoc, BMS-S02-V00-CellMonitor.SchDoc, BMS-S03-V00-CellInterface.SchDoc, BMS-S04-V00-Microcontroller.SchDoc, BMS-S05-V00-Isolation.SchDoc, BMS-S06-V00-IsolatedCAN.SchDoc, BMS-S07-V00-PSU.SchDoc, BMS-S09-V00-TemperatureSensors.SchDoc]
2020-06-27 Added PCB library for holes, logos, icons, fiduials and layer identifiers
    [QUTMS_PCBLibrary.PcbLib, QUTMS_PCBLibrary.SchLib]
2020-06-27 Added capacitors and updated a little of everything to sheets
    [BMS-S01-V00-BatteryManagementSystem.SchDoc, BMS-S02-V00-CellMonitor.SchDoc, BMS-S04-V00-Microcontroller.SchDoc, BMS-S07-V00-PSU.SchDoc, CellMonitor.SchLib, QUTMS-BMS-V00.PrjPcb]
2020-06-28 Added lots of parts in, diodes, micofits, siwtchs, octocouplers. Every part is now in an offical library
    [436500519.stp, 436500525.stp, 436500819.stp, 436500825.stp, BMS-S01-V00-BatteryManagementSystem.SchDoc, BMS-S02-V00-CellMonitor.SchDoc, BMS-S03-V00-CellInterface.SchDoc, BMS-S04-V00-Microcontroller.SchDoc]
2020-06-28 Added in correctly sided PCB logos for MS, fixed up many incorrect part references, almost ready for layout
    [BMS-S01-V00-BatteryManagementSystem.SchDoc, BMS-S02-V00-CellMonitor.SchDoc, BMS-S03-V00-CellInterface.SchDoc, BMS-S04-V00-Microcontroller.SchDoc, BMS-S05-V00-Isolation.SchDoc, BMS-S06-V00-IsolatedCAN.SchDoc, BMS-S07-V00-PSU.SchDoc, CellMonitor.PcbLib]
2020-06-29 Fixed temp sensor lines
    [BMS-S04-V00-Microcontroller.SchDoc, BMS-S08-V00-TemperatureSensorInterface.SchDoc]
2020-06-29 Changes 29-06 2:52pm
    Added suggested transistor
    Added Layout rule to high current path
    Fixed Temp sense layout
    [BMS-S02-V00-CellMonitor.SchDoc, CellMonitor.SchLib]
2020-06-29 Added temperature harness, ensured all sheets are A3
    [BMS-S01-V00-BatteryManagementSystem.SchDoc, BMS-S02-V00-CellMonitor.SchDoc, BMS-S03-V00-CellInterface.SchDoc, BMS-S04-V00-Microcontroller.SchDoc, BMS-S05-V00-Isolation.SchDoc, BMS-S06-V00-IsolatedCAN.SchDoc, BMS-S07-V00-PSU.SchDoc, BMS-S08-V00-TemperatureSensorInterface.SchDoc]
2020-06-30 Fixed capacitor blunder, and added in logic analyser points
    [BMS-S02-V00-CellMonitor.SchDoc, BMS-S03-V00-CellInterface.SchDoc, BMS-S04-V00-Microcontroller.SchDoc, BMS-S06-V00-IsolatedCAN.SchDoc, BMS-S07-V00-PSU.SchDoc, QUTMS-BMS-V00.PrjPcb]
2020-06-30 Forgot to change out the LMR14010 chip with a made one
    [BMS-S07-V00-PSU.SchDoc, QUTMS_PowerSupplyLibrary.PcbLib, QUTMS_PowerSupplyLibrary.SchLib]
2020-06-30 Fixed things
    [BMS-S07-V00-PSU.SchDoc, QUTMS_PowerSupplyLibrary.SchLib]
2020-06-30 Created PCB Doc
    Fixed fuses, capacitors and generated the PCB doc
    [BMS-B01.PcbDoc, BMS-P00-V00.PcbDoc, BMS-S02-V00-CellMonitor.SchDoc, BMS-S07-V00-PSU.SchDoc, CellMonitor.SchLib, QUTMS-BMS-V00.PrjPcb]
2020-07-01 Small Layout Changes
    [BMS-S02-V00-CellMonitor.SchDoc, BMS-S07-V00-PSU.SchDoc]
2020-07-02 Placed components in a board like shape
    4:14pm 2nd June
    [BMS-S07-V00-PSU.SchDoc, QUTMS_DiodeLibrary.SchLib]
2020-07-06 Stashed
    6/07
    [BMS-B01.PcbDoc, BMS-S03-V00-CellInterface.SchDoc]
2020-07-06 Added PCB to project
    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
    [BMS-S02-V00-CellMonitor.SchDoc, QUTMS-BMS-V00.PrjPcb]
2020-07-17 Big update
    Changes from 13th till 17th.
    Big chanegs, hopefully this doesn't mess everything up
    [BMS-S04-V00-Microcontroller.SchDoc, BMS-S09-V00-TemperatureSensors.SchDoc, FFCConnectors.PcbLib, FFCConnectors.SchLib, IDCConnectors.PcbLib, QUTMS-BMS-V00.PrjPcb]
2020-07-17 Added PCBDOC back into project
    [QUTMS-BMS-V00.PrjPcb]
2020-07-17 Possible fanout considering pin-swapping
2020-07-20 Micro and BQ Reroute
    Pin swap operation performed on the micro to allow easy routing of temp sensors and other traces. Moved all of the bottom layer micro components top side. Moved all of the BQ bottom layer components top side and rerouted. Still need to connect LA's.
    [BMS-S04-V00-Microcontroller.SchDoc, QUTMS-BMS-V00.PrjPcb]
2020-07-21 Suggested changes to cell monitor routing
    [BMS-S02-V00-CellMonitor.SchDoc]
2020-07-22 Board Dimension updates
    Added 0805 Cap footprint, moved most components on board to accomodate Josh's changes.
    [BMS-S02-V00-CellMonitor.SchDoc, BMS-S04-V00-Microcontroller.SchDoc, StandardCapacitors.SchLib]
2020-07-22 Forgot to save
    [BMS-S04-V00-Microcontroller.SchDoc]
2020-07-22 Post review changes
    To do: Move PSU closer, add fiducuiares, move traces down the bottom of the board so that they only need one via dn move the LA above them, change the diameter of the LA top layer holes, Connect 3v3 to the micro
    [BMS-S02-V00-CellMonitor.SchDoc]
2020-07-23 Connected 3v3 and moved traces in prep for LA
2020-07-23 Repinned LA's
    [BMS-S04-V00-Microcontroller.SchDoc]
2020-07-24 Routed LA's, Programmer. Added most gorund vias.
    [BMS-S04-V00-Microcontroller.SchDoc]
2020-07-24 More ground vias
2020-07-24 Added more GND vias
2020-07-24 Added gnd vias
2020-07-27 Marks Review
    [BMS-S01-V00-BatteryManagementSystem.SchDoc, BMS-S02-V00-CellMonitor.SchDoc, BMS-S04-V00-Microcontroller.SchDoc, BMS-S05-V00-Isolation.SchDoc, BMS-S06-V00-IsolatedCAN.SchDoc, BMS-S08-V00-TemperatureSensorInterface.SchDoc, BMS-S09-V00-TemperatureSensors.SchDoc, QUTMS-BMS-V00.PrjPcb]
2020-07-27 Added temp sense strip, dimentions, mating and orientation to be confirmed. Yet to be routed
    [BMS-TEMPSTRIP-P00.PcbDoc, BMS-TEMPSTRIP-S00.SchDoc, BMS-TEMPSTRIP.pcblib, BMS-TEMPSTRIP.schlib, QUTMS-BMS-TEMPSTRIP-V00.PrjPcb, QUTMS_PCBLibrary.PcbLib, QUTMS_PCBLibrary.SchLib, StandardCapacitors.PcbLib]
2020-07-27 Commiting relevant docs on temp sense positioning
    [QUTMS-BMS-TEMPSTRIP-V00.PrjPcb]
2020-07-28 Sent for Manufaturing
    About to send gerbers
    [BMS-TEMPSTRIP-LEFT-P00.PcbDoc, BMS-TEMPSTRIP-LEFT-S00.SchDoc, BMS-TEMPSTRIP-P00.PcbDoc, BMS-TEMPSTRIP-RIGHT-P00.PcbDoc, BMS-TEMPSTRIP-RIGHT-S00.SchDoc, BMS-TEMPSTRIP-S00.SchDoc, BMS-TEMPSTRIP.pcblib, BMS-TEMPSTRIP.schlib]
2020-07-28 BOM and Step file added
    [CellMonitor.SchLib, QUTMS-BMS-V00.xlsx]
2020-09-08 I2C and print added. BUG with makefile. Revert
    [bq769x0.c, bq769x0.h, main.c, main.h]
2020-09-08 Fixed the compiling issue by reinit entire project
    [bq769x0.c, bq769x0.h, main.c]
2020-09-11 i2c bq chip communication working + reading cell voltages
    todo - clean up code + implement all bq functionality
2020-09-15 added reading pack voltage added setting under/over voltage added setting dsg fet
2020-09-24 Removed Routing of CHG and DSG to micro
    Removed connections from CHG and DSG to micro
    [BMS-S01-V00-BatteryManagementSystem.SchDoc]
2020-09-24 Removed Via on nAlarm
    deleted useless trace and via
2020-09-24 Fixed Footprints for C14 and C15
    [BMS-S02-V00-CellMonitor.SchDoc, BMS-S07-V00-PSU.SchDoc, QUTMS-BMS-V00.PrjPcb, StandardCapacitors.SchLib]
2020-09-24 Fixed Oscilator Designators and Footprints
    [BMS-S04-V00-Microcontroller.SchDoc, QUTMS_CrystalLibrary.PcbLib]
2020-09-24 Added 10k Pulldown to Pin 44 Boot on Micro
    [BMS-S04-V00-Microcontroller.SchDoc]
2020-09-24 Fixed pinout for designators on temp sense headers
    [BMS-S09-V00-TemperatureSensors.SchDoc]
2020-09-25 Wired missing 3v3 Connection
    [BMS-S04-V00-Microcontroller.SchDoc, BMS-S07-V00-PSU.SchDoc, QUTMS_PowerSupplyLibrary.PcbLib, QUTMS_PowerSupplyLibrary.SchLib, StandardResistors.SchLib]
2020-09-29 Muxed 3v3 Power with ideal diodes
    [BMS-S01-V00-BatteryManagementSystem.SchDoc, BMS-S02-V00-CellMonitor.SchDoc, BMS-S04-V00-Microcontroller.SchDoc, QUTMS_DiodeLibrary.PcbLib, QUTMS_DiodeLibrary.SchLib, QUTMS_MicrofitLibrary.PcbLib]
2020-09-30 Generated Gerbers Ready for ordering
    [QUTMS-BMS-V00.PrjPcb]
2020-10-01 Changes 1/10
    1. Fixed OSC so controlled by st pin
    2. Renamed Diode CE pin
    3. Renamed 3v3 Mux net to 3v3 MCU
    4. Renamed Diode designators from D to U
    5. Fixed Pinout of Diodes
    6. Fixed Cap on OSC
    7. Fixed designator sizes
    8. Reduced solder mask sliver rule
    9. Fixed unnecessary via
    10. Moved J2 Des
    [BMS-S01-V00-BatteryManagementSystem.SchDoc, BMS-S02-V00-CellMonitor.SchDoc, BMS-S04-V00-Microcontroller.SchDoc, QUTMS_CrystalLibrary.SchLib, QUTMS_DiodeLibrary.SchLib]
2020-10-01 Updated Version
    [BMS-S01-V01-BatteryManagementSystem.SchDoc, BMS-S01-V02-BatteryManagementSystem.SchDoc, BMS-S02-V01-CellMonitor.SchDoc, BMS-S03-V01-CellInterface.SchDoc, BMS-S04-V01-Microcontroller.SchDoc, BMS-S05-V01-Isolation.SchDoc, BMS-S06-V01-IsolatedCAN.SchDoc, BMS-S07-V01-PSU.SchDoc]
2020-10-01 Re-routed oscillator (In V00 by mistake)
    [BMS-S04-V00-Microcontroller.SchDoc, QUTMS-BMS-V00.PrjPcb]
2020-10-01 Added changes from V00 to V01
    [BMS-S01-V01-BatteryManagementSystem.SchDoc, BMS-S02-V01-CellMonitor.SchDoc, BMS-S04-V01-Microcontroller.SchDoc, QUTMS-BMS-V01.PrjPcb]
2020-10-01 Added DIL Switch for Hardwire CAN ID
    [BMS-S04-V01-Microcontroller.SchDoc, QUTMS_STM32Library.SchLib, QUTMS_SwitchLibrary.PcbLib, QUTMS_SwitchLibrary.SchLib]
2020-10-01 Design Rule Check 2
    [QUTMS-BMS-V01.PrjPcb]
2020-10-06 V01 Sent For Manufactoring
    [QUTMS-BMS-V001.PrjPcb, QUTMS-BMS-V01.PrjPcb]
2020-10-14 Deleted v00 prj file
    [QUTMS-BMS-V00.PrjPcb]
2020-10-18 BMS nonRTOS version init
    - All Pin configurations updated as per latest Hardware PDF.
    - A separate README outlining each functionality and Pin configuration has been added.
    - The memory usage so far within 35%-RAM and 64%-FLASH.
    - Print floats has been removed. Overflows by 2KB of RAM.
    + Add function for float prints.
    + Move all functionality.
    + Test 8Mhz External oscillator.
    + Start with implementation of 2 modes for clock.
    [QUTMS_BMS.ioc, can.c, main.c, main.h]
2020-10-18 Corrected BQ and some HAL prints
    [QUTMS_BMS.ioc, main.c]
2020-10-18 Added Primary Loop Procedure
    - The memory usage so far within 41%-RAM and 83%-FLASH.
    - Added code and psudocode for main loop with Voltage, TMPs and UART instead of CAN.
2020-10-18 Raw code has been completed
    Few battery functions were left unimplemented, but they have enough space for them to exist. Balancing and Alarm trigger. Both outlined as psudocode an Readme.
    CAN bus init set and placed. Something else what I forgot, and maybe some another feature to see how much memory can be used. In any case, this is how it will go now, noRTOS in Sync way with no KalmanFilters on-board. What a shame.
2020-11-04 BMS reading all voltages and sending on CAN
2020-11-06 BMS is now reading the hardware ID from dip switches
    reading hardware ID correctly from switches and attaching to CAN messages
    [QUTMS_BMS.ioc, main.c]
2020-11-07 fix implementation of temp sensing
    TODO: still need timer for pulse time
    [QUTMS_BMS.ioc, main.c, main.h]
2020-11-10 redo temp sensing to work with timers
2020-11-10 temperature sensor working with TEMP2 and TEMP3 simultaneously
2020-11-10 output temp + voltages on CAN
2020-11-11 temp4 reading
    need to fix timer prescaler
    [QUTMS_BMS.ioc, main.c, main.h, temp_sensor.c, temp_sensor.h]
2020-11-12 set overvoltage and under voltage
2020-11-15 setup basic error state and heartbeat checks
    [QUTMS_BMS.ioc, bq769x0.c, bq769x0.h, can.c, main.c, main.h]
2020-11-16 fix under and over voltage setting and error handling
    [QUTMS_BMS.ioc, bq769x0.c, main.c, temp_sensor.c]
2020-11-17 fixed sys_stat not clearing on startup
    [main.c, temp_sensor.c]
2020-11-17 adjust temp sensing to flip temp sensor lines
    change lines 1+3 to chains of 4, and 2+4 to chains of 3
    fixed code for reading line 4 to be more accurate (timing issue???)
    [main.c, temp_sensor.c, temp_sensor.h]
2020-11-30 add proper shutdowns on bad voltages
2020-11-30 turn off when failed to init CAN - not connected to AMS
    [main.c]
2020-11-30 update low voltage cutoff to 2.7
2020-12-01 update over and under voltage to be 3.7 and 2.7v
2020-12-03 update temp error to have correct temperature and cell number
    [main.c]
2020-12-03 temporarily adjust under voltage cutoff
2020-12-07 Updated temp sensor code to match new configuration.
2020-12-07 kill completely on error + fiddle with alarm line
    [main.c]
2021-01-21 add oscillator + fix bms not turning on
    fixed CAN causing boards to shutdown due to beign out of sync
    eg would try to start CAN before it was initialiezd on all boards
    [QUTMS_BMS.ioc, can.c, main.c]
2021-02-01 update bms to clock faster
    adjust bms to run off 48mhz clock
    adjust temperature sensor timers to work with 48mhz clock
    restructure main loop
    read voltages every 250ms
    error check voltages over 40 seconds
    run temperature sensing concurrently with other features
    rough balancing code
    [QUTMS_BMS.ioc, bq769x0.c, bq769x0.h, can.c, main.c, main.h, temp_sensor.c, temp_sensor.h]
2021-02-02 fix minor timing issue with temp readings
    update time delay for starting a temp reading
    properly end a temp reading
    [bq769x0.c, bq769x0.h, main.c, main.h, temp_sensor.c, temp_sensor.h]
2021-03-25 added support for additional temperature sensor
    added extra temp sensor for balancing
2021-03-25 updated to check temp5 and log balancing information
    updates balancing information onto CANBus
2021-03-29 update temp4 to use better timer
    altered timer prescaler to match timer2
2021-04-22 fix balancing distribution + temp sending
    [main.c, main.h, temp_sensor.h]
2021-06-11 fix BMS balancing logic to stop being backwards
    [main.c]
2021-06-22 1mbps CAN for BMS
2021-07-26 adjust bms timeout to 5s
2021-08-14 wait until there's a free slot before sending message
    modify BMS_CAN_AddTxMessage to wait for a free slot
2021-09-07 change undervoltage to 2v for sam
2021-11-10 Fix incorrect resister values. Alternate part for mosfet w/ stock
    [BMS-S02-V01-CellMonitor.SchDoc]
