Salmon-Built-Designs/QUTMS_BMS/(notices)

Notices in the files:
software/Core/Src/main.c:
© Copyright (c) 2020 STMicroelectronics.
All rights reserved.
